haxeko/matter-temperature-sensor/README.md

# TH-SENSOR-H2 — nhiệt ẩm kế Matter over Thread (ESP32-H2, 1 × CR2450)

Thiết kế firmware và phần cứng (Rev B) cho một nhiệt ẩm kế không màn hình:

- module **ESP32-H2-MINI-1-H4S** (4 MB flash, anten PCB), **Matter over Thread** (Sleepy End Device, ICD SIT), BLE chỉ dùng khi commissioning;
- cảm biến **SHT40-AD1B-R3** trên một "lưỡi" PCB tách nhiệt, đo mỗi 60 s;
- nguồn **1 × CR2450** (holder SMT): P-MOSFET chống ngược cực, một bộ buck-boost TPS63900 ra 3.3 V, tụ đệm đầu vào 10 µF + 2 × 100 µF + 470 µF;
- một nút USER, một nút RST, một LED; không màn hình.

Firmware dùng ESP-IDF thuần (ESP-Matter chính thức, FreeRTOS, `i2c_master`, ADC có hiệu chuẩn, NVS, power management). PCB là KiCad 9 gốc, 2 lớp, 41.5 × 57.5 mm, sinh hoàn toàn bằng script trong `hardware/scripts/`.

Rev B thay Rev A (2 × CR2032, bo 72 × 58 mm) theo yêu cầu chỉ dùng một pin và bo gọn hơn; Rev A còn trong lịch sử git. Lý do chọn CR2450 thay vì một CR2032: `docs/decisions.md` D20.

Biến thể **TH-SENSOR-H2C Rev A** dùng **chip ESP32-H2FH4S rời** (QFN32) thay cho module: thạch anh 32 MHz, mạng phối hợp RF 0201, **ăng-ten in trên PCB** (inverted-F theo TI DN007), **PCB 4 lớp**, cùng kích thước bo, cùng đường nguồn và cùng firmware. File ở `hardware/chip/`, mô tả và giới hạn ở `docs/chip_variant.md`. Phần RF của biến thể này chưa đo và chưa chỉnh.

Biến thể **TH-SENSOR-H2W Rev A** dùng **module ESP32-H2-WROOM-02C-H4S** (người dùng tự mua và hàn, không có trong BOM JLC) trên một **bo 4 lớp vuông 37.6 × 37.6 mm tính cả phần ăng-ten của module nhô ra ngoài mép trên** (bo 37.6 × 31.6 mm); holder CR2450 ở mặt dưới, tụ đệm C5 là tụ tantal thấp nên cả cụm cao ≈ 12.3 mm (ước tính), một nút USER/BOOT bấm cạnh ở giữa mép trái (không có nút RST), J1 là 6 pad dán; gắn tường với cạnh có nút quay xuống đất (nút bấm từ dưới lên, lưỡi cảm biến ở góc dưới); mạch nguồn, cảm biến và firmware như Rev B. File ở `hardware/wroom/`, mô tả và giới hạn ở `docs/wroom_variant.md`.

Biến thể **TH-SENSOR-H2W-123 Rev A** là bo H2W chạy bằng **một pin CR123A** (1550 mAh) thay cho CR2450. Pin **không nằm trên bo**: bo chỉ mang phần mạch, **2 lớp**, **24.8 × 37.3 mm** (43.3 mm tính cả ăng-ten), pin đặt cạnh bo trong đế riêng và nối bằng hai dây; đặt cạnh một đế pin 18.2 × 43.3 mm thì cả cụm khoảng 43.3 × 43.3 mm. Không có tụ đệm 470 µF, có cầu chì tự phục hồi; pad nạp và test pad ở mặt sau; gắn tường với ăng-ten hướng lên, cảm biến và nút ở cạnh dưới. Theo mô hình (ƯỚC TÍNH), pin này cấp được mọi xung tải ở mọi trạng thái và cho tuổi thọ khoảng 2.3–2.6 năm. Pin sát bo chỉ cách ăng-ten khoảng 7 mm: tầm phủ CHƯA KIỂM THỬ. Chi tiết: `docs/cr123a_variant.md`.

## Trạng thái — đọc trước

Nhãn dùng trong toàn bộ repo: **ĐÃ XÁC MINH** (kiểm bằng công cụ hoặc đọc từ tài liệu gốc), **ƯỚC TÍNH** (tính toán/mô phỏng), **CHƯA KIỂM THỬ** (chưa có phần cứng).

| Hạng mục | Trạng thái | Bằng chứng |
|---|---|---|
| Firmware build: `battery`, `debug`, `battery` + lớp phủ sản xuất `prod`, `battery` + `cr123a`, `debug` + `cr123a` | ĐÃ XÁC MINH (ESP-IDF v5.5.5, 0 cảnh báo trong mã dự án; lần 2026-10-30 build sạch từ bản clone, lần 2026-11-11 build lại toàn bộ trong cây làm việc) | `docs/reports/firmware_build.md` |
| Firmware chạy trên chip (mọi profile; prod còn cần dữ liệu factory riêng từng máy) | **CHƯA KIỂM THỬ** | `docs/test_plan.md` |
| Unit test logic thuần trên host | ĐÃ XÁC MINH: 43 test, 264 kiểm tra, 0 lỗi | `docs/reports/host_tests.txt` |
| ERC schematic | ĐÃ XÁC MINH: 0 lỗi, 0 cảnh báo | `hardware/reports/erc_report.txt` |
| DRC PCB + schematic parity | ĐÃ XÁC MINH: 0 vi phạm, 0 pad chưa nối, 0 lỗi parity | `hardware/reports/drc_report.txt` |
| Pin map firmware ↔ schematic | ĐÃ XÁC MINH | `tools/check_pinmap.py`, `docs/pinmap.md` |
| Gerber, drill, BOM, CPL (định dạng JLC) | ĐÃ XÁC MINH là sinh được từ board; **chưa gửi nhà máy** | `hardware/production/` |
| Năng lượng, tuổi thọ pin | ƯỚC TÍNH — **CHƯA ĐẠT** | `docs/power_budget.md` |
| Điện, RF, cảm biến, Matter, dòng ngủ trên bo thật | **CHƯA KIỂM THỬ** (chưa có bo nào được làm) | `docs/test_plan.md` |
| OTA | **không triển khai** (`CONFIG_ENABLE_OTA_REQUESTOR=n`) | |
| Chứng nhận (Matter, FCC/CE, an toàn pin) | **không tuyên bố** | |
| Biến thể chip rời H2C: ERC, DRC + parity, pin map | ĐÃ XÁC MINH: 0 lỗi, 0 cảnh báo; 0 vi phạm, 0 pad chưa nối, 0 lỗi parity | `hardware/chip/reports/`, `tools/check_pinmap.py --variant chip` |
| Biến thể chip rời H2C: ăng-ten, phối hợp RF, thạch anh | **CHƯA KIỂM THỬ** — giá trị RF chỉ là giá trị khởi đầu, cần VNA để chỉnh | `docs/chip_variant.md` |
| Biến thể WROOM-02C H2W: ERC, DRC + parity, pin map | ĐÃ XÁC MINH: 0 lỗi, 0 cảnh báo; 0 vi phạm, 0 pad chưa nối, 0 lỗi parity | `hardware/wroom/reports/`, `tools/check_pinmap.py --variant wroom` |
| Biến thể WROOM-02C H2W: hàn tay module, ăng-ten trên bo này, ảnh hưởng của pin ở mặt dưới, hướng gắn tường | **CHƯA KIỂM THỬ** | `docs/wroom_variant.md` |
| Biến thể CR123A H2W-123: ERC, DRC + parity, pin map | ĐÃ XÁC MINH: 0 lỗi, 0 cảnh báo; 0 vi phạm, 0 pad chưa nối, 0 lỗi parity | `hardware/wroom123/reports/`, `tools/check_pinmap.py --variant wroom123` |
| Biến thể CR123A H2W-123: khả năng cấp xung và tuổi thọ pin | ƯỚC TÍNH (mô hình khớp theo đồ thị datasheet) | `hardware/analysis/results/cr123a_summary.md` |
| Biến thể CR123A H2W-123: ăng-ten khi pin cách module ~7 mm, đấu dây pin, phần trăm pin, mọi phép đo | **CHƯA KIỂM THỬ** | `docs/cr123a_variant.md` |

Chưa có đơn đặt PCB hay linh kiện nào. Chưa đo dòng, chưa ghép Matter với controller nào.

## Cảnh báo chính

1. **Thiết kế nguồn CHƯA ĐẠT** (ƯỚC TÍNH): theo mô hình, với CR2450 mới ở 25 °C mọi tải đều ổn, nhưng **khởi động và commissioning bị reset khi pin đã dùng khoảng một nửa** hoặc khi ≤ 0 °C (ngay cả pin mới). Từ giữa đời, một lần reset bất kỳ có thể làm thiết bị ngừng hoạt động tới khi thay pin; report hỏng khi pin gần cuối đời. Commission bằng pin mới ở nhiệt độ phòng. Tuổi thọ ở ~64 µA trung bình: **khoảng 0.55–0.77 năm, không phải 1–2 năm**. Điện trở xung của CR2450 là ước tính (không có số liệu công bố) và là rủi ro lớn nhất — đo trước khi làm nhiều bo (T-35). Phương án dự phòng (chưa áp dụng): `docs/power_budget.md` mục 7. Thiết kế không tự đổi sang pin khác.
2. **ESP32-H2-MINI-1-H4S tồn kho JLC = 0** (tra ngày 2026-10-29 và 2026-10-30) — chặn lắp ráp toàn bộ tại JLC; xem `docs/assembly.md`. Footprint holder CR2450 là footprint tự vẽ theo bản vẽ của nhà sản xuất: so với holder thật trước khi đặt PCB.
3. **Dữ liệu Matter thử nghiệm**: bản build mặc định dùng VID 0xFFF1 / PID 0x8000, passcode 20202021, discriminator 3840, DAC thử nghiệm — chỉ để phát triển, không bao giờ giao thiết bị như vậy.
4. **Không giả định** Apple Home, Google Home, Alexa, SmartThings, Home Assistant… sẽ chấp nhận firmware tự build này; thử lần đầu bằng `chip-tool` + OpenThread Border Router (`docs/commissioning.md`).
5. **Không bao giờ sao chép** toàn bộ flash/NVS, Thread dataset hay thông tin xác thực giữa các thiết bị.
6. **Biến thể chip rời (H2C)**: ESP32-H2FH4S tồn kho JLC = 0 (tra 2026-11-06); ăng-ten PCB và mạng phối hợp chưa mô phỏng, chưa đo — phải chỉnh bằng VNA trên bo thật; bo này không còn chứng nhận RF sẵn có của module. Xem `docs/chip_variant.md`.
7. **Biến thể WROOM-02C (H2W)**: module **không có trong BOM/CPL** (người dùng tự mua bản -H4S và hàn tay; pad tản nhiệt hàn qua lỗ 0.8 mm từ mặt dưới); holder ở **mặt dưới** (lắp ráp hai mặt hoặc tự hàn holder); dưới pin có via phủ mask. Xem `docs/wroom_variant.md`.
8. **Chỉ dùng CR2450, không sạc** (silkscreen mặt trên: "CR2450 ONLY" / "NO CHARGE" phía trên holder, dấu + và − ở hai đầu holder; mặt dưới: "CR2450 ONLY - NO CHARGE"; bản H2W: cả hai dòng và dấu +/− ở mặt dưới, cạnh holder). **Không bao giờ cấp nguồn bench khi pin đang nằm trong holder** — bo không có diode hay điện trở bảo vệ nối tiếp; xem `docs/limitations.md` mục 3.

## Sơ đồ khối

```
CR2450 ─ R1 0R ─ Q1 AO3401A ─ VIN ─ U1 TPS63900 (3.3 V) ─ VOUT ─ R21 0R ─ +3V3
 (BT1)  (đo dòng) (chống ngược)  │                         │     (đo dòng tải)
                       10 µF + 2 × 100 µF + 470 µF     22 µF + 2 × 100 µF

+3V3 ─┬─ U4 ESP32-H2-MINI-1-H4S ── I2C (GPIO10/11) ── U5 SHT40 (trên lưỡi tách nhiệt)
      ├─ U3 TPS3839K33 (2.93 V) ─ R22 ─ EN ── SW2 RST, TP6
      └─ LED (GPIO22), SW1 USER/BOOT (GPIO9), J1 debug (UART0, USB D+/D−; không có chân nguồn)
VBAT ─ 470k/470k (2N7002 đóng bằng GPIO12) ─ ADC1_CH4 (GPIO5)
```

Chi tiết và lý do chọn kiến trúc: `docs/architecture.md`, `docs/decisions.md`.

## Cấu hình linh kiện chính

| Linh kiện | Cấu hình | Nguồn |
|---|---|---|
| BT1 MYOUNG BS-24-B4AA016 | holder SMT CR2450, tiếp điểm mạ vàng; pad 1 = + (phải); footprint dự án theo bản vẽ MY-CP-0138 | datasheet LCSC C964809 |
| U1 TPS63900 | SEL = GND ⇒ VO(1) = 3.3 V (RCFG3 16.2 kΩ); RCFG1 0 Ω + RCFG2 10.5 kΩ ⇒ giới hạn dòng vào trung bình 100 mA; EN = VIN; L 2.2 µH Murata DFE201612E; vào 10 µF + 2 × 100 µF + C5 470 µF điện phân, ra 22 µF | TI SLVSET3D, bảng 7-2/7-3 |
| Q1 AO3401A | P-MOSFET chống lắp ngược cell: D phía cell, S phía VIN, G nối GND | |
| U3 TPS3839K33 | ngưỡng 2.93 V, trễ 200 ms, đẩy-kéo, qua R22 10 kΩ tới EN; C25 1 µF | TI SBVS193D |
| U5 SHT40-AD1B-R3 | I2C địa chỉ 0x44, 100 kHz, kéo lên 10 kΩ; lệnh đo độ lặp cao (0xFD), có kiểm CRC; không bật heater khi đo | Sensirion SHT4x v7.3 |
| Cầu chia pin | 470 kΩ / 470 kΩ + 22 nF từ cực + của holder, công tắc 2N7002 phía thấp; GPIO12 bật ~30 ms mỗi 6 h | |
| Y1 | 32.768 kHz Epson FC-135 (CL 12.5 pF), tụ tải 18 pF — ƯỚC TÍNH, chỉnh ở T-09 | |
| U4 | pin map đầy đủ (pad module ↔ GPIO ↔ net), chân strap, chân không dùng | `docs/pinmap.md` |

## Cấu trúc repo

```
firmware/                    dự án ESP-IDF (target esp32h2)
  main/                      app_main.cpp, app_controller.c, Kconfig.projbuild
  components/                sht40, battery, board, user_button, matter_bridge,
                             power_guard, app_config, maint_console, app_logic
  test/host/                 unit test chạy trên máy host
  sdkconfig.defaults(.battery|.debug|.prod), partitions.csv, dependencies.lock
hardware/
  scripts/                   design.py (BOM + netlist nguồn), gen_schematic.py, gen_pcb.py, gen_pcb_chip.py,
                             gen_pcb_wroom.py, gen_pcb_wroom123.py, router.py, gen_project.py, gen_reports.py,
                             gen_production.py
  kicad/                     th_sensor_h2.kicad_sch / .kicad_pcb / .kicad_pro, thư viện riêng (lib/)
  production/                Gerber + drill (zip), BOM/CPL JLC, bản vẽ lắp ráp, trở ngại sản xuất
  reports/                   ERC, DRC, routing log, tóm tắt
  renders/                   schematic.pdf, ảnh PCB (SVG, 3D PNG)
  analysis/                  power_model.py và kết quả mô phỏng
  chip/                      biến thể chip rời H2C: kicad/, production/, reports/, renders/
  wroom/                     biến thể WROOM-02C H2W: kicad/, production/, reports/, renders/
  wroom123/                  biến thể CR123A H2W-123: kicad/, production/, reports/, renders/
tools/                       check_pinmap.py, jlc_lookup.py
docs/                        tài liệu thiết kế (danh sách bên dưới), docs/reports/
```

## Firmware

### Khóa phiên bản

| Thành phần | Phiên bản | Khóa ở đâu |
|---|---|---|
| ESP-IDF | v5.5.5 (toolchain riscv32-esp-elf GCC 14.2.0, esp-14.2.0_20260121) | `firmware/main/idf_component.yml` (`idf: ==5.5.5`) |
| espressif/esp_matter | 1.6.0~1 | `idf_component.yml` (`==`), phiên bản + hash đầy đủ trong `firmware/dependencies.lock` |
| espressif/button | 4.2.1 | như trên |
| KiCad | 9.0.9 (phần cứng) | `docs/sources.md` |

Đổi bất kỳ phiên bản nào ở trên là một thay đổi thiết kế: build lại mọi cấu hình và chạy lại unit test.

### Cài toolchain

```sh
git clone -b v5.5.5 --recursive https://github.com/espressif/esp-idf.git ~/esp/esp-idf-v5.5.5
cd ~/esp/esp-idf-v5.5.5 && ./install.sh esp32h2
```

Component manager tự tải `espressif/esp_matter`, `espressif/button` và các phụ thuộc theo `firmware/dependencies.lock` ở lần build đầu (cần mạng); không cần checkout ESP-Matter riêng. Đã dùng CMake 3.28 và Ninja 1.11.

### Build, nạp, monitor

```sh
. ~/esp/esp-idf-v5.5.5/export.sh
cd firmware
P=battery                                    # hoặc: debug
idf.py -B build_$P -D SDKCONFIG=build_$P/sdkconfig \
       -D SDKCONFIG_DEFAULTS="sdkconfig.defaults;sdkconfig.defaults.$P" build
idf.py -B build_$P -D SDKCONFIG=build_$P/sdkconfig \
       -D SDKCONFIG_DEFAULTS="sdkconfig.defaults;sdkconfig.defaults.$P" -p /dev/ttyACM0 flash monitor
```

| Profile | Dùng khi | Khác biệt |
|---|---|---|
| `battery` | chạy bằng pin | log WARN, power guard bật |
| `debug` | bring-up bằng nguồn bench | log INFO, power guard tắt |
| `prod` (lớp phủ thêm sau `battery`) | sản xuất, cần dữ liệu factory riêng từng máy | build được; chạy CHƯA KIỂM THỬ — `docs/commissioning.md` mục 5 |
| `cr123a` (lớp phủ thêm sau `battery` hoặc `debug`) | bo H2W-123 chạy pin CR123A | bảng phần trăm, chuỗi IEC/dung lượng và ngưỡng pin của CR123A — `docs/cr123a_variant.md` mục 7 |

Nạp firmware qua USB-Serial/JTAG trên J1 (D+, D−, GND; 1×6 pad không lắp sẵn). J1 không có chân nguồn: bo phải chạy bằng pin, hoặc **tháo pin** rồi cấp 3.0 V (giới hạn ~150 mA) vào TP1 (VBAT, +) và TP5 (GND). Vào chế độ download bằng tay: giữ USER (SW1, GPIO9) trong khi nhấn và thả RST (SW2). Trên thiết bị đã có dữ liệu factory, **không** chạy `idf.py erase-flash` (xóa luôn phân vùng `fctry` và `esp_secure_cert`).

### Nút và LED

| Thao tác nút USER | Hành động | LED |
|---|---|---|
| Nhấn ngắn | đo ngay (tối đa 1 lần / 5 s) | 1 nháy nếu đo được, 2 nháy dài nếu lỗi |
| Nhấn 3 lần trong 2 s | mở cửa sổ commissioning 180 s, **giữ nguyên các fabric**; nếu thiết bị đã bị gỡ khỏi mọi ứng dụng thì tự khởi động lại rồi quảng bá BLE 180 s | 3 nháy |
| Giữ ≥ 10 s rồi thả | factory reset (fabric, Thread, cấu hình app; không xóa dữ liệu factory) | sáng liên tục khi đủ 10 s, 8 nháy khi chấp nhận |
| Giữ ≥ 60 s | coi là kẹt nút, không reset | tắt |

LED nháy chậm 3 lần rồi tắt hẳn ngay sau khi lắp pin hoặc reset: thiết bị vừa bị reset hai lần liên tiếp trước khi chạy đủ 10 phút (hoặc pin < 2.4 V) và đang ngủ sâu 5 phút … 4 giờ để tránh vòng lặp sụt áp. **Nhấn USER để đánh thức ngay.**

Chi tiết: `docs/architecture.md` mục 4.4.

### Console bảo trì (USB-Serial/JTAG)

`status` (cảm biến, pin, Matter/Thread, power guard, heap), `measure`, `battery`, `config` / `config set <key> <value>` (khóa: `temp_offset`, `rh_offset`, `meas_interval`, `bat_interval`, `temp_deadband`, `rh_deadband`, `led`, `tx_power`; chỉ ghi NVS khi giá trị đổi), `heater <20|110> <100|1000>` (xung heater để bảo trì; số đo lúc nóng không được phát; phép đo thường không bao giờ bật heater), `window`, `factory_reset confirm`, `reboot`. Khi USB đang nối, chip không vào light sleep (có chủ đích): rút USB khi đo dòng ngủ.

### Ghép Matter (tóm tắt, CHƯA KIỂM THỬ trên thiết bị)

1. Chuẩn bị một OpenThread Border Router và `chip-tool`; lấy active operational dataset (hex) của mạng Thread.
2. Dùng **CR2450 mới ở nhiệt độ phòng**, hoặc nguồn bench vào TP1/TP5 sau khi tháo pin (mô hình dự đoán reset khi commissioning với pin đã dùng một nửa hoặc khi lạnh).
3. Thiết bị chưa có fabric quảng bá BLE 180 s sau khi khởi động; quá thời gian thì nhấn USER 3 lần.
4. Với dữ liệu thử nghiệm của bản build mặc định:
   ```sh
   chip-tool pairing ble-thread 1 hex:<dataset> 20202021 3840
   chip-tool temperaturemeasurement read measured-value 1 1
   chip-tool relativehumiditymeasurement read measured-value 1 2
   chip-tool powersource read bat-voltage 1 0
   ```
5. Thêm hệ sinh thái thứ hai: nhấn USER 3 lần (giữ fabric cũ) hoặc dùng chức năng chia sẻ của controller đầu tiên.

Reset: nút RST = reset phần cứng (EN); factory reset = giữ USER ≥ 10 s rồi thả, hoặc `factory_reset confirm`. Chi tiết, xử lý sự cố, dữ liệu sản xuất: `docs/commissioning.md`.

### Unit test trên host

```sh
cmake -S firmware/test/host -B build/host-tests
cmake --build build/host-tests
ctest --test-dir build/host-tests --output-on-failure
```

## Phần cứng

Cần: KiCad **9.0** có module Python `pcbnew` và `kicad-cli` (đã dùng 9.0.9), Python 3 với numpy. Thư viện chuẩn của KiCad đọc từ `/usr/share/kicad/`. Symbol, footprint, mô hình 3D của module lấy từ thư viện Espressif và đã được sao vào `hardware/kicad/lib/`; chỉ cần bản checkout thư viện đó (biến `ESPRESSIF_KICAD_LIB`) khi muốn làm mới các bản sao.

Tái tạo toàn bộ, theo thứ tự (chạy từ gốc repo):

```sh
python3 hardware/scripts/gen_schematic.py    # schematic, thư viện dự án, kiểm parity với design.py
python3 hardware/scripts/gen_pcb.py          # đặt linh kiện, đi dây (router.py), đổ đồng, silkscreen (~20 s)
python3 hardware/scripts/gen_project.py      # .kicad_pro: luật thiết kế JLC 2 lớp, net class
python3 hardware/scripts/gen_reports.py      # ERC, DRC + parity, PDF/SVG/3D
python3 hardware/scripts/gen_production.py   # Gerber, drill, BOM, CPL, bản vẽ lắp ráp
python3 tools/check_pinmap.py                # board_pins.h ↔ netlist
```

Chạy lại chuỗi trên cho ra schematic và board **giống từng byte**; chỉ dấu thời gian trong Gerber/drill/báo cáo/PDF/ZIP và ảnh render 3D thay đổi.

Biến thể chip rời: cùng chuỗi với biến môi trường `TH_VARIANT=chip` và `gen_pcb_chip.py` thay cho `gen_pcb.py`; kết quả ghi vào `hardware/chip/` (`docs/chip_variant.md` mục 11). Biến thể WROOM-02C: `TH_VARIANT=wroom` và `gen_pcb_wroom.py`; kết quả ở `hardware/wroom/` (`docs/wroom_variant.md` mục 11). Biến thể CR123A: `TH_VARIANT=wroom123` và `gen_pcb_wroom123.py`; kết quả ở `hardware/wroom123/` (`docs/cr123a_variant.md` mục 10). Không đặt biến thì mọi script sinh Rev B như trước.

### Bring-up và đo dòng

Điểm đo trên bo (silkscreen ghi tên net): VBAT (cực + của cell), VIN (sau P-MOSFET), VOUT (ra bộ chuyển đổi), 3V3, GND, EN; BOOT ở J1 chân 5. Link đo dòng: R1 (dòng cell), R21 (tải 3V3), đều là 0R 0805. Với một cell, "VBAT1/VBAT2/VBAT_OR" của yêu cầu gốc thu lại thành VBAT (TP1) và VIN (TP2).

1. **Trước khi lắp pin** (T-01…T-08): kiểm ngắn mạch; tháo R21; cấp nguồn bench có giới hạn dòng vào TP1; kiểm VOUT = 3.30 V; thử ngược cực và dòng ngược; kiểm supervisor (nRST, EN); so footprint holder với holder thật và kiểm cực bằng một cell (rồi tháo cell ra).
2. Hàn lại R21, nạp firmware `debug`, chạy `status`, `measure`, `battery` (T-09…T-17).
3. Commissioning và kiểm Matter (T-20…T-25).
4. **Đo dòng** (T-30…T-39): tháo R21 (dòng tải 3V3) hoặc R1 (dòng cell), nối máy đo dòng lấy mẫu nhanh (PPK2, Joulescope…) vào hai pad, **rút USB** (USB-Serial/JTAG giữ chip thức). Đo đáy ngủ, điện tích mỗi poll/report, dạng dòng khởi động và commissioning, điện trở xung của CR2450 (T-35, nên làm sớm nhất), dòng rò tụ điện phân, dòng trung bình 24 h; rồi chạy lại `power_model.py` với số đo và cập nhật `docs/power_budget.md`.

Tiêu chí đạt và thứ tự đầy đủ: `docs/test_plan.md`.

Mô hình năng lượng: `python3 hardware/analysis/power_model.py --plots` (~6 phút). Tra lại tồn kho JLC trước khi đặt: `python3 tools/jlc_lookup.py --json <mã LCSC…>` (endpoint không chính thức của trang jlcpcb.com/parts).

## Tài liệu

| File | Nội dung |
|---|---|
| `docs/architecture.md` | sơ đồ khối, đường nguồn, firmware, data model Matter, ICD, nút/LED |
| `docs/pinmap.md` | bảng chân module ↔ net ↔ GPIO (sinh bằng `check_pinmap.py --markdown`), J1 |
| `docs/power_budget.md` | ngân sách dòng, tuổi thọ 25/50/100/200 µA, mô phỏng xung, tụ đệm, chế độ hỏng, phương án dự phòng |
| `docs/decisions.md` | các quyết định thiết kế và lý do (D1–D22; D20 = Rev B, một CR2450; D21 = biến thể chip rời; D22 = biến thể WROOM-02C) |
| `docs/chip_variant.md` | biến thể chip rời H2C: khác biệt, đối chiếu HDG, ăng-ten, phối hợp RF, stack-up 4 lớp, kiểm thử C-01…C-08 |
| `docs/cr123a_variant.md` | biến thể CR123A H2W-123: vì sao CR123A (mô hình), bo 24.8 × 37.3 mm với pin nằm ngoài bo, nối pin và cầu chì, lớp cấu hình firmware, kiểm thử K-01…K-08 |
| `docs/wroom_variant.md` | biến thể WROOM-02C H2W: kích thước vuông, vị trí module theo HDG, holder mặt dưới, C5 tantal, hướng gắn tường, hàn tay module, nút bấm cạnh, kiểm thử W-01…W-08 |
| `docs/commissioning.md` | ghép Matter, cửa sổ commissioning, factory reset, dữ liệu sản xuất |
| `docs/assembly.md` | file sản xuất, kiểm tra preview JLC, lắp tay, link đo dòng |
| `docs/test_plan.md` | kế hoạch bring-up và kiểm thử T-01…T-42 |
| `docs/limitations.md` | giới hạn và rủi ro đã biết |
| `docs/sources.md` | datasheet, tài liệu và phiên bản công cụ đã dùng |
| `docs/reports/` | báo cáo build firmware, kết quả unit test |
| `hardware/reports/` | ERC, DRC, routing log |

## Giấy phép

Chưa chọn giấy phép cho dự án (quyết định của chủ repo). Symbol, footprint và mô hình 3D ESP32-H2-MINI-1 trong `hardware/kicad/lib/`, cùng symbol ESP32-H2 và footprint QFN32 trong `hardware/chip/kicad/lib/`, lấy từ thư viện KiCad của Espressif và theo giấy phép của thư viện đó (`LICENSE-espressif-kicad-libraries.md` trong từng thư mục). Symbol và footprint ESP32-H2-WROOM-02C trong `hardware/wroom/kicad/lib/` do `gen_schematic.py` vẽ theo datasheet của module.
