haxeko/matter-temperature-sensor/hardware/wroom123/reports/drc_report.txt

** Drc report for th_sensor_h2w123.kicad_pcb **
** Created on 2026-11-11T07:16:01+0000 **
** Report includes: Errors, Warnings, Exclusions **

** Found 0 DRC violations **

** Found 0 unconnected pads **

** Found 0 Footprint errors **

** End of Report **
