haxeko/matter-temperature-sensor/hardware/wroom123/reports/summary.md

# Check summary

Generated 2026-11-11 07:16 UTC by `hardware/scripts/gen_reports.py` with kicad-cli 9.0.9.

| Check | Result | Report |
|---|---|---|
| ERC (all severities) | 0 messages, 0 errors, 0 warnings | erc_report.txt |
| DRC (all severities) | 0 violations | drc_report.txt |
| DRC unconnected pads | 0 | drc_report.txt |
| Schematic parity (footprints vs schematic) | 0 footprint errors | drc_report.txt |

Routing log: routing_log.txt (gen_pcb.py). These are design-rule checks only; no board has been made or tested.
