haxeko/matter-temperature-sensor/hardware/wroom123/production/orientation_check.md

# Orientation check for the JLC placement preview

Generated by `hardware/scripts/gen_production.py` from the board file. Board viewed from the top,
X to the right, Y up (CPL convention). For each polarised part the offset of pad 1 from the part
centre is given; in the JLC preview the pin-1 / polarity mark of the part model must sit on that
side. If it does not, correct the rotation in JLC's tool (not in KiCad) and record it here.

| Ref | Value | KiCad rotation | Pad 1 | Pad 1 direction | Pad 1 offset X, Y (mm) |
|---|---|---|---|---|---|
| D3 | red | 90 | pad 1 = cathode | down | 0.00, -0.79 |
| Q1 | AO3401A | 180 | pin 1 (gate) | right / down | 0.94, -0.95 |
| Q3 | 2N7002 | 180 | pin 1 (gate) | right / down | 0.94, -0.95 |
| U1 | TPS63900DSKR | 90 | pin 1 | left / down | -1.00, -1.21 |
| U3 | TPS3839K33DBZR | 0 | pin 1 | left / up | -0.94, 0.95 |
| U5 | SHT40-AD1B-R3 | 180 | pin 1 | right / down | 0.70, -0.40 |
