haxeko/matter-temperature-sensor/docs/sources.md

# Nguồn tài liệu

Phiên bản tài liệu là bản đã đọc khi thiết kế (2026-10). Đường dẫn của nhà sản xuất có thể đổi; tên và mã phiên bản là thứ cần đối chiếu.

## Espressif

| Tài liệu | Phiên bản | Dùng cho |
|---|---|---|
| ESP32-H2-MINI-1 & MINI-1U Datasheet — https://www.espressif.com/sites/default/files/documentation/esp32-h2-mini-1_mini-1u_datasheet_en.pdf | v1.6 | sơ đồ chân module (bảng 3), vùng keepout anten trên module, dòng TX/RX, kích thước |
| ESP32-H2 Series Datasheet — https://www.espressif.com/sites/default/files/documentation/esp32-h2_datasheet_en.pdf | v1.3 | chân strap (GPIO8/9/25), GPIO25 không có pull nội (mục 3.3), ADC1 |
| ESP32-H2 Hardware Design Guidelines — https://docs.espressif.com/projects/esp-hardware-design-guidelines/en/latest/esp32h2/ | bản "latest" 2026-10 | vị trí module và vùng keepout anten (hình "Keepout Zone ... feed point on the left"), thạch anh, USB, UART |
| ESP-Matter `examples/icd_app` — https://github.com/espressif/esp-matter/tree/main/examples/icd_app | esp_matter 1.6.0~1 | cấu hình ICD SIT, số đo dòng ngủ/poll của Espressif |
| Espressif KiCad libraries — https://github.com/espressif/kicad-libraries | git dd76561812ab300351234ba6e0ec1295641796f0 | symbol, footprint, mô hình 3D ESP32-H2-MINI-1 (CC-BY-SA 4.0 với ngoại lệ cho thiết kế; bản sao + license trong `hardware/kicad/lib/`); **H2C**: symbol "ESP32-H2" và footprint QFN-32-1EP_4x4mm_P0.4mm_EP2.9x2.9mm (bản sao trong `hardware/chip/kicad/lib/`) |
| ESP32-H2-WROOM-02C Datasheet — https://espressif.com/sites/default/files/documentation/esp32-h2-wroom-02c_datasheet_en.pdf | v1.2, đọc 2026-11-06 | **H2W**: bảng 2 (định nghĩa chân), hình 6 (kích thước, ăng-ten 6 mm, feed bên phải), hình 7 (land pattern, pad tản nhiệt), chương 8 (sơ đồ module: VBAT–3V3 qua 0 Ω, EN không có RC, TXD0 499 Ω), chương 9 (sơ đồ ngoại vi: 10 µF + 0.1 µF ở 3V3), mã -H2S/-H4S, MSL 3, reflow |
| ESP32-H2 Hardware Design Guidelines, mục "Positioning a Module on a Base Board" — https://docs.espressif.com/projects/esp-hardware-design-guidelines/en/latest/esp32h2/pcb-layout-design.html | bản "latest", đọc 2026-11-06 | **H2W**: ăng-ten module đặt ngoài bo, feed gần mép bo; hình "antenna feed point on the right" (vị trí ③ và ④ được đánh dấu ✓); via GND dày gần ăng-ten; ≥ 15 mm khoảng trống quanh ăng-ten trong vỏ; UART/USB xa ăng-ten |
| ESP32-H2 Hardware Design Guidelines, chương "Schematic Checklist" và "PCB Layout Design" — cùng địa chỉ | v1.6 (2025-06-05), đọc 2026-11-06 | **H2C**: tụ decoupling từng chân, thạch anh 32 MHz ±10 ppm + 24 nH, mạng CLC(CL) 0201 và stub 15 mil / 100 Ω, đường RF 50 Ω, stack-up 4 lớp, ≥ 9 via pad đáy, UART 499 Ω, USB 90 Ω |

## Texas Instruments

| Tài liệu | Phiên bản | Dùng cho |
|---|---|---|
| TPS63900 datasheet — https://www.ti.com/lit/ds/symlink/tps63900.pdf | SLVSET3D (10/2020) | chân, bảng cấu hình RCFG (7-2, 7-3), UVLO, giới hạn dòng vào, ví dụ layout (hình 10-1), land pattern DSK |
| TPS3839 datasheet — https://www.ti.com/lit/ds/symlink/tps3839.pdf | SBVS193D (07/2015) | ngưỡng K33 2.93 V, trễ 200 ms, 150 nA |
| SWRA349 "Coin cells and peak current draw" — https://www.ti.com/lit/an/swra349/swra349.pdf | — | điện trở xung CR2032 theo mức xả (hình 6, cơ sở cho CR2450 sau khi nhân tỉ lệ diện tích), công thức tụ đệm |
| Application Report "2.4-GHz Inverted F Antenna" (DN007) — https://www.ti.com/lit/an/swru120d/swru120d.pdf | SWRU120D (sửa đổi 01/2019) | **H2C**: hình học ăng-ten IFA (Figure 1-1, Table 1-1; hai chân đất và đoạn feed 45° đo từ hình); bo tham chiếu FR-4 dày 1 mm; khuyến nghị mạng pi sát điểm feed |

## Pin và holder

| Tài liệu | Phiên bản | Dùng cho |
|---|---|---|
| Panasonic CR2450 — https://energy.panasonic.com/na/business/products/lithium/coin-cr-standard/models/CR2450 (datasheet PDF `CR2450_Datasheet_EN.pdf` trên trang) | 2026 | **Rev B**: 3 V, 620 mAh, dòng liên tục 0.2 mA, Ø24.5 × 5.0 mm, 6.2 g, −30…+85 °C; đường "capacity vs load"; đường kính trong trên bản vẽ (tỉ lệ diện tích dùng trong mô hình) |
| Panasonic CR2032 — https://energy.panasonic.com/na/business/products/lithium/coin-cr-standard/models/CR2032 (datasheet PDF trên trang) | 2026 | 3 V, 225 mAh, dòng liên tục 0.2 mA, −30…+85 °C, đường điện áp theo tải và nhiệt độ (cơ sở của mô hình cell; Rev A) |
| Panasonic Lithium Handbook (trang tải: https://energy.panasonic.com/eu/business/downloads/material) | 2025 | diode chặn ngược + điện trở bảo vệ khi cell có thể bị nạp, tổng điện tích nạp ≤ 3 % dung lượng với coin cell |
| MYOUNG BS-24-B4AA016 — datasheet trên LCSC: https://www.lcsc.com/datasheet/lcsc_datasheet_2012181809_MYOUNG-BS-24-B4AA016_C964809.pdf | bản vẽ MY-CP-0138 (2018-05-30) | **Rev B**: holder SMT CR2450, kích thước thân, land pattern (footprint dự án), cực +; −25…+85 °C, tiếp điểm đồng phosphor mạ vàng (mô tả LCSC). **H2W**: land pattern 37.00 mm quyết định bề rộng bo; hình cắt (pin nằm trên đáy nhựa của holder) là cơ sở cho via dưới pin |
| KNSCHA RVT 470 µF 6.3 V (RVT470UF6.3V67RV0038) — datasheet trên LCSC: https://wmsc.lcsc.com/wmsc/upload/file/pdf/v2/lcsc/2109301630_KNSCHA-RVT470UF6-3V67RV0038_C2901342.pdf | — | **Rev B**: tụ đệm C5, Ø6.3 × 7.7 mm, ±20 %, 2000 h ở 105 °C, dòng rò ≤ 0.01 CV hoặc 3 µA sau 2 phút ở điện áp định mức |
| Kyocera AVX TAJ Series (Standard and Low Profile Tantalum Capacitors) — https://datasheets.kyocera-avx.com/TAJ.pdf | TDS-PTNO-0024 Rev 3, đọc 2026-11-08 | **H2W**: tụ đệm C5 TAJD477K006RNJ (LCSC C7229): vỏ D 7343-31 7.30 × 4.30 × 2.90 mm (chiều cao +0.20/−0.10), 470 µF ±10 %, 6.3 V tới 85 °C, DCL ≤ 28 µA (điện áp định mức, sau 5 phút), DF ≤ 12 %, ESR ≤ 0.4 Ω ở 100 kHz, MSL 1 (khuyên dùng bản dry pack), vạch cực = anode (+), −55…+125 °C, ΔC/C +0/−10 % ở −55 °C |
| Keystone 1060 (catalog coin cell holders) | catalog M65 | holder CR2032 của Rev A (không còn dùng) |
| Panasonic CR123A (CR Cylindrical-type Lithium Battery, Standard type) — https://energy.panasonic.com/dam/master/pdf/en/datasheet/lithium/CR123A_Datasheet_EN.pdf | July 2024, đọc 2026-11-10 | **H2W-123**: 3 V, 1550 mAh, dòng liên tục chuẩn 20 mA, Ø17.0 × 34.5 mm, ≈ 16 g, −40…+70 °C; đồ thị xả liên tục 20 mA–1 A (cơ sở của mô hình pin và bảng phần trăm) và xả xung 0.9 A ở +20 / −20 °C |
| Energizer 123 Product Datasheet — https://data.energizer.com/pdfs/123.pdf | form 123GL1018, đọc 2026-11-10 | **H2W-123**: IEC CR17345, 1500 mAh tới 2.0 V, tối đa 1500 mA liên tục / 3500 mA xung (lý do có F1), −40…+60 °C, có PTC bên trong |
| MYOUNG BH-123A-A1CJ002 — datasheet trên LCSC (C5290177) | bản vẽ MY-CP-0398 (2024-03-07), đọc 2026-11-11 | **H2W-123**: ví dụ đế CR123A đặt ngoài bo (không có trong BOM), thân 43.3 × 18.2 × 14.2 mm, hai chân dẹt cách 37.5 mm, −25…+85 °C; kích thước dùng để tính khung vuông 43.3 mm |
| BHFUSE BSMD1206-050-6V — trang linh kiện JLCPCB/LCSC C883122 | đọc 2026-11-11 | **H2W-123**: F1, PTC tự phục hồi 1206, giữ 0.5 A, ngắt 1 A, 6 V, 100 A, 0.15–0.7 Ω (số của trang linh kiện; chưa đọc datasheet đầy đủ của hãng) |
| Panasonic Light Touch Switches EVQP7/P3/9P7 — datasheet LCSC: https://www.lcsc.com/datasheet/lcsc_datasheet_2304140030_PANASONIC-EVQP7A01P_C79167.pdf | 01 Sep. 2013 | **H2W**: SW1 EVQP7A01P bấm cạnh, không chốt, 3.5 × 2.9 × 1.35 mm, 2.2 N, land pattern tham khảo (trùng footprint KiCad `SW_SPST_EVQP7A`) |

## Sensirion

| Tài liệu | Phiên bản | Dùng cho |
|---|---|---|
| SHT4x datasheet — trang sản phẩm https://sensirion.com/products/catalog/SHT40 | Version 7.3 (06/2026) | độ chính xác điển hình ±0.2 °C / ±1.8 %RH, dòng 0.4 µA trung bình / 80 nA idle, nhiệt trở (mục 5.5), lệnh heater, tham chiếu "Handling Instructions SHT" |

## Linh kiện khác (datasheet qua LCSC/nhà sản xuất)

AO3401A (Alpha & Omega, Vgs(th) −0.5/−0.9/−1.3 V), 2N7002 (JSCJ), Murata DFE201612E-2R2M, Epson FC-135 32.768 kHz (CL 12.5 pF), XKB TS-1187A. B5819W (JSCJ) và RB521S30T1G (onsemi rev. 9) chỉ còn trong mô hình (các kiến trúc Rev A).

## Linh kiện của biến thể chip rời (H2C)

ESP32-H2FH4S (Espressif, mã đặt hàng trong datasheet ESP32-H2 v1.3), YXC X322532MLB4SI 32 MHz (thông số theo trang LCSC C5210649, chưa đối chiếu datasheet YXC), Murata LQW18AN24NG00D 24 nH, Murata GRM0335C1H1R5BA01D 1.5 pF 0201 và LQP03TN2N4B02D 2.4 nH 0201 (cùng họ linh kiện HDG nêu), UNI-ROYAL 0201WMF0000TEE 0 Ω.

## PCB nhiều lớp (H2C)

| Tài liệu | Phiên bản | Dùng cho |
|---|---|---|
| JLCPCB impedance / stack-up — https://jlcpcb.com/impedance | đọc 2026-11 | JLC04161H-7628: prepreg 7628 0.2104 mm εr 4.4, lõi 1.065 mm εr 4.6, đồng ngoài 35 µm, đồng trong 15.2 µm |
| JLCPCB PCB capabilities — https://jlcpcb.com/capabilities/pcb-capabilities | đọc 2026-11-06 | nhiều lớp 0.09 / 0.09 mm, via 0.15 / 0.25 mm, lỗ 0.2 mm không phụ phí từ pad 0.45 mm, đồng tới mép phay ≥ 0.2 mm, via-in-pad lấp epoxy mặc định từ 6 lớp, dung sai trở kháng ±10 % |
| JLCPCB, hướng dẫn máy tính trở kháng — https://jlcpcb.com/help/article/user-guide-to-the-jlcpcb-impedance-calculator | cập nhật 2026-09-16 | lõi NP-155F, solder mask εr 3.8 (chưa dùng máy tính: trở kháng trong `docs/chip_variant.md` là công thức Hammerstad–Jensen) |

## Nguồn cung

- JLCPCB parts search (công cụ `tools/jlc_lookup.py`, endpoint của trang jlcpcb.com/parts, không phải API công bố chính thức) — ảnh chụp dữ liệu 2026-10-30 06:47 UTC trong `hardware/production/jlc_parts_snapshot.jsonl` (lần tra trước: 2026-10-29 08:55 UTC, Rev A); biến thể H2C: 2026-11-06 07:12 UTC trong `hardware/chip/production/jlc_parts_snapshot.jsonl`; biến thể H2W: 2026-11-08 08:06 UTC trong `hardware/wroom/production/jlc_parts_snapshot.jsonl` (module WROOM-02C không tra: người dùng tự mua); biến thể H2W-123: 2026-11-11 02:15 UTC trong `hardware/wroom123/production/jlc_parts_snapshot.jsonl`.

## Công cụ đã dùng

| Công cụ | Phiên bản |
|---|---|
| ESP-IDF | v5.5.5 |
| espressif/esp_matter | 1.6.0~1 |
| espressif/button | 4.2.1 |
| KiCad (kicad-cli, pcbnew Python) | 9.0.9 |
| Python | 3.13; numpy cho router; mô hình năng lượng chỉ dùng thư viện chuẩn (matplotlib khi chạy `--plots`) |
