haxeko/matter-temperature-sensor/hardware/wroom123/renders/pcb_3d_bottom.png

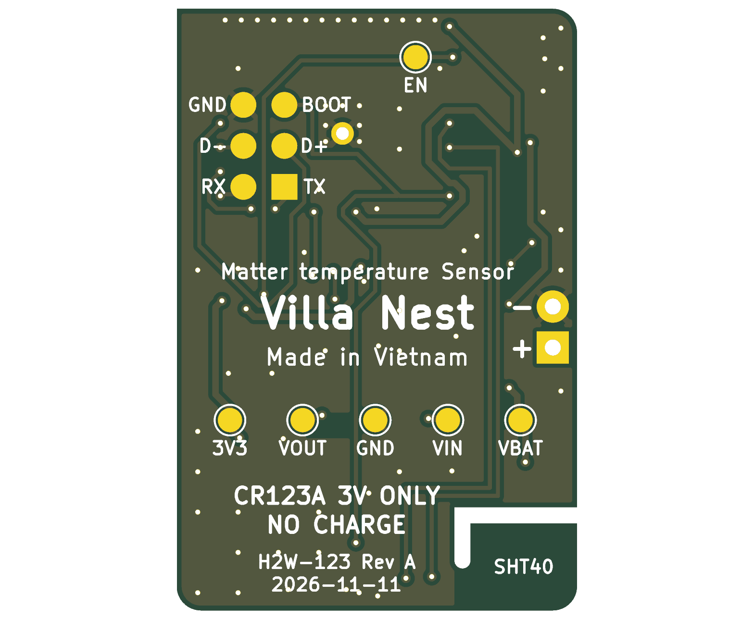
hardware/wroom123/renders/pcb_3d_bottom.png
