haxeko/matter-temperature-sensor/hardware/wroom123/renders/pcb_3d_iso.png

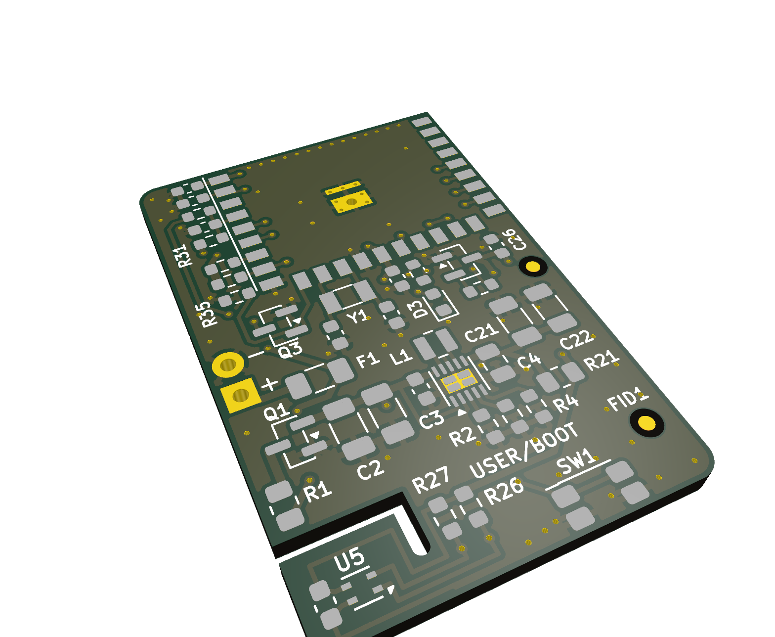
hardware/wroom123/renders/pcb_3d_iso.png
