haxeko/matter-temperature-sensor/hardware/wroom123/production/bom_jlc.csv

Comment | Designator | Footprint | LCSC Part # | Manufacturer | MPN | Qty | JLC library | JLC stock | Stock checked
10uF 10V X5R 0603 | C1,C23 | C_0603_1608Metric | C19702 | Samsung | CL10A106KP8NNNC | 2 | Basic | 9600441 | 2026-11-11 02:15 UTC
100uF 6.3V X5R 1206 | C2,C3,C21,C22 | C_1206_3216Metric | C15008 | Samsung | CL31A107MQHNNNE | 4 | Basic | 1605881 | 2026-11-11 02:15 UTC
1uF 0603 | C25 | C_0603_1608Metric | C15849 | Samsung | CL10A105KB8NNNC | 1 | Basic | 12307470 | 2026-11-11 02:15 UTC
100nF 0603 | C24,C26,C29 | C_0603_1608Metric | C14663 | YAGEO | CC0603KRX7R9BB104 | 3 | Basic | 36346845 | 2026-11-11 02:15 UTC
18pF 50V C0G 0603 | C27,C28 | C_0603_1608Metric | C1647 | Samsung | CL10C180JB8NNNC | 2 | Basic | 394613 | 2026-11-11 02:15 UTC
22nF 0603 | C31 | C_0603_1608Metric | C21122 | Samsung | CL10B223KB8NNNC | 1 | Basic | 1023968 | 2026-11-11 02:15 UTC
22uF 25V X5R 0805 | C4 | C_0805_2012Metric | C45783 | Samsung | CL21A226MAQNNNE | 1 | Basic | 3818412 | 2026-11-11 02:15 UTC
red | D3 | LED_0603_1608Metric | C2286 | KENTO | KT-0603R | 1 | Basic | 6230550 | 2026-11-11 02:15 UTC
0.5A PTC 6V hold 0.5A trip 1A 1206 | F1 | Fuse_1206_3216Metric | C883122 | BHFUSE | BSMD1206-050-6V | 1 | Extended | 42372 | 2026-11-11 02:15 UTC
2.2uH | L1 | L_Murata_DFE201612E | C337893 | Murata | DFE201612E-2R2M=P2 | 1 | Extended | 34245 | 2026-11-11 02:15 UTC
AO3401A | Q1 | SOT-23 | C15127 | Alpha & Omega | AO3401A | 1 | Basic | 1631248 | 2026-11-11 02:15 UTC
2N7002 | Q3 | SOT-23 | C8545 | JSCJ | 2N7002 | 1 | Basic | 5856189 | 2026-11-11 02:15 UTC
0R 1% 0805 | R1,R21 | R_0805_2012Metric | C17477 | UNI-ROYAL | 0805W8F0000T5E | 2 | Basic | 4041504 | 2026-11-11 02:15 UTC
0R 1% 0603 | R2 | R_0603_1608Metric | C21189 | UNI-ROYAL | 0603WAF0000T5E | 1 | Basic | 18400501 | 2026-11-11 02:15 UTC
10k 1% 0603 | R22,R23,R24,R26,R27 | R_0603_1608Metric | C25804 | UNI-ROYAL | 0603WAF1002T5E | 5 | Basic | 45074595 | 2026-11-11 02:15 UTC
1k 1% 0603 | R25 | R_0603_1608Metric | C21190 | UNI-ROYAL | 0603WAF1001T5E | 1 | Basic | 26681181 | 2026-11-11 02:15 UTC
10.5k 1% 100ppm 0603 | R3 | R_0603_1608Metric | C22855 | UNI-ROYAL | 0603WAF1052T5E | 1 | Extended | 97693 | 2026-11-11 02:15 UTC
470k 1% 0603 | R31,R32 | R_0603_1608Metric | C23178 | UNI-ROYAL | 0603WAF4703T5E | 2 | Basic | 889239 | 2026-11-11 02:15 UTC
1M 1% 0603 | R35 | R_0603_1608Metric | C22935 | UNI-ROYAL | 0603WAF1004T5E | 1 | Basic | 4026565 | 2026-11-11 02:15 UTC
16.2k 1% 100ppm 0603 | R4 | R_0603_1608Metric | C22885 | UNI-ROYAL | 0603WAF1622T5E | 1 | Extended | 49276 | 2026-11-11 02:15 UTC
USER/BOOT | SW1 | SW_SPST_EVQP7A | C79167 | PANASONIC | EVQP7A01P | 1 | Extended | 3478 | 2026-11-11 02:15 UTC
TPS63900DSKR | U1 | WSON-10-1EP_2.5x2.5mm_P0.5mm_EP1.2x2mm | C1518762 | Texas Instruments | TPS63900DSKR | 1 | Extended | 8237 | 2026-11-11 02:15 UTC
TPS3839K33DBZR | U3 | SOT-23 | C96333 | Texas Instruments | TPS3839K33DBZR | 1 | Extended | 733 | 2026-11-11 02:15 UTC
SHT40-AD1B-R3 | U5 | Sensirion_DFN-4_1.5x1.5mm_P0.8mm_SHT4x_NoCentralPad | C2848306 | Sensirion | SHT40-AD1B-R3 | 1 | Extended | 13484 | 2026-11-11 02:15 UTC
32.768kHz CL 12.5pF, ESR<=70k, 20ppm | Y1 | Crystal_SMD_3215-2Pin_3.2x1.5mm | C32346 | Seiko Epson | Q13FC13500004 | 1 | Basic | 399955 | 2026-11-11 02:15 UTC
