haxeko/matter-temperature-sensor/hardware/analysis/results/cr123a_summary.md

# CR123A in the Rev B power path - model results

**ESTIMATE.** Generated by `hardware/analysis/cr123a_study.py`; nothing was measured. Cell model and its assumptions: see the docstring of that script.

## Fit to the Panasonic CR123A discharge curves (20 degC, plateau)

OCV 3.00 V, R 0.19 Ohm, b2 0.056 V, i_ref 5.0 mA, rms error 0.010 V

| Load | Datasheet graph | Model |
|---|---|---|
| 20 mA | 2.90 V | 2.91 V |
| 100 mA | 2.82 V | 2.81 V |
| 300 mA | 2.72 V | 2.71 V |
| 500 mA | 2.63 V | 2.65 V |
| 1000 mA | 2.52 V | 2.51 V |

## 85 uF effective input buffer (the MLCCs alone, no C5: the H2W-123 board)

Each cell: result, lowest converter input voltage / lowest 3V3 rail voltage.

| Cell state | poll x5 | report + active mode | boot | commissioning nominal | commissioning pessimistic |
|---|---|---|---|---|---|
| fresh, 25 degC | ok 3.03 / 3.30 V | ok 3.03 / 3.30 V | ok 3.03 / 3.30 V | ok 2.96 / 3.30 V | ok 2.94 / 3.30 V |
| mid, 25 degC | ok 2.98 / 3.30 V | ok 2.98 / 3.30 V | ok 2.98 / 3.30 V | ok 2.90 / 3.30 V | ok 2.88 / 3.30 V |
| late, 25 degC | ok 2.81 / 3.30 V | ok 2.81 / 3.30 V | ok 2.80 / 3.30 V | ok 2.67 / 3.30 V | ok 2.62 / 3.30 V |
| eol, 25 degC | ok 2.62 / 3.30 V | ok 2.61 / 3.30 V | ok 2.59 / 3.30 V | ok 2.35 / 3.30 V | ok 2.27 / 3.30 V |
| fresh, -10 degC | ok 2.97 / 3.30 V | ok 2.97 / 3.30 V | ok 2.97 / 3.30 V | ok 2.81 / 3.30 V | ok 2.77 / 3.30 V |
| mid, -10 degC | ok 2.92 / 3.30 V | ok 2.92 / 3.30 V | ok 2.91 / 3.30 V | ok 2.74 / 3.30 V | ok 2.68 / 3.30 V |
| late, -10 degC | ok 2.72 / 3.30 V | ok 2.72 / 3.30 V | ok 2.70 / 3.30 V | ok 2.37 / 3.30 V | ok 2.27 / 3.30 V |

## 555 uF (with the 470 uF of the CR2450 boards, for comparison)

Each cell: result, lowest converter input voltage / lowest 3V3 rail voltage.

| Cell state | poll x5 | report + active mode | boot | commissioning nominal | commissioning pessimistic |
|---|---|---|---|---|---|
| fresh, 25 degC | ok 3.03 / 3.30 V | ok 3.03 / 3.30 V | ok 3.03 / 3.30 V | ok 2.96 / 3.30 V | ok 2.94 / 3.30 V |
| mid, 25 degC | ok 2.98 / 3.30 V | ok 2.98 / 3.30 V | ok 2.98 / 3.30 V | ok 2.90 / 3.30 V | ok 2.88 / 3.30 V |
| late, 25 degC | ok 2.81 / 3.30 V | ok 2.81 / 3.30 V | ok 2.80 / 3.30 V | ok 2.67 / 3.30 V | ok 2.62 / 3.30 V |
| eol, 25 degC | ok 2.62 / 3.30 V | ok 2.61 / 3.30 V | ok 2.59 / 3.30 V | ok 2.35 / 3.30 V | ok 2.27 / 3.30 V |
| fresh, -10 degC | ok 2.97 / 3.30 V | ok 2.97 / 3.30 V | ok 2.97 / 3.30 V | ok 2.81 / 3.30 V | ok 2.77 / 3.30 V |
| mid, -10 degC | ok 2.92 / 3.30 V | ok 2.92 / 3.30 V | ok 2.91 / 3.30 V | ok 2.73 / 3.30 V | ok 2.68 / 3.30 V |
| late, -10 degC | ok 2.73 / 3.30 V | ok 2.72 / 3.30 V | ok 2.70 / 3.30 V | ok 2.37 / 3.30 V | ok 2.27 / 3.30 V |

## Reference: the CR2450 of the other boards (power_model.py, 555 uF)

| Cell state | poll x5 | report + active mode | boot | commissioning nominal | commissioning pessimistic |
|---|---|---|---|---|---|
| fresh 25C | ok 2.85 / 3.30 V | ok 2.60 / 3.30 V | ok 2.36 / 3.30 V | ok 2.15 / 3.30 V | ok 1.86 / 3.30 V |
| mid-life 25C | ok 2.67 / 3.30 V | ok 2.22 / 3.30 V | **RESET** 1.65 / 2.91 V | **RESET** 1.65 / 2.93 V | **RESET** 1.65 / 2.89 V |
| late 25C | ok 2.44 / 3.30 V | **RESET** 1.65 / 2.92 V | **RESET** 1.65 / 2.92 V | **RESET** 1.61 / 2.60 V | **RESET** 1.59 / 2.89 V |
| fresh -10C | ok 2.65 / 3.30 V | ok 1.85 / 3.30 V | **RESET** 1.65 / 2.92 V | **RESET** 1.64 / 2.60 V | **RESET** 1.63 / 2.89 V |

## Lifetime at the nominal load (63.1 uA from the cell, 51.5 uA at the 3V3 rail)

Usable fraction of the nominal capacity: CR2450 50 / 60 / 70 % (reports fail once the cell's resistance has grown, docs/power_budget.md); CR123A 85 / 90 / 95 % (ASSUMED: the cell carries the bursts until its voltage collapses). Self-discharge 1 %/year.

| Cell | Nominal | Usable (low / mid / high) | Life (low / mid / high) |
|---|---|---|---|
| CR2450 with C5 (1 uA leakage) | 620 mAh | 310 / 372 / 434 mAh | 0.55 / 0.66 / 0.76 years |
| CR123A without C5 | 1550 mAh | 1318 / 1395 / 1472 mAh | 2.32 / 2.45 / 2.59 years |
