haxeko/matter-temperature-sensor/hardware/analysis/results/power_model_traces.png

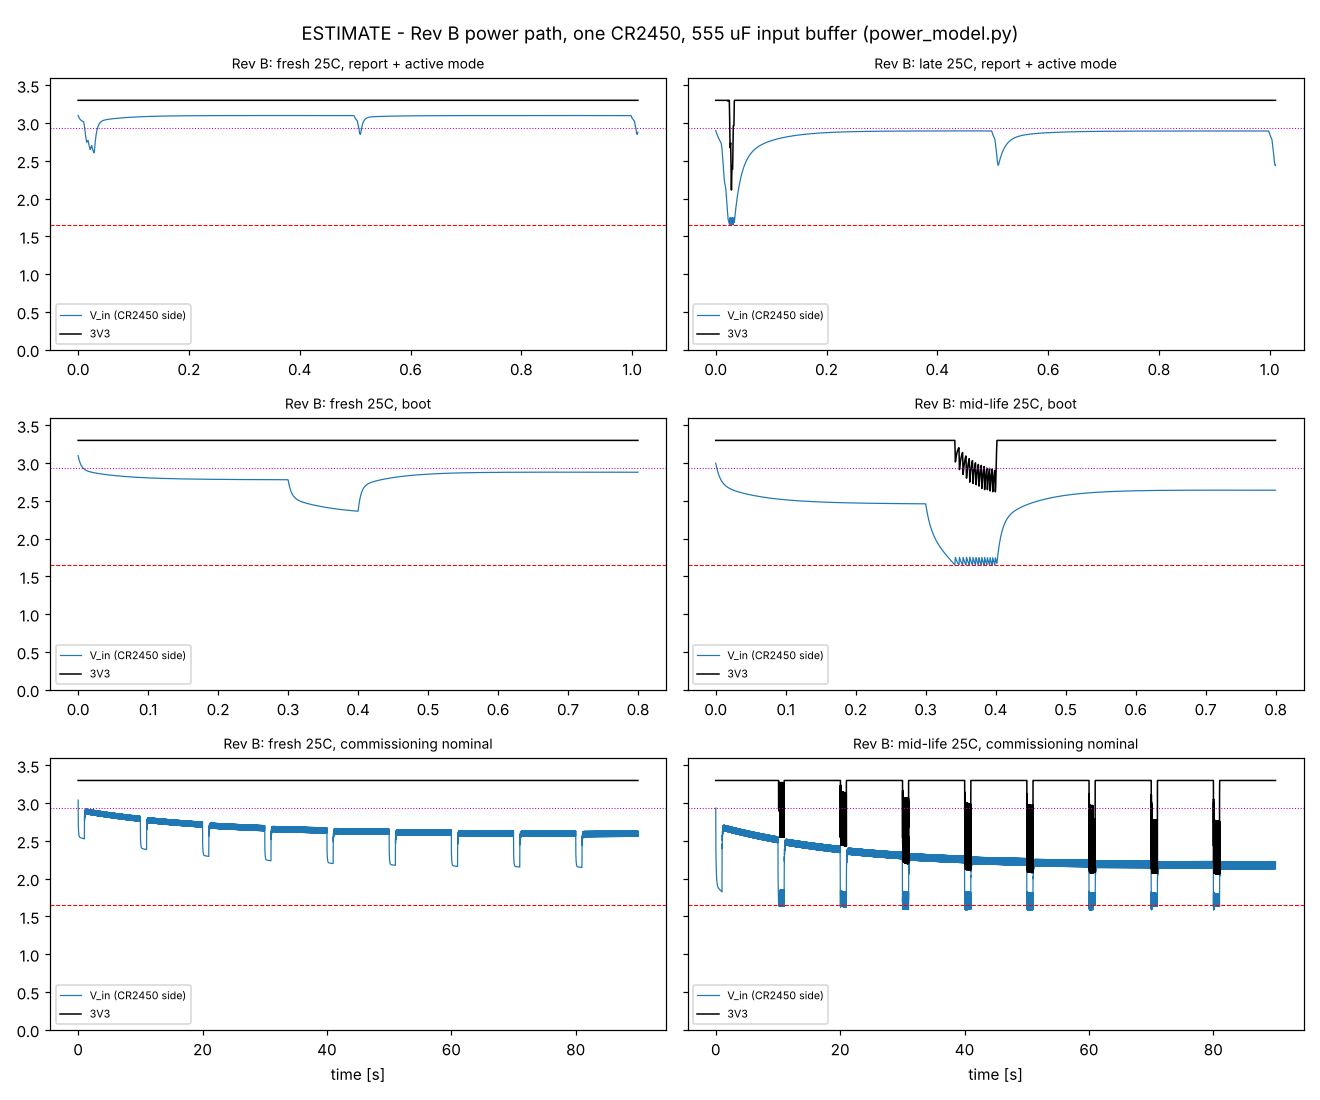
hardware/analysis/results/power_model_traces.png
