haxeko/matter-temperature-sensor/hardware/wroom123/production/assembly_top.pdf

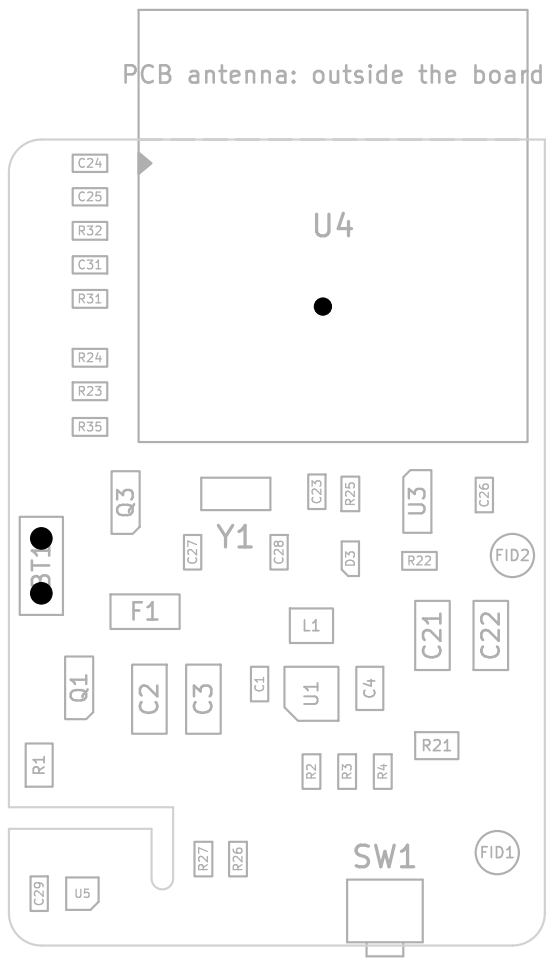
[picture p5: page 1]

Id: 1/1 Title: TH-SENSOR-H2W-123
