haxeko/matter-temperature-sensor/hardware/wroom123/renders/schematic.pdf

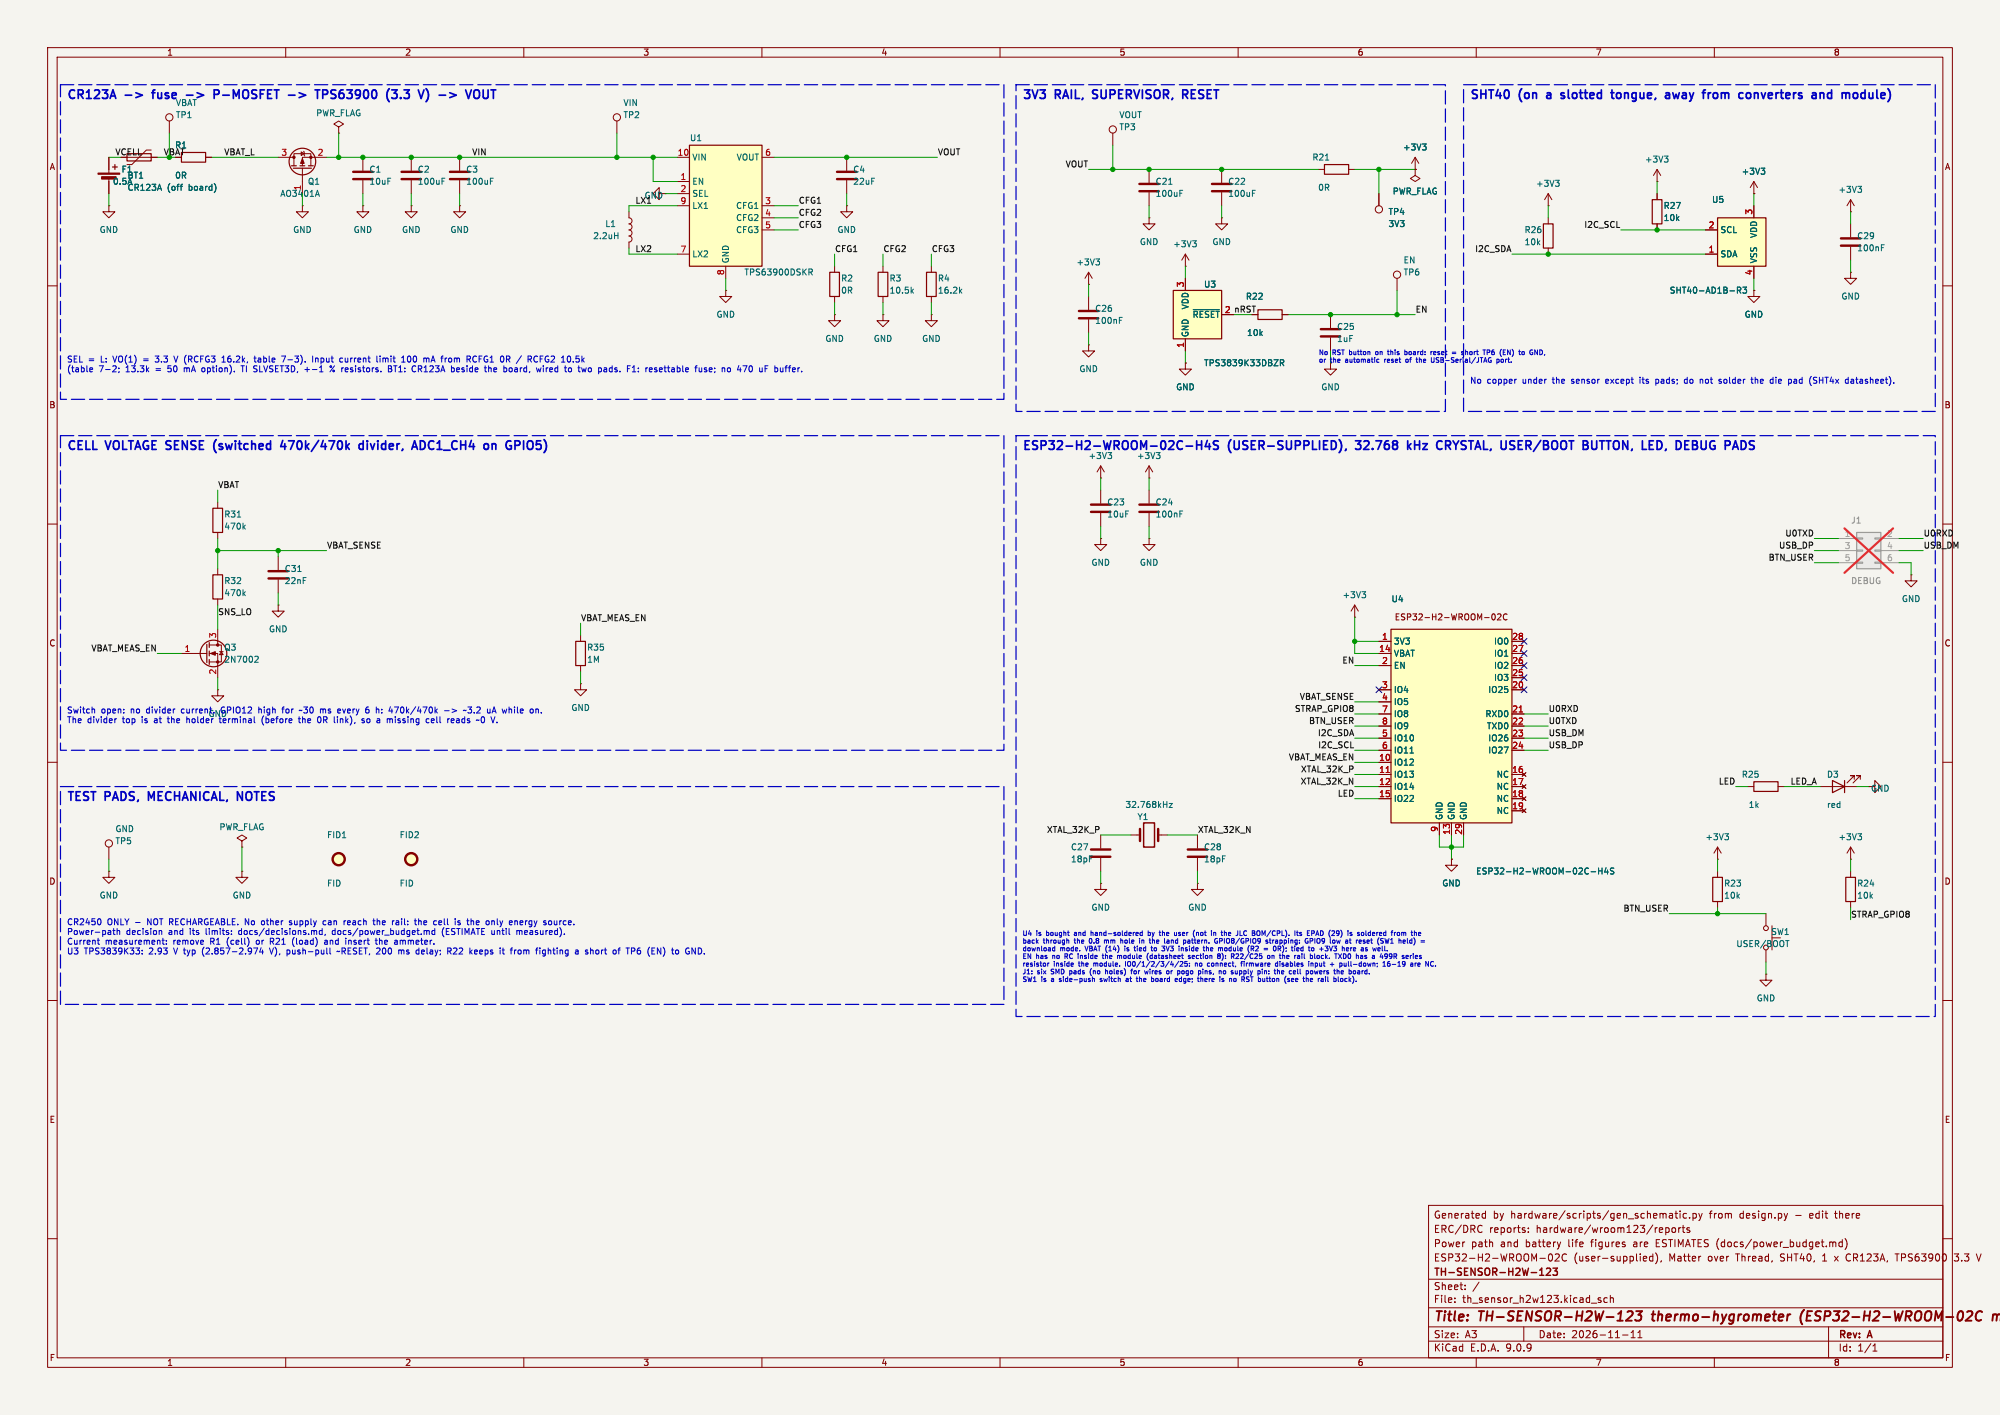
[picture p6: page 1]

IO27 24 NC 16 NC 17 NC 18 NC 19 GND

TEST PADS, MECHANICAL, NOTES
