haxeko/matter-temperature-sensor/hardware/production/assembly_top.pdf

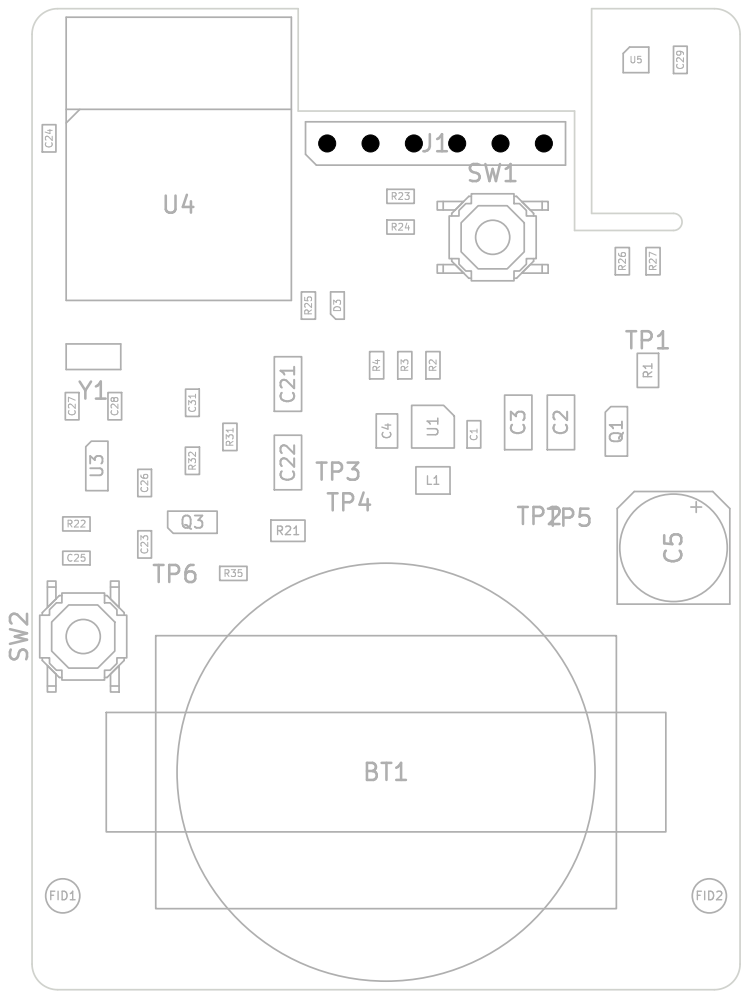
[picture p7: page 1]

Id: 1/1 Title: TH-SENSOR-H2
