haxeko/matter-temperature-sensor/hardware/renders/schematic.pdf

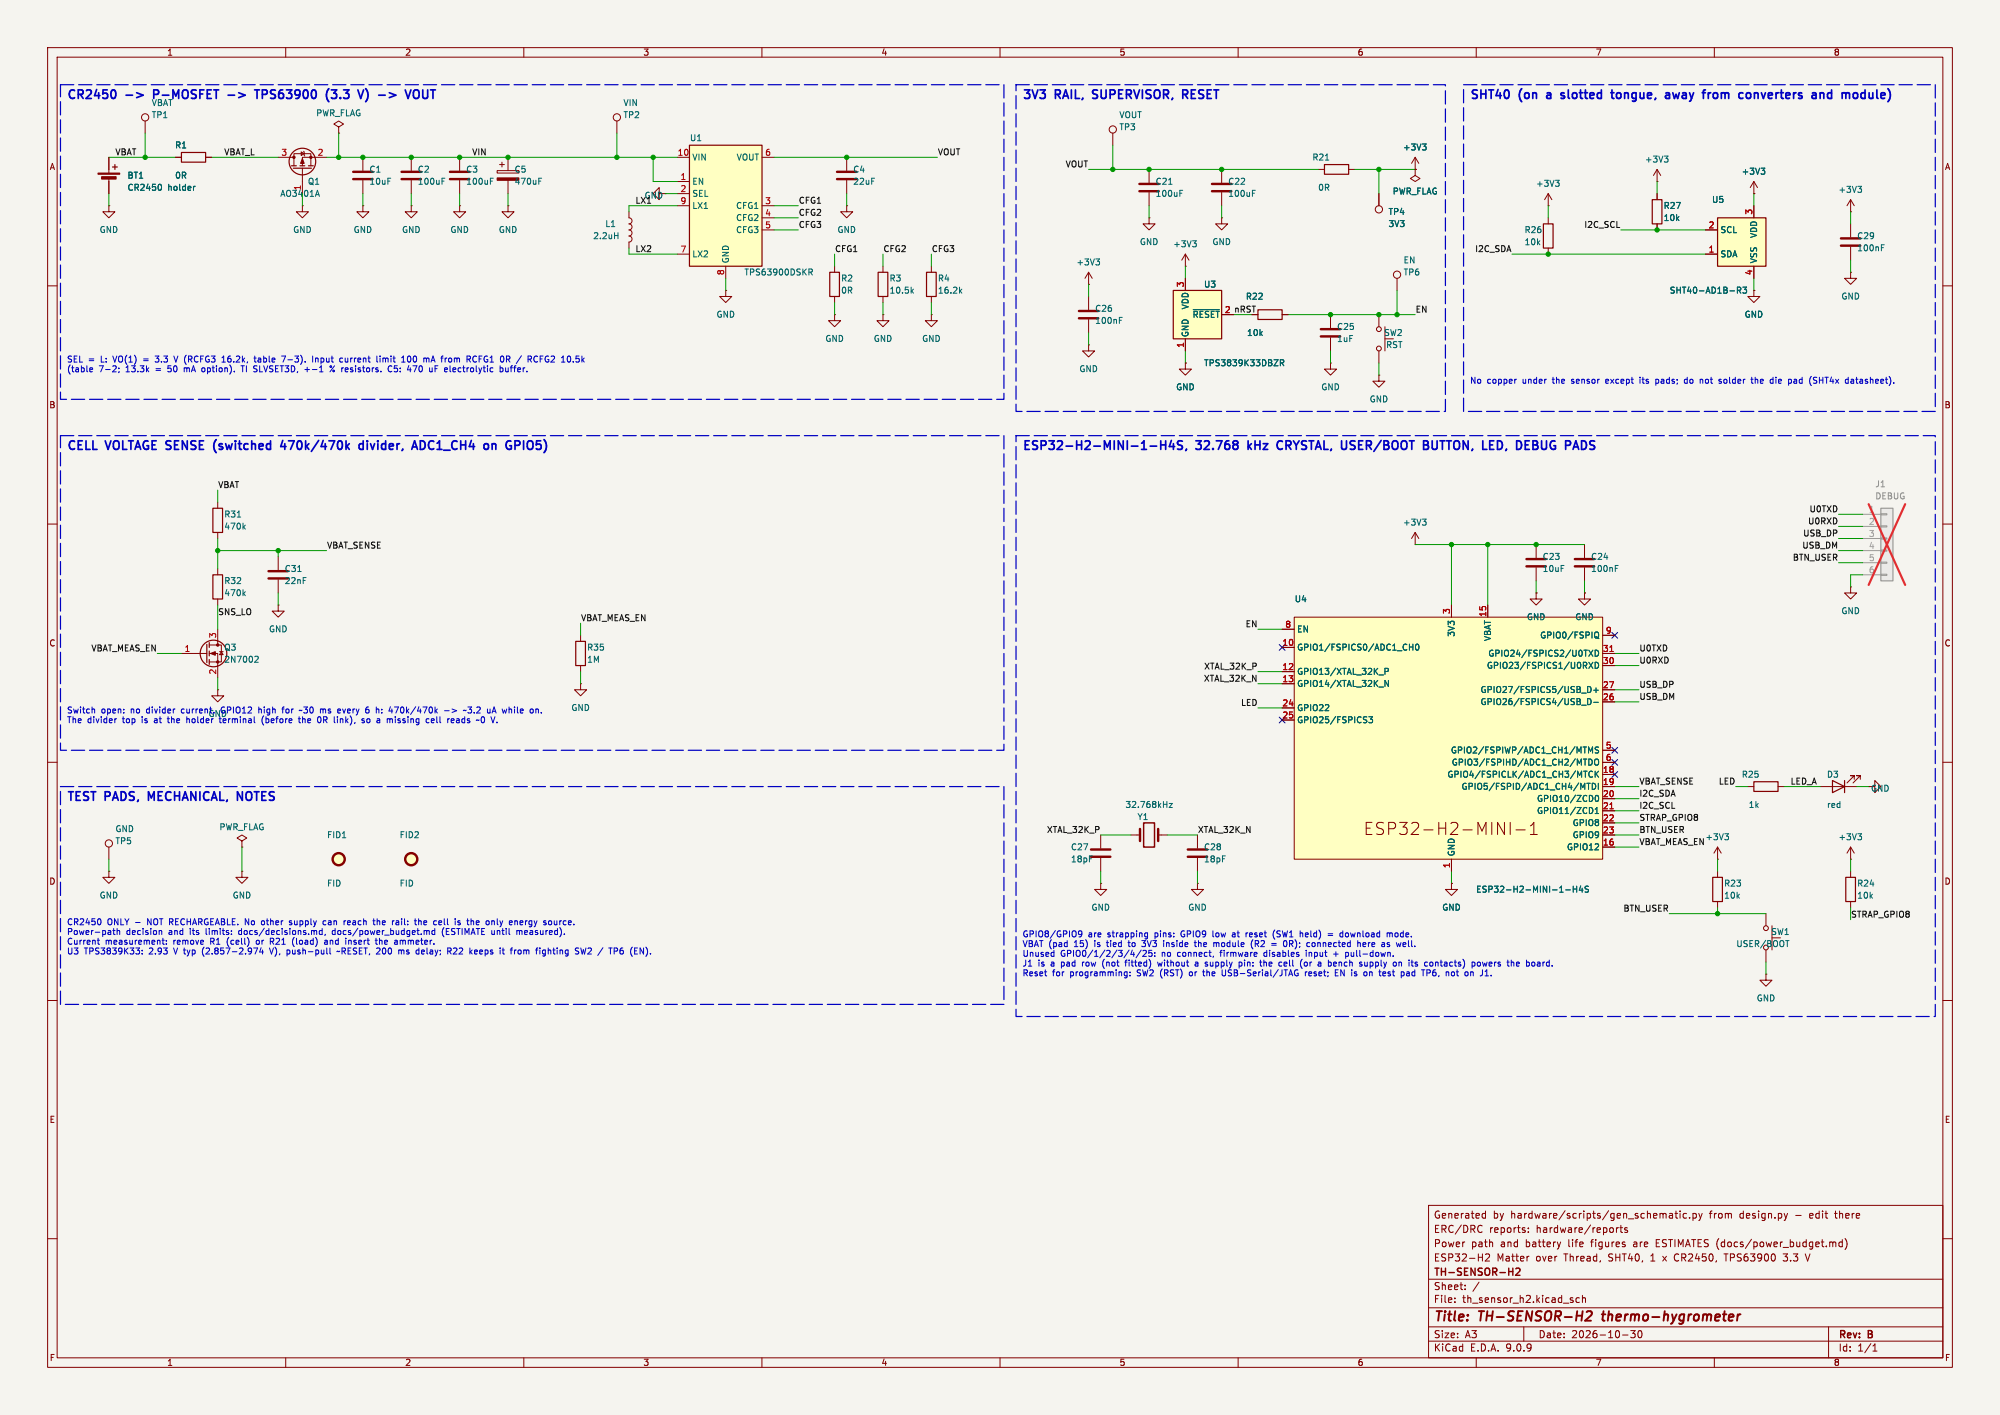
[picture p8: page 1]

8 VOUT 6 CFG1 3 CFG2 4 CFG3 5 U1 TPS63900DSKR GND GND GND GND GND

1 VBAT 15 GPIO24/FSPICS2/U0TXD 31 GPIO23/FSPICS1/U0RXD 30 GPIO27/FSPICS5/USB_D+ 27 GPIO26/FSPICS4/USB_D- 26 GPIO2/FSPIWP/ADC1_CH1/MTMS 5 GPIO3/FSPIHD/ADC1_CH2/MTDO 6 GPIO4/FSPICLK/ADC1_CH3/MTCK 18 GPIO5/FSPID/ADC1_CH4/MTDI 19 GPIO10/ZCD0 20 GPIO11/ZCD1 21 GPIO8 22 GPIO9 23 GPIO12 16 U4 ESP32-H2-MINI-1-H4S

1 VBAT 15 GPIO24/FSPICS2/U0TXD 31 GPIO23/FSPICS1/U0RXD 30 GPIO27/FSPICS5/USB_D+ 27 GPIO26/FSPICS4/USB_D- 26 GPIO2/FSPIWP/ADC1_CH1/MTMS 5 GPIO3/FSPIHD/ADC1_CH2/MTDO 6 GPIO4/FSPICLK/ADC1_CH3/MTCK 18 GPIO5/FSPID/ADC1_CH4/MTDI 19 GPIO10/ZCD0 20 GPIO11/ZCD1 21 GPIO8 22 GPIO9 23 GPIO12 16 GND GND GND

TEST PADS, MECHANICAL, NOTES
