haxeko/matter-temperature-sensor/hardware/wroom/production/assembly_top.pdf

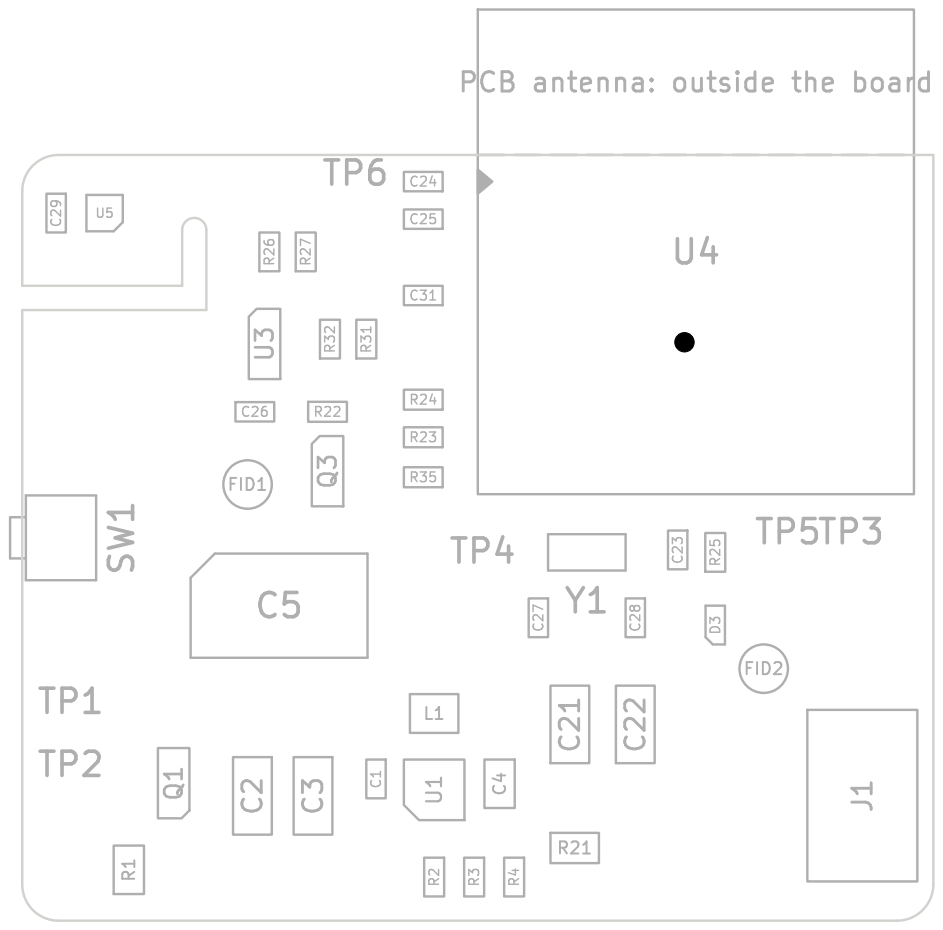
[picture p9: page 1]

Id: 1/1 Title: TH-SENSOR-H2W
