haxeko/matter-temperature-sensor/hardware/wroom/renders/schematic.pdf

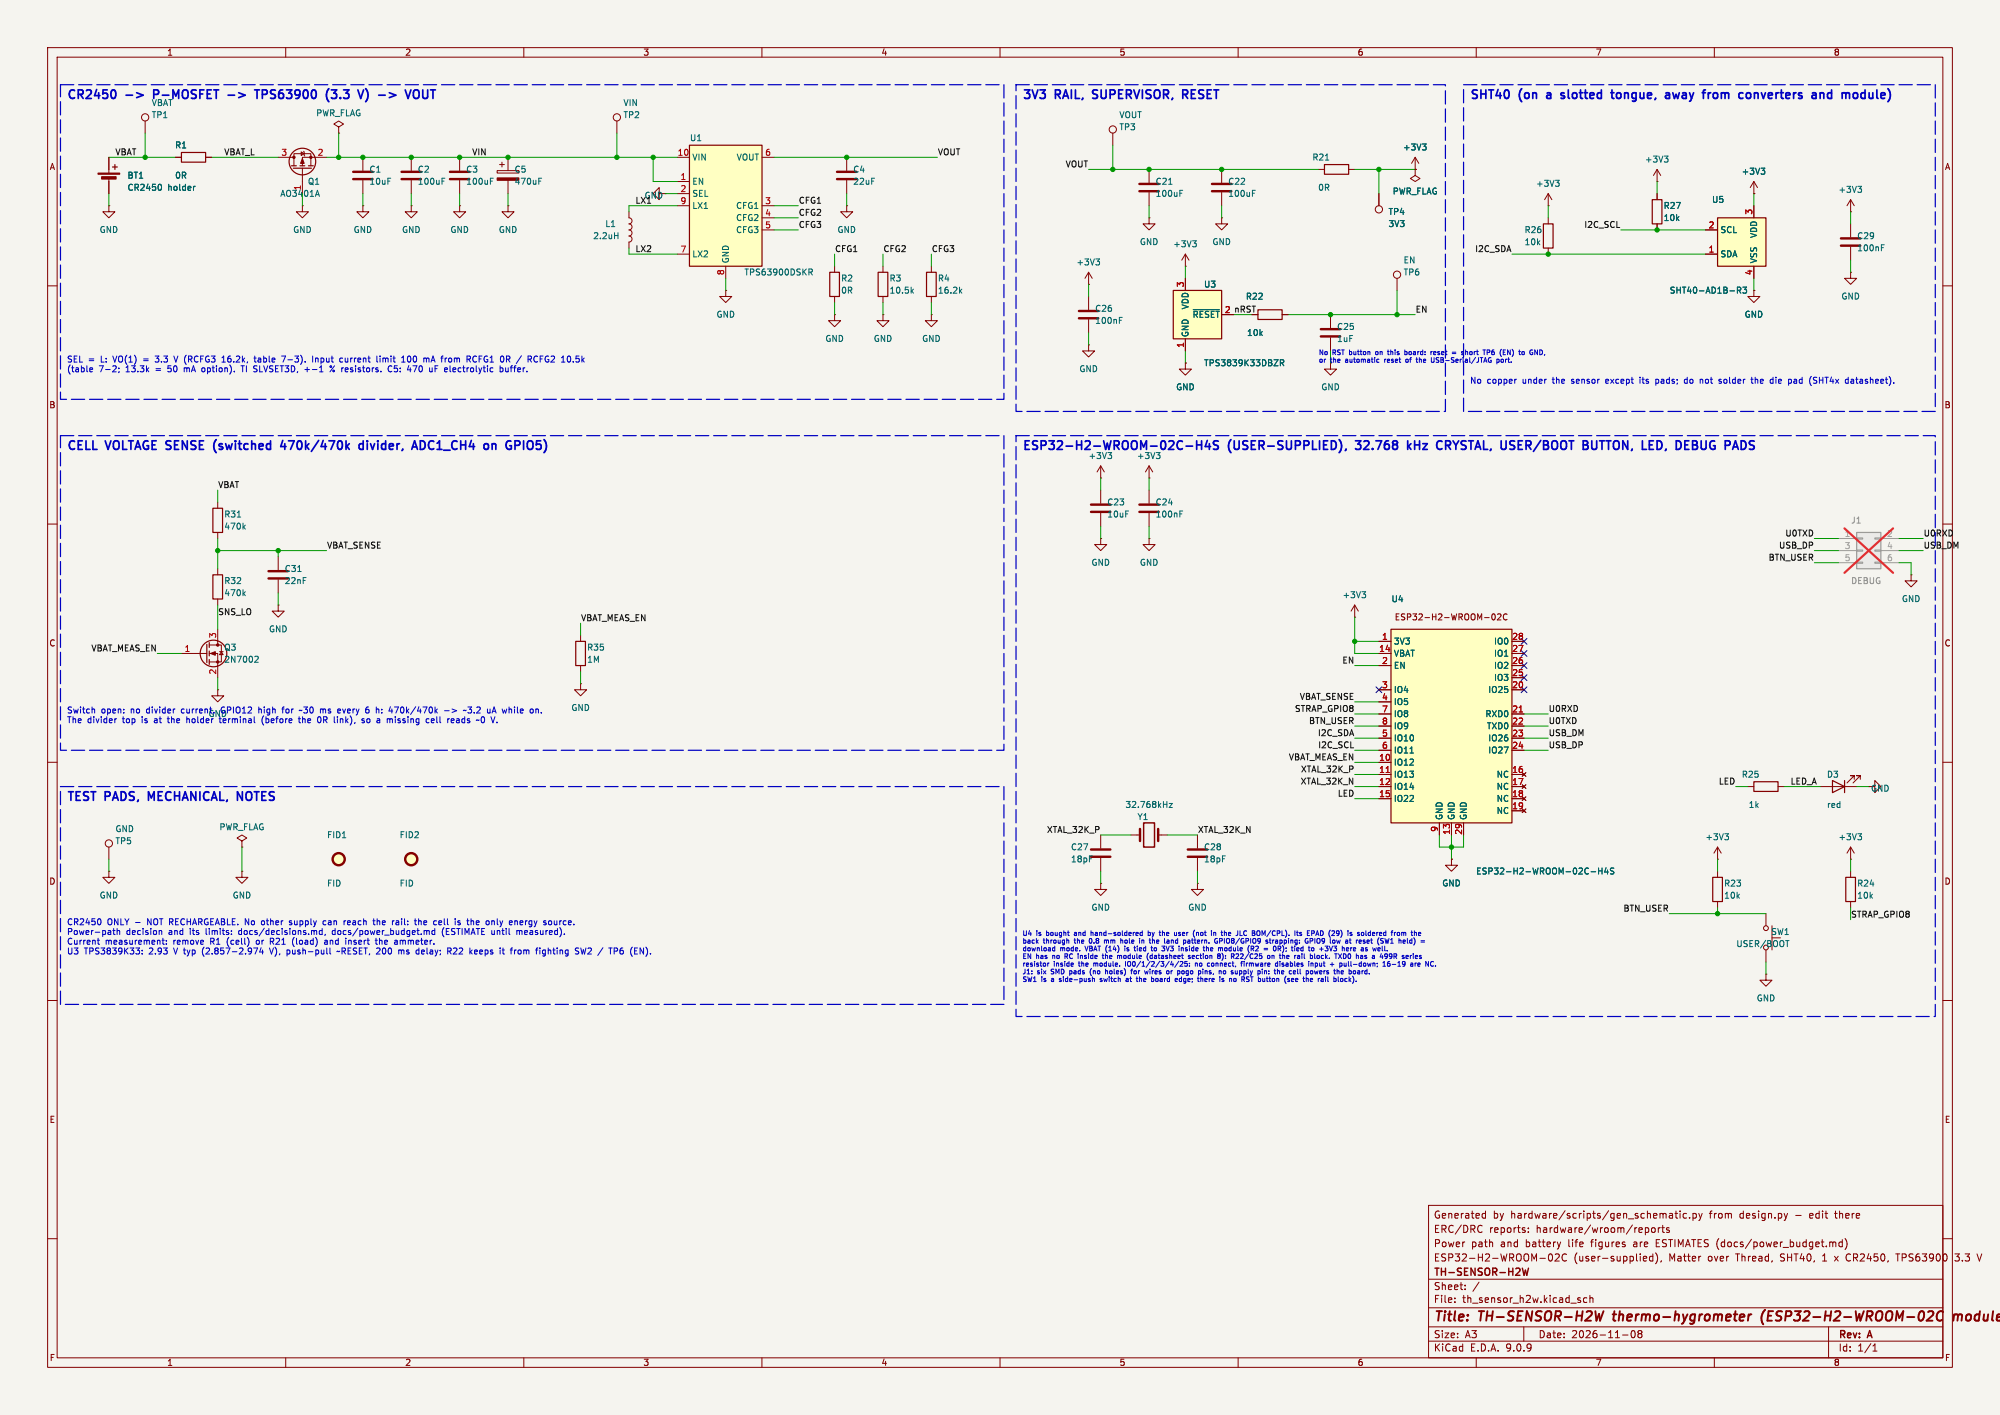
[picture p10: page 1]

SHT40 (on a slotted tongue, away from converters and module)

IO27 24 NC 16 NC 17 NC 18 NC 19 GND

TEST PADS, MECHANICAL, NOTES
TP5 GND GND
