haxeko/matter-temperature-sensor/hardware/chip/production/assembly_top.pdf

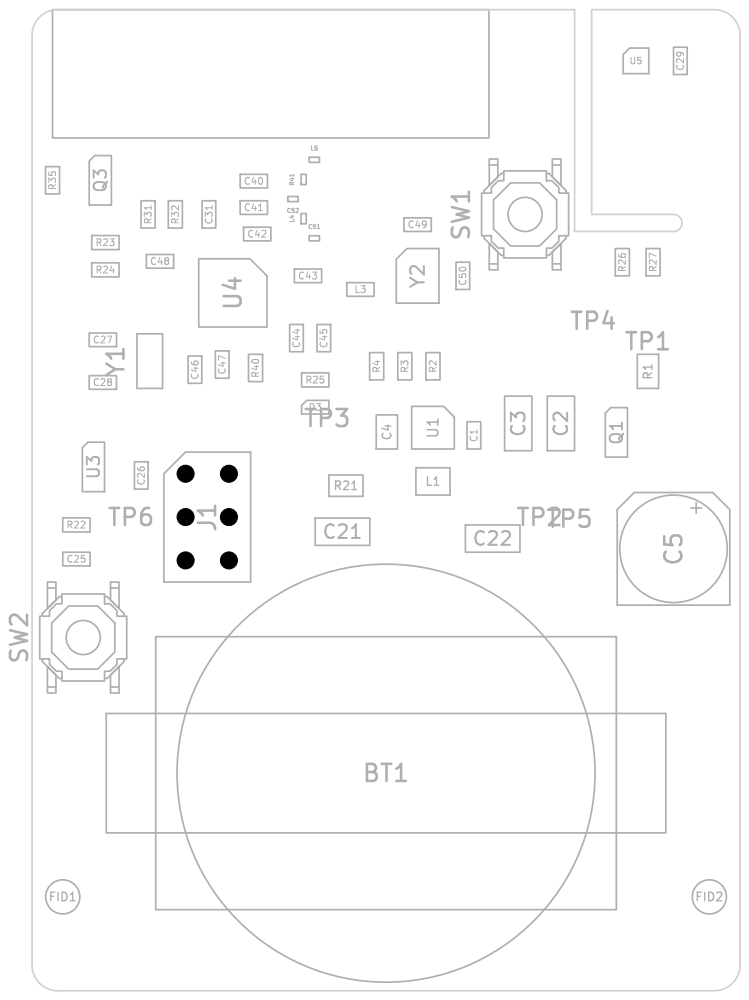
[picture p11: page 1]

Id: 1/1 Title: TH-SENSOR-H2C
