haxeko/matter-temperature-sensor/hardware/chip/renders/schematic.pdf

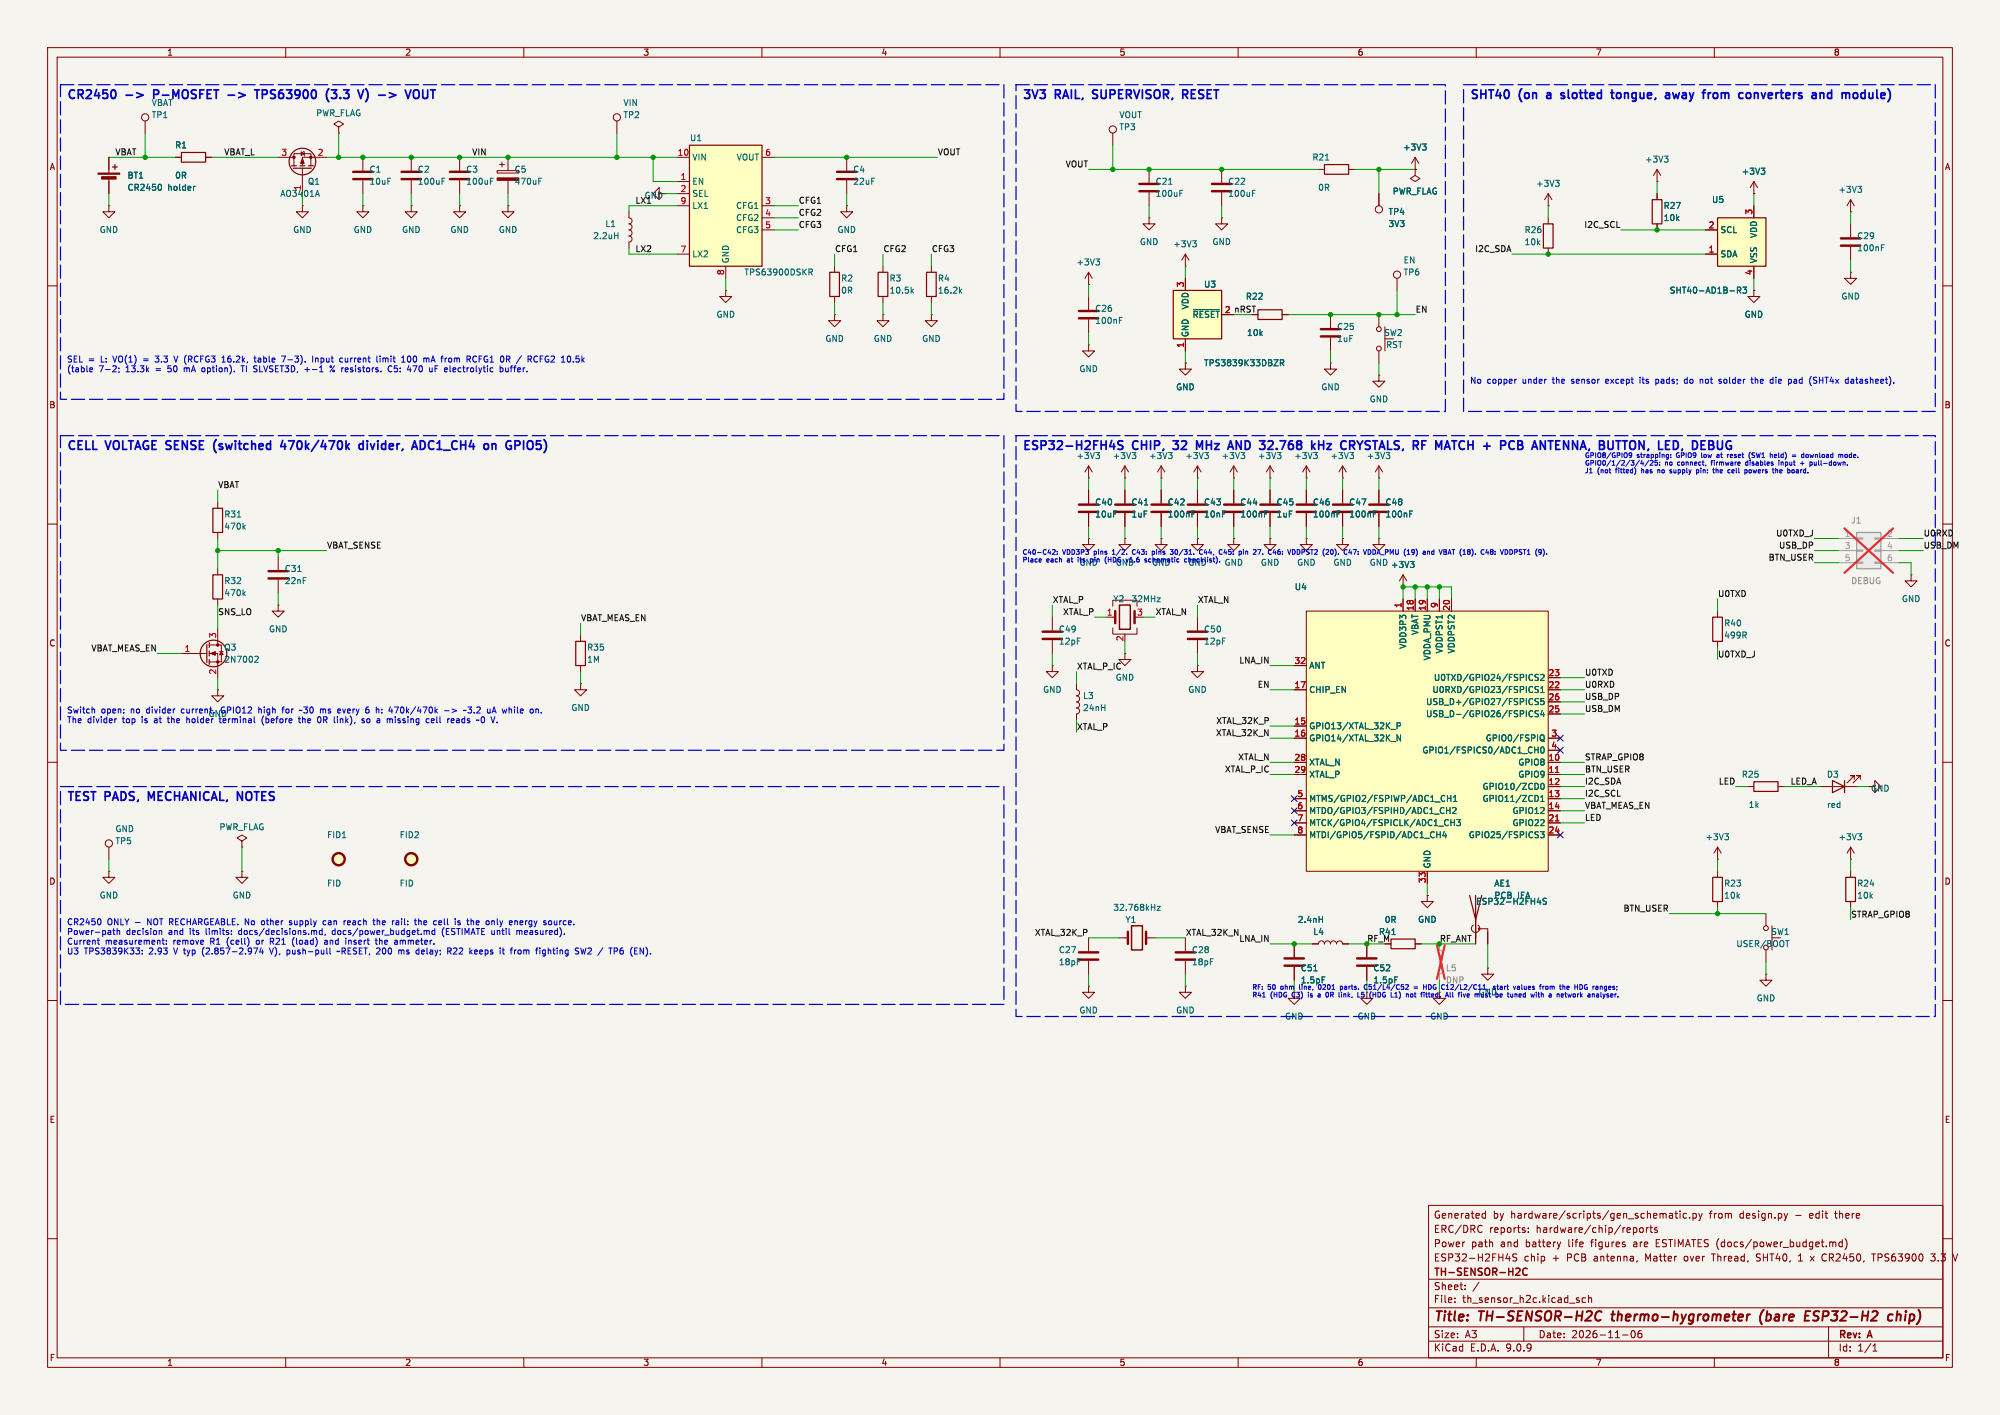
[picture p12: page 1]

8 VOUT 6 CFG1 3 CFG2 4 CFG3 5 U1 TPS63900DSKR GND GND GND
VIN 10 EN 1 SEL 2

No copper under the sensor except its pads; do not solder the die pad (SHT4x datasheet). BT1 CR2450 holder R1

9 VDDPST2 20 U0TXD/GPIO24/FSPICS2 23 U0RXD/GPIO23/FSPICS1 22 USB_D+/GPIO27/FSPICS5 26 USB_D-/GPIO26/FSPICS4 25 GPIO0/FSPIQ 3 GPIO1/FSPICS0/ADC1_CH0 4 GPIO8 10 GPIO9 11 GPIO10/ZCD0 12 GPIO11/ZCD1 13 GPIO12 14 GPIO22 21 GPIO25/FSPICS3 24 AE1 PCB IFA GND

TEST PADS, MECHANICAL, NOTES
TP5 GND GND
