haxeko/matter-temperature-sensor/hardware/wroom123/kicad/th_sensor_h2w123.kicad_pcb

## KiCad design hardware/wroom123/kicad/th_sensor_h2w123.kicad_pcb (2026-11-11)

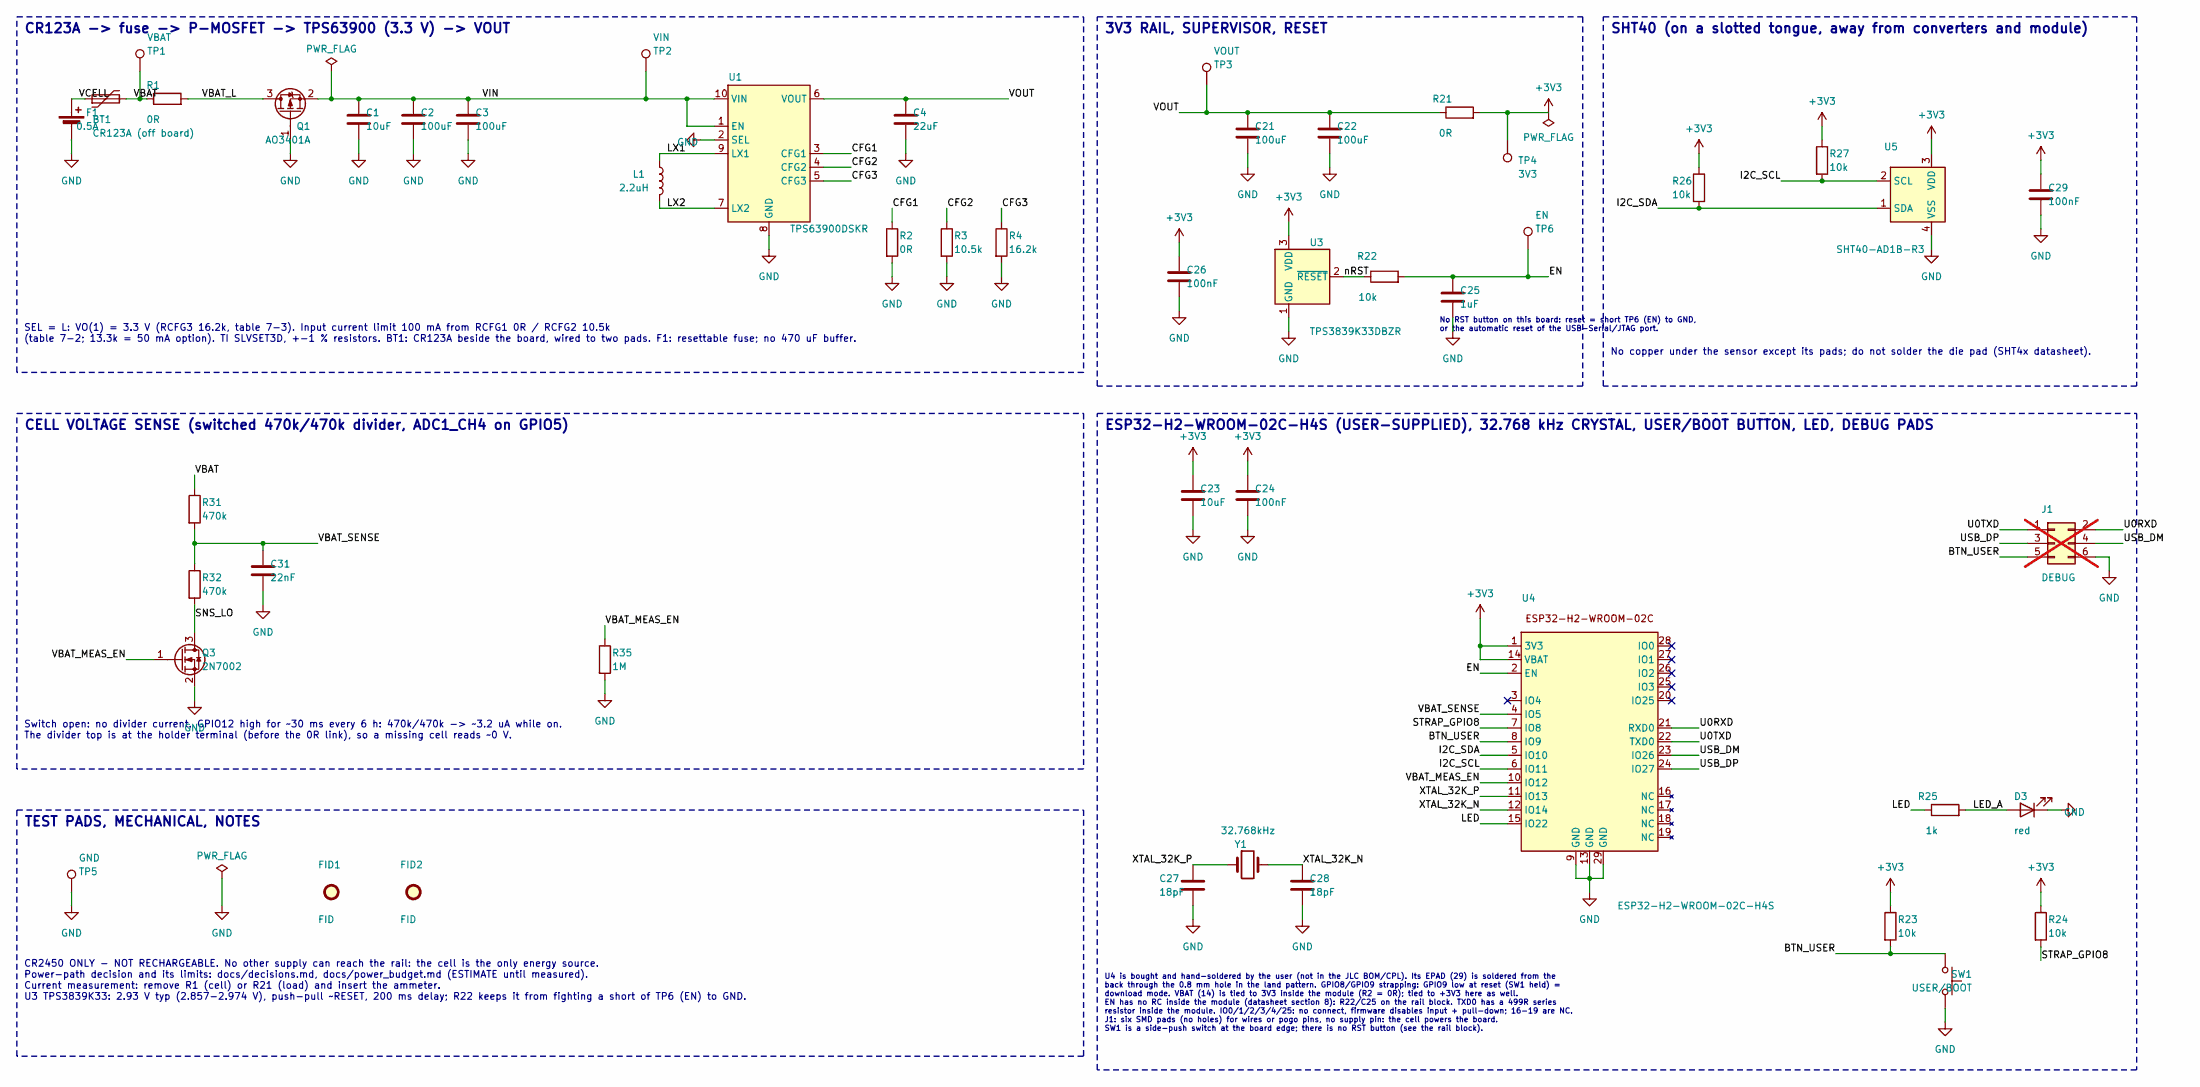
[picture p13: schematic th_sensor_h2w123.kicad_sch, TH-SENSOR-H2W-123 thermo-hygrometer (ESP32-H2-WROOM-02C mod…]

Parts:
BT1: CR123A (off board); BatteryWirePads_1x02_P2.54mm_D1.0mm
C1, C23: 10uF; C_0603_1608Metric; MPN CL10A106KP8NNNC; LCSC C19702
C2, C3, C21, C22: 100uF; C_1206_3216Metric; MPN CL31A107MQHNNNE; LCSC C15008
C4: 22uF; C_0805_2012Metric; MPN CL21A226MAQNNNE; LCSC C45783
C24, C26, C29: 100nF; C_0603_1608Metric; MPN CC0603KRX7R9BB104; LCSC C14663
C25: 1uF; C_0603_1608Metric; MPN CL10A105KB8NNNC; LCSC C15849
C27, C28: 18pF; C_0603_1608Metric; MPN CL10C180JB8NNNC; LCSC C1647
C31: 22nF; C_0603_1608Metric; MPN CL10B223KB8NNNC; LCSC C21122
D3: red; LED_0603_1608Metric; MPN KT-0603R; LCSC C2286
F1: 0.5A; Fuse_1206_3216Metric; MPN BSMD1206-050-6V; LCSC C883122
FID1, FID2: FID; Fiducial_1mm_Mask2mm
J1: DEBUG; TestPads_2x03_P2.54mm_SMD; not fitted
L1: 2.2uH; L_Murata_DFE201612E; MPN DFE201612E-2R2M=P2; LCSC C337893
Q1: AO3401A; SOT-23; MPN AO3401A; LCSC C15127
Q3: 2N7002; SOT-23; MPN 2N7002; LCSC C8545
R1, R21: 0R; R_0805_2012Metric; MPN 0805W8F0000T5E; LCSC C17477
R2: 0R; R_0603_1608Metric; MPN 0603WAF0000T5E; LCSC C21189
R3: 10.5k; R_0603_1608Metric; MPN 0603WAF1052T5E; LCSC C22855
R4: 16.2k; R_0603_1608Metric; MPN 0603WAF1622T5E; LCSC C22885
R22, R23, R24, R26, R27: 10k; R_0603_1608Metric; MPN 0603WAF1002T5E; LCSC C25804
R25: 1k; R_0603_1608Metric; MPN 0603WAF1001T5E; LCSC C21190
R31, R32: 470k; R_0603_1608Metric; MPN 0603WAF4703T5E; LCSC C23178
R35: 1M; R_0603_1608Metric; MPN 0603WAF1004T5E; LCSC C22935
SW1: USER/BOOT; SW_SPST_EVQP7A; MPN EVQP7A01P; LCSC C79167
TP1: VBAT; TestPoint_Pad_D1.5mm
TP2: VIN; TestPoint_Pad_D1.5mm
TP3: VOUT; TestPoint_Pad_D1.5mm
TP4: 3V3; TestPoint_Pad_D1.5mm
TP5: GND; TestPoint_Pad_D1.5mm
TP6: EN; TestPoint_Pad_D1.5mm
U1: TPS63900DSKR; WSON-10-1EP_2.5x2.5mm_P0.5mm_EP1.2x2mm; MPN TPS63900DSKR; LCSC C1518762
U3: TPS3839K33DBZR; SOT-23; MPN TPS3839K33DBZR; LCSC C96333
U4: ESP32-H2-WROOM-02C-H4S; ESP32-H2-WROOM-02C
U5: SHT40-AD1B-R3; Sensirion_DFN-4_1.5x1.5mm_P0.8mm_SHT4x_NoCentralPad; MPN SHT40-AD1B-R3; LCSC C2848306
Y1: 32.768kHz; Crystal_SMD_3215-2Pin_3.2x1.5mm; MPN Q13FC13500004; LCSC C32346

Connections:
+3V3: C23.1, C24.1, C26.1, C29.1, R21.2, R23.1, R24.1, R26.1, R27.1, TP4.1, U3.3 (VDD), U4.1 (3V3), U4.14 (VBAT), U5.3 (VDD)
/BTN_USER: J1.5, R23.2, SW1.1, U4.8 (IO9)
/CFG1: R2.1, U1.3 (CFG1)
/CFG2: R3.1, U1.4 (CFG2)
/CFG3: R4.1, U1.5 (CFG3)
/EN: C25.1, R22.2, TP6.1, U4.2 (EN)
/I2C_SCL: R27.2, U4.6 (IO11), U5.2 (SCL)
/I2C_SDA: R26.2, U4.5 (IO10), U5.1 (SDA)
/LED: R25.1, U4.15 (IO22)
/LED_A: D3.2 (A), R25.2
/LX1: L1.1, U1.9 (LX1)
/LX2: L1.2, U1.7 (LX2)
/SNS_LO: Q3.3 (D), R32.2
/STRAP_GPIO8: R24.2, U4.7 (IO8)
/U0RXD: J1.2, U4.21 (RXD0)
/U0TXD: J1.1, U4.22 (TXD0)
/USB_DM: J1.4, U4.23 (IO26)
/USB_DP: J1.3, U4.24 (IO27)
/VBAT: F1.2, R1.1, R31.1, TP1.1
/VBAT_L: Q1.3 (D), R1.2
/VBAT_MEAS_EN: Q3.1 (G), R35.1, U4.10 (IO12)
/VBAT_SENSE: C31.1, R31.2, R32.1, U4.4 (IO5)
/VCELL: BT1.1 (+), F1.1
/VIN: C1.1, C2.1, C3.1, Q1.2 (S), TP2.1, U1.1 (EN), U1.10 (VIN)
/VOUT: C4.1, C21.1, C22.1, R21.1, TP3.1, U1.6 (VOUT)
/XTAL_32K_N: C28.1, U4.12 (IO14), Y1.2
/XTAL_32K_P: C27.1, U4.11 (IO13), Y1.1
/nRST: R22.1, U3.2 (~RESET)
GND: BT1.2 (-), C1.2, C2.2, C3.2, C4.2, C21.2, C22.2, C23.2, C24.2, C25.2, C26.2, C27.2, C28.2, C29.2, C31.2, D3.1 (K), J1.6, Q1.1 (G), Q3.2 (S), R2.2, R3.2, R4.2, R35.2, SW1.2, TP5.1, U1.2 (SEL), U1.8 (GND), U1.11 (GND), U3.1 (GND), U4.9 (GND), U4.13 (GND), U4.29 (GND), U5.4 (VSS)

Notes on the sheet:
CR123A -> fuse -> P-MOSFET -> TPS63900 (3.3 V) -> VOUT
SEL = L: VO(1) = 3.3 V (RCFG3 16.2k, table 7-3). Input current limit 100 mA from RCFG1 0R / RCFG2 10.5k (table 7-2; 13.3k = 50 mA option). TI SLVSET3D, +-1 % resistors. BT1: CR123A beside the board, wired to two pads. F1: resettable fuse; no 470 uF buffer.
3V3 RAIL, SUPERVISOR, RESET
No RST button on this board: reset = short TP6 (EN) to GND, or the automatic reset of the USB-Serial/JTAG port.
ESP32-H2-WROOM-02C-H4S (USER-SUPPLIED), 32.768 kHz CRYSTAL, USER/BOOT BUTTON, LED, DEBUG PADS
U4 is bought and hand-soldered by the user (not in the JLC BOM/CPL). Its EPAD (29) is soldered from the back through the 0.8 mm hole in the land pattern. GPIO8/GPIO9 strapping: GPIO9 low at reset (SW1 held) = download mode. VBAT (14) is tied to 3V3 inside the module (R2 = 0R); tied to +3V3 here as 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
SHT40 (on a slotted tongue, away from converters and module)
No copper under the sensor except its pads; do not solder the die pad (SHT4x datasheet).
CELL VOLTAGE SENSE (switched 470k/470k divider, ADC1_CH4 on GPIO5)
Switch open: no divider current. GPIO12 high for ~30 ms every 6 h: 470k/470k -> ~3.2 uA while on. The divider top is at the holder terminal (before the 0R link), so a missing cell reads ~0 V.
TEST PADS, MECHANICAL, NOTES
CR2450 ONLY - NOT RECHARGEABLE. No other supply can reach the rail: the cell is the only energy source. Power-path decision and its limits: docs/decisions.md, docs/power_budget.md (ESTIMATE until measured). Current measurement: remove R1 (cell) or R21 (load) and insert the ammeter. U3 TPS3839K33: 2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

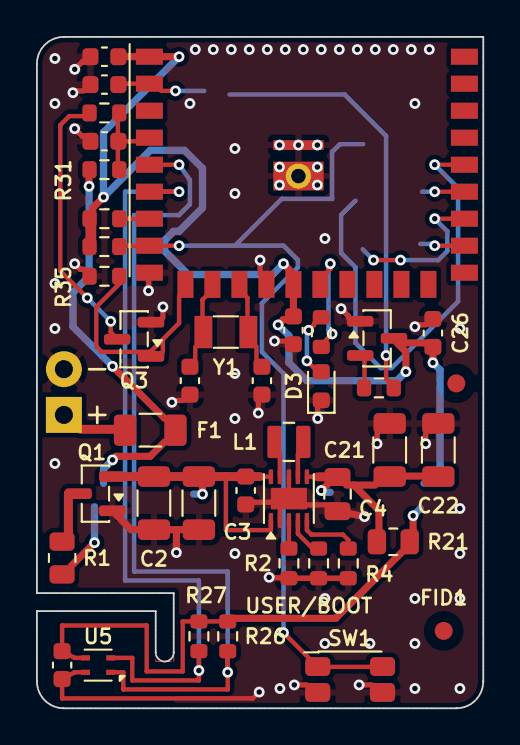
[picture p14: board th_sensor_h2w123.kicad_pcb from above]

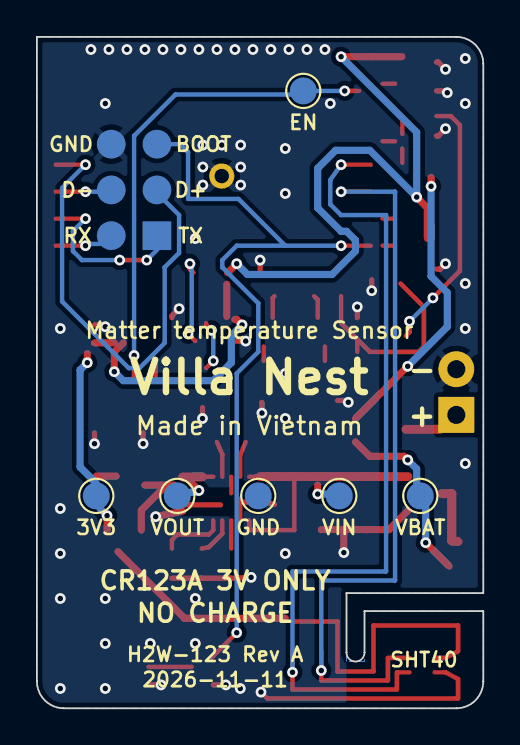
[picture p15: board th_sensor_h2w123.kicad_pcb from below]

Board: 2 copper layers, 24.8 x 37.3 mm, 49 parts (7 on the bottom side), 29 nets.
