haxeko/matter-temperature-sensor/hardware/chip/kicad/th_sensor_h2c.kicad_pcb

## KiCad design hardware/chip/kicad/th_sensor_h2c.kicad_pcb (2026-11-06)

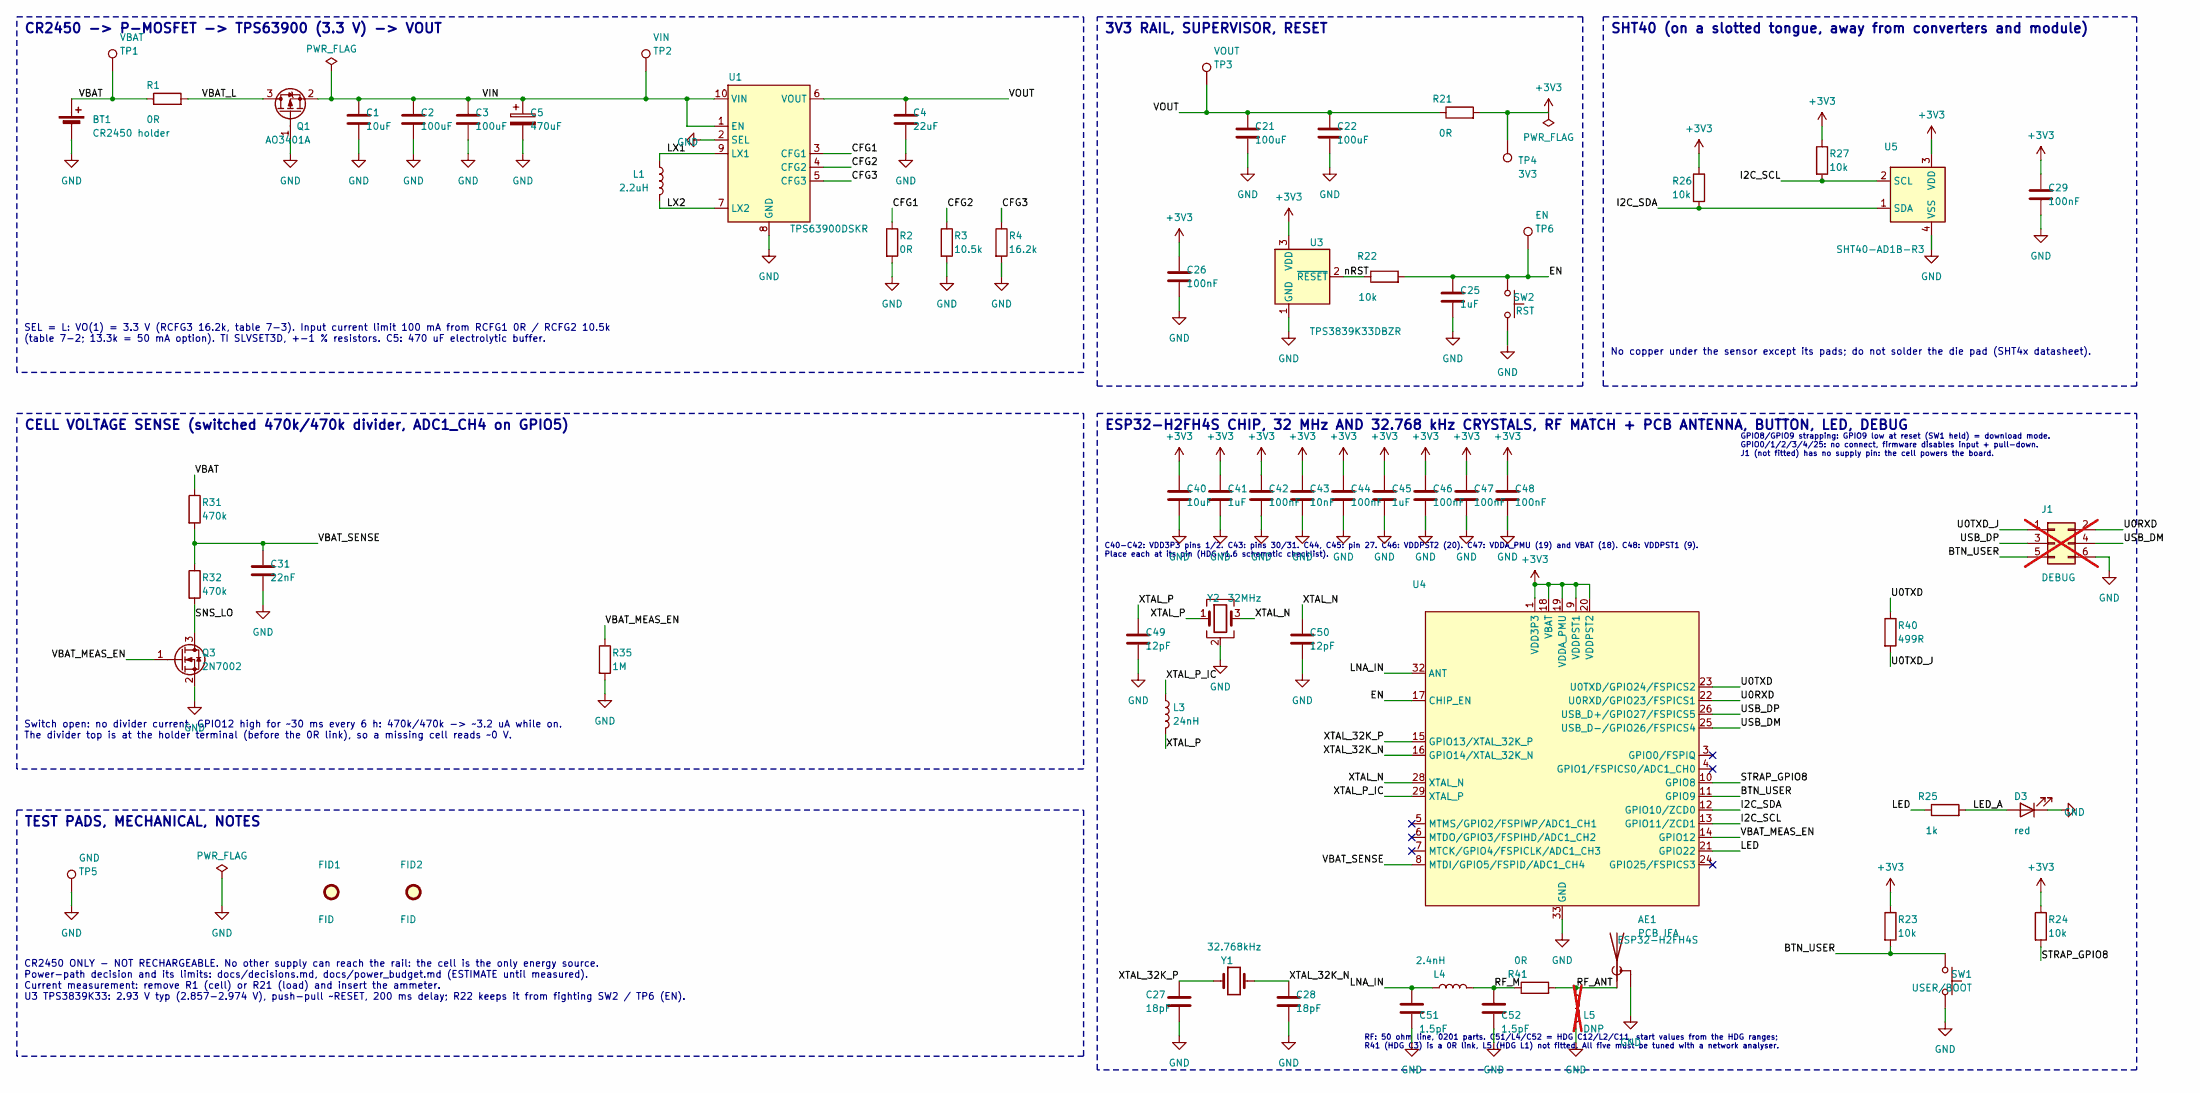
[picture p16: schematic th_sensor_h2c.kicad_sch, TH-SENSOR-H2C thermo-hygrometer (bare ESP32-H2 chip)]

Parts:
AE1: PCB IFA; Antenna_TI_DN007_IFA_2.4GHz_Mirrored
BT1: CR2450 holder; BatteryHolder_MYOUNG_BS-24-B4AA016_1x2450; MPN BS-24-B4AA016; LCSC C964809
C1, C40: 10uF; C_0603_1608Metric; MPN CL10A106KP8NNNC; LCSC C19702
C2, C3, C21, C22: 100uF; C_1206_3216Metric; MPN CL31A107MQHNNNE; LCSC C15008
C4: 22uF; C_0805_2012Metric; MPN CL21A226MAQNNNE; LCSC C45783
C5: 470uF; CP_Elec_6.3x7.7; MPN RVT470UF6.3V67RV0038; LCSC C2901342
C25, C41, C45: 1uF; C_0603_1608Metric; MPN CL10A105KB8NNNC; LCSC C15849
C26, C29, C42, C44, C46, C47, C48: 100nF; C_0603_1608Metric; MPN CC0603KRX7R9BB104; LCSC C14663
C27, C28: 18pF; C_0603_1608Metric; MPN CL10C180JB8NNNC; LCSC C1647
C31: 22nF; C_0603_1608Metric; MPN CL10B223KB8NNNC; LCSC C21122
C43: 10nF; C_0603_1608Metric; MPN 0603B103K500NT; LCSC C57112
C49, C50: 12pF; C_0603_1608Metric; MPN CL10C120JB8NNNC; LCSC C38523
C51, C52: 1.5pF; C_0201_0603Metric; MPN GRM0335C1H1R5BA01D; LCSC C161414
D3: red; LED_0603_1608Metric; MPN KT-0603R; LCSC C2286
FID1, FID2: FID; Fiducial_1mm_Mask2mm
J1: DEBUG; PinHeader_2x03_P2.54mm_Vertical; not fitted
L1: 2.2uH; L_Murata_DFE201612E; MPN DFE201612E-2R2M=P2; LCSC C337893
L3: 24nH; L_0603_1608Metric; MPN LQW18AN24NG00D; LCSC C162644
L4: 2.4nH; L_0201_0603Metric; MPN LQP03TN2N4B02D; LCSC C98042
L5: DNP; L_0201_0603Metric; not fitted
Q1: AO3401A; SOT-23; MPN AO3401A; LCSC C15127
Q3: 2N7002; SOT-23; MPN 2N7002; LCSC C8545
R1, R21: 0R; R_0805_2012Metric; MPN 0805W8F0000T5E; LCSC C17477
R2: 0R; R_0603_1608Metric; MPN 0603WAF0000T5E; LCSC C21189
R3: 10.5k; R_0603_1608Metric; MPN 0603WAF1052T5E; LCSC C22855
R4: 16.2k; R_0603_1608Metric; MPN 0603WAF1622T5E; LCSC C22885
R22, R23, R24, R26, R27: 10k; R_0603_1608Metric; MPN 0603WAF1002T5E; LCSC C25804
R25: 1k; R_0603_1608Metric; MPN 0603WAF1001T5E; LCSC C21190
R31, R32: 470k; R_0603_1608Metric; MPN 0603WAF4703T5E; LCSC C23178
R35: 1M; R_0603_1608Metric; MPN 0603WAF1004T5E; LCSC C22935
R40: 499R; R_0603_1608Metric; MPN 0603WAF4990T5E; LCSC C23065
R41: 0R; R_0201_0603Metric; MPN 0201WMF0000TEE; LCSC C473473
SW1: USER/BOOT; SW_Push_1P1T_XKB_TS-1187A; MPN TS-1187A-B-A-B; LCSC C318884
SW2: RST; SW_Push_1P1T_XKB_TS-1187A; MPN TS-1187A-B-A-B; LCSC C318884
TP1: VBAT; TestPoint_Pad_D1.5mm
TP2: VIN; TestPoint_Pad_D1.5mm
TP3: VOUT; TestPoint_Pad_D1.5mm
TP4: 3V3; TestPoint_Pad_D1.5mm
TP5: GND; TestPoint_Pad_D1.5mm
TP6: EN; TestPoint_Pad_D1.5mm
U1: TPS63900DSKR; WSON-10-1EP_2.5x2.5mm_P0.5mm_EP1.2x2mm; MPN TPS63900DSKR; LCSC C1518762
U3: TPS3839K33DBZR; SOT-23; MPN TPS3839K33DBZR; LCSC C96333
U4: ESP32-H2FH4S; QFN-32-1EP_4x4mm_P0.4mm_EP2.9x2.9mm; MPN ESP32-H2FH4S; LCSC C50392664
U5: SHT40-AD1B-R3; Sensirion_DFN-4_1.5x1.5mm_P0.8mm_SHT4x_NoCentralPad; MPN SHT40-AD1B-R3; LCSC C2848306
Y1: 32.768kHz; Crystal_SMD_3215-2Pin_3.2x1.5mm; MPN Q13FC13500004; LCSC C32346
Y2: 32MHz; Crystal_SMD_3225-4Pin_3.2x2.5mm; MPN X322532MLB4SI; LCSC C5210649

Connections:
+3V3: C26.1, C29.1, C40.1, C41.1, C42.1, C43.1, C44.1, C45.1, C46.1, C47.1, C48.1, R21.2, R23.1, R24.1, R26.1, R27.1, TP4.1, U3.3 (VDD), U4.1 (VDD3P3), U4.2 (VDD3P3), U4.9 (VDDPST1), U4.18 (VBAT), U4.19 (VDDA_PMU), U4.20 (VDDPST2), U4.27 (VDD3P3), U4.30 (VDD3P3), U4.31 (VDD3P3), U5.3 (VDD)
/BTN_USER: J1.5, R23.2, SW1.1, U4.11 (GPIO9)
/CFG1: R2.1, U1.3 (CFG1)
/CFG2: R3.1, U1.4 (CFG2)
/CFG3: R4.1, U1.5 (CFG3)
/EN: C25.1, R22.2, SW2.1, TP6.1, U4.17 (CHIP_EN)
/I2C_SCL: R27.2, U4.13 (GPIO11/ZCD1), U5.2 (SCL)
/I2C_SDA: R26.2, U4.12 (GPIO10/ZCD0), U5.1 (SDA)
/LED: R25.1, U4.21 (GPIO22)
/LED_A: D3.2 (A), R25.2
/LNA_IN: C51.1, L4.1, U4.32 (ANT)
/LX1: L1.1, U1.9 (LX1)
/LX2: L1.2, U1.7 (LX2)
/RF_ANT: AE1.1 (A), L5.1, R41.2
/RF_M: C52.1, L4.2, R41.1
/SNS_LO: Q3.3 (D), R32.2
/STRAP_GPIO8: R24.2, U4.10 (GPIO8)
/U0RXD: J1.2, U4.22 (U0RXD/GPIO23/FSPICS1)
/U0TXD: R40.1, U4.23 (U0TXD/GPIO24/FSPICS2)
/U0TXD_J: J1.1, R40.2
/USB_DM: J1.4, U4.25 (USB_D-/GPIO26/FSPICS4)
/USB_DP: J1.3, U4.26 (USB_D+/GPIO27/FSPICS5)
/VBAT: BT1.1 (+), R1.1, R31.1, TP1.1
/VBAT_L: Q1.3 (D), R1.2
/VBAT_MEAS_EN: Q3.1 (G), R35.1, U4.14 (GPIO12)
/VBAT_SENSE: C31.1, R31.2, R32.1, U4.8 (MTDI/GPIO5/FSPID/ADC1_CH4)
/VIN: C1.1, C2.1, C3.1, C5.1, Q1.2 (S), TP2.1, U1.1 (EN), U1.10 (VIN)
/VOUT: C4.1, C21.1, C22.1, R21.1, TP3.1, U1.6 (VOUT)
/XTAL_32K_N: C28.1, U4.16 (GPIO14/XTAL_32K_N), Y1.2
/XTAL_32K_P: C27.1, U4.15 (GPIO13/XTAL_32K_P), Y1.1
/XTAL_N: C50.1, U4.28 (XTAL_N), Y2.3
/XTAL_P: C49.1, L3.2, Y2.1
/XTAL_P_IC: L3.1, U4.29 (XTAL_P)
/nRST: R22.1, U3.2 (~RESET)
GND: AE1.2 (Shield), BT1.2 (-), C1.2, C2.2, C3.2, C4.2, C5.2, C21.2, C22.2, C25.2, C26.2, C27.2, C28.2, C29.2, C31.2, C40.2, C41.2, C42.2, C43.2, C44.2, C45.2, C46.2, C47.2, C48.2, C49.2, C50.2, C51.2, C52.2, D3.1 (K), J1.6, L5.2, Q1.1 (G), Q3.2 (S), R2.2, R3.2, R4.2, R35.2, SW1.2, SW2.2, TP5.1, U1.2 (SEL), U1.8 (GND), U1.11 (GND), U3.1 (GND), U4.33 (GND), U5.4 (VSS), Y2.2 (G), Y2.4 (G)

Notes on the sheet:
CR2450 -> P-MOSFET -> TPS63900 (3.3 V) -> VOUT
SEL = L: VO(1) = 3.3 V (RCFG3 16.2k, table 7-3). Input current limit 100 mA from RCFG1 0R / RCFG2 10.5k (table 7-2; 13.3k = 50 mA option). TI SLVSET3D, +-1 % resistors. C5: 470 uF electrolytic buffer.
3V3 RAIL, SUPERVISOR, RESET
ESP32-H2FH4S CHIP, 32 MHz AND 32.768 kHz CRYSTALS, RF MATCH + PCB ANTENNA, BUTTON, LED, DEBUG
C40-C42: VDD3P3 pins 1/2. C43: pins 30/31. C44, C45: pin 27. C46: VDDPST2 (20). C47: VDDA_PMU (19) and VBAT (18). C48: VDDPST1 (9). Place each at its pin (HDG v1.6 schematic checklist).
RF: 50 ohm line, 0201 parts. C51/L4/C52 = HDG C12/L2/C11, start values from the HDG ranges; R41 (HDG C3) is a 0R link, L5 (HDG L1) not fitted. All five must be tuned with a network analyser.
GPIO8/GPIO9 strapping: GPIO9 low at reset (SW1 held) = download mode. GPIO0/1/2/3/4/25: no connect, firmware disables input + pull-down. J1 (not fitted) has no supply pin: the cell powers the board.
SHT40 (on a slotted tongue, away from converters and module)
No copper under the sensor except its pads; do not solder the die pad (SHT4x datasheet).
CELL VOLTAGE SENSE (switched 470k/470k divider, ADC1_CH4 on GPIO5)
Switch open: no divider current. GPIO12 high for ~30 ms every 6 h: 470k/470k -> ~3.2 uA while on. The divider top is at the holder terminal (before the 0R link), so a missing cell reads ~0 V.
TEST PADS, MECHANICAL, NOTES
CR2450 ONLY - NOT RECHARGEABLE. No other supply can reach the rail: the cell is the only energy source. Power-path decision and its limits: docs/decisions.md, docs/power_budget.md (ESTIMATE until measured). Current measurement: remove R1 (cell) or R21 (load) and insert the ammeter. U3 TPS3839K33: 2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

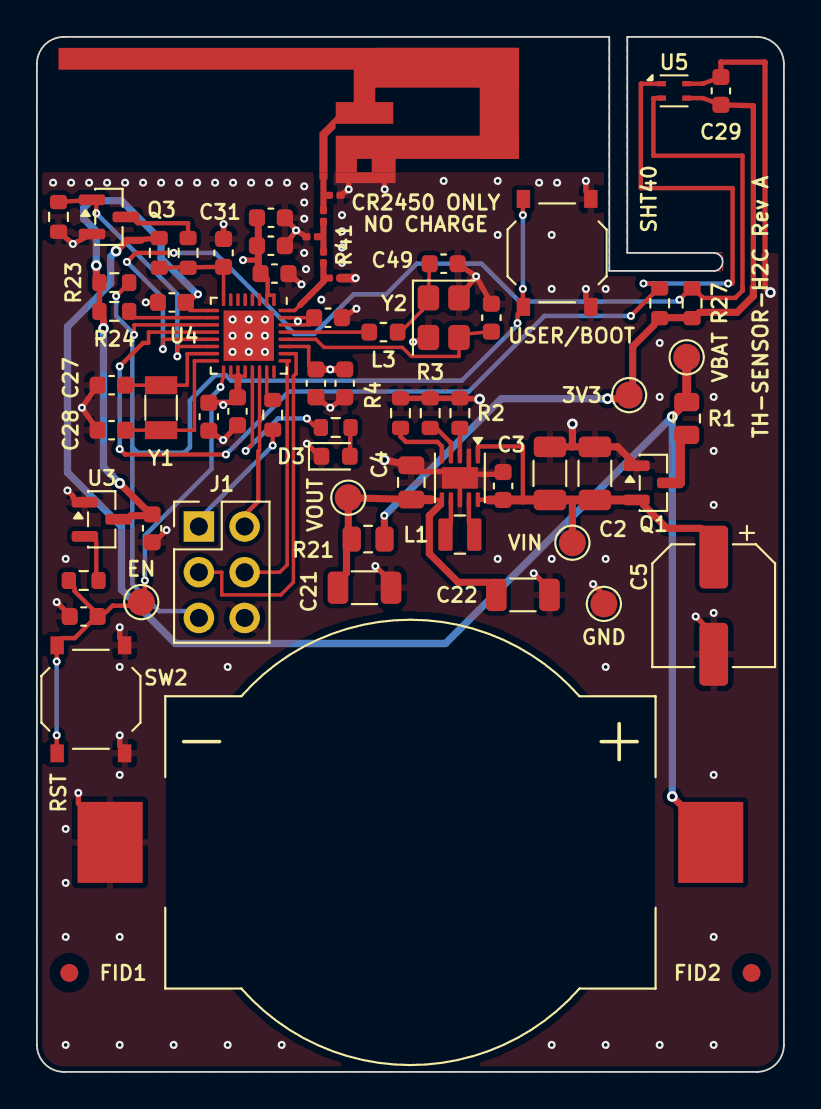
[picture p17: board th_sensor_h2c.kicad_pcb from above]

Board: 4 copper layers, 41.5 x 57.5 mm, 68 parts (0 on the bottom side), 35 nets.
