haxeko/matter-temperature-sensor/firmware/components/board/include/board_pins.h

/*
 * Board pin map — single source of truth for firmware.
 *
 * Board: TH-SENSOR-H2 Rev B (hardware/kicad/th_sensor_h2.kicad_sch)
 * Module: ESP32-H2-MINI-1-H4S (datasheet v1.6, Table 3 "Pin Definitions").
 *
 * Every assignment below must match docs/pinmap.md and the net names in the
 * KiCad schematic. tools/check_pinmap.py cross-checks this file against the
 * exported KiCad netlist; run it after any change on either side.
 *
 * Module pad numbers are given for traceability (MINI-1 pad, not chip pin).
 */
#pragma once

/* ---- Strapping / boot ---------------------------------------------------
 * GPIO9: BOOT strap, weak pull-up inside, external 10k pull-up on the board.
 *        Low at reset (with GPIO8 high) = Joint Download Boot.
 *        Re-used as the single USER button after boot (active low).
 * GPIO8: strap, floating inside; external 10k pull-up so that GPIO9 low at
 *        reset selects download mode. Not used by the application.
 * GPIO25: JTAG-source strap only when EFUSE_STRAP_JTAG_SEL_ENABLE=1 (not
 *        burnt by default). Left unconnected.
 */
#define BOARD_GPIO_USER_BUTTON      9   /* module pad 23, net BTN_USER, active low */
#define BOARD_USER_BUTTON_ACTIVE    0
#define BOARD_GPIO_STRAP8           8   /* module pad 22, net STRAP_GPIO8 (10k to 3V3) */

/* ---- SHT40 on I2C (external 10k pull-ups to 3V3) ------------------------ */
#define BOARD_GPIO_I2C_SDA          10  /* module pad 20, net I2C_SDA */
#define BOARD_GPIO_I2C_SCL          11  /* module pad 21, net I2C_SCL */
#define BOARD_I2C_PORT              0
#define BOARD_I2C_FREQ_HZ           100000

/* ---- Status LED (active high, 0603 red LED + 1k to GND) ----------------- */
#define BOARD_GPIO_LED              22  /* module pad 24, net LED */
#define BOARD_LED_ACTIVE            1

/* ---- Cell voltage sense (switched 470k/470k divider) ---------------------
 * Power path (docs/architecture.md): one CR2450 feeds one TPS63900; VBAT is
 * the holder + terminal (before the 0R measurement link).
 * GPIO12 drives the gate of the low-side NMOS switch (Q3) that connects the
 * divider bottom to GND (1M gate pull-down keeps it off in reset/sleep).
 * Both pins sit on the module's bottom edge: the left edge is reserved for
 * 3V3 and EN because the module is placed <= 2 mm from the board edge
 * (antenna keepout, docs/decisions.md).
 * The divider mid-point has 22 nF to GND: tau = 235 kOhm * 22 nF = 5.2 ms.
 */
#define BOARD_GPIO_VBAT_MEAS_EN     12  /* module pad 16, net VBAT_MEAS_EN */
#define BOARD_GPIO_VBAT_SENSE       5   /* module pad 19, net VBAT_SENSE, ADC1_CH4 */
#define BOARD_VBAT_ADC_UNIT         0   /* ADC_UNIT_1 */
#define BOARD_VBAT_ADC_CHANNEL      4   /* ADC_CHANNEL_4 */
#define BOARD_VBAT_DIVIDER_NUM      2   /* V_cell = V_sense * NUM / DEN */
#define BOARD_VBAT_DIVIDER_DEN      1
#define BOARD_VBAT_SETTLE_MS        30  /* > 5 tau */

/* ---- 32.768 kHz crystal (RTC slow clock) -------------------------------- */
#define BOARD_GPIO_XTAL32K_P        13  /* module pad 12, net XTAL_32K_P */
#define BOARD_GPIO_XTAL32K_N        14  /* module pad 13, net XTAL_32K_N */

/* ---- Debug interfaces (J1, 1x6 pads under the antenna notch, not fitted) - */
#define BOARD_GPIO_UART0_RX         23  /* module pad 30, net U0RXD (RXD0) */
#define BOARD_GPIO_UART0_TX         24  /* module pad 31, net U0TXD (TXD0) */
#define BOARD_GPIO_USB_DM           26  /* module pad 26, net USB_DM (straight to J1) */
#define BOARD_GPIO_USB_DP           27  /* module pad 27, net USB_DP (straight to J1) */

/* ---- Pins with no connection on Rev B -------------------------------------
 * Configured by board_init() as input-disabled with pull-down so that they
 * cannot float (ESP32-H2 HW design guidelines, section "GPIO").
 * GPIO25 has no internal pulls; input is disabled instead.
 */
#define BOARD_UNUSED_GPIO_LIST      { 0, 1, 2, 3, 4, 25 }
