haxeko/matter-temperature-sensor/hardware/scripts/gen_pcb.py

#!/usr/bin/env python3
"""
Build hardware/kicad/th_sensor_h2.kicad_pcb from design.py: placement, board
outline, rule areas, hand-routed converter blocks, routing (router.py), ground
planes, stitching vias and silkscreen.

Board (Rev B): 41.5 x 57.5 mm, 2 layers, 1.6 mm FR-4, all parts on the top side, one CR2450
holder along the bottom edge (Rev A: 72 x 58 mm with two CR2032).
Coordinates below are relative to the board's top-left corner (KiCad y down).

Usage: python3 gen_pcb.py [--no-route]
"""
import math
import os
import re
import subprocess
import sys

import pcbnew

import design as D

HERE = os.path.dirname(os.path.abspath(__file__))
KDIR = os.path.normpath(os.path.join(HERE, "..", "kicad"))
PCB = os.path.join(KDIR, D.PROJECT + ".kicad_pcb")
SCH = os.path.join(KDIR, D.PROJECT + ".kicad_sch")
KFP = "/usr/share/kicad/footprints/"
PROJ_FP = os.path.join(KDIR, "lib", "th_sensor.pretty")
REPORTS = os.path.normpath(os.path.join(HERE, "..", "reports"))

OX, OY = 100.0, 60.0          # board origin on the KiCad page
W, H = 41.5, 57.5             # board size
CORNER_R = 1.5

# Module position follows the ESP32-H2 hardware design guidelines, section
# "Positioning a Module on a Base Board", figure "Keepout Zone for ESP32-H2
# Module's Antenna (feed point on the left)": module in the top-left corner,
# module edge <= 2 mm from the left board edge, <= 1 mm from the top edge, and
# no board material for >= 15 mm beside the 5.4 mm antenna region.
MOD_X, MOD_Y = 8.6, 8.8                      # module centre; body 13.2 x 16.6 mm
MOD_L, MOD_T = MOD_X - 6.6, MOD_Y - 8.3      # 2.0 / 0.5 mm from the edges
NOTCH_X1, NOTCH_X2, NOTCH_D = MOD_X + 7.0, MOD_X + 7.0 + 16.2, 6.0
# SHT40 tongue in the top-right corner: x1..W, 0..y2, cut free by a 1 mm slot that continues the
# notch edge downwards and turns right under the tongue; only the bridge (bridge_x1..W) holds it.
SHT_TONGUE = dict(x1=NOTCH_X2 + 1.0, y2=12.0, slot_w=1.0, bridge_x1=W - 3.4)
CELL_R = 12.25 + 0.6                          # CR2450 radius 12.25 + 0.6 margin
CELL_BODY = (13.6, 8.1)                       # holder body half-size (27.0 x 16.0 mm + margin)
SIGNAL_W, POWER_W = 0.25, 0.4

mm = pcbnew.FromMM


def V(x, y):
    return pcbnew.VECTOR2I(mm(OX + x), mm(OY + y))


# ------------------------------------------------------------------ placement
# (x, y, rotation in degrees counter-clockwise) relative to the board corner
PLACE = {}


def at(ref, x, y, rot=0):
    PLACE[ref] = (x, y, rot)


at("U4", MOD_X, MOD_Y, 0)
at("C24", 1.0, 7.6, 90)            # 100 nF beside pad 3 (3V3), in the 2 mm strip left of the module
# debug header (not fitted) under the antenna notch: order follows the module pins
at("J1", 17.3, 7.9, 90)            # 1 TXD 2 RXD 3 D+ 4 D- 5 BOOT 6 GND, pitch 2.54 along +x
at("R25", 16.2, 17.4, 90)          # LED, beside the module corner (LED pad at the bottom)
at("D3", 17.9, 17.4, 90)           # anode at the top, next to R25
# user/boot button and strap pull-ups under J1
at("SW1", 27.0, 13.4, 0)           # BTN pads at the top
at("R23", 21.6, 11.0, 0)
at("R24", 21.6, 12.8, 0)
# SHT40 on the tongue (top-right corner), pull-ups on the main board below the bridge
at("U5", 35.4, 3.0, 0)
at("C29", 38.0, 3.0, 90)
at("R26", 34.6, 14.8, 90)
at("R27", 36.4, 14.8, 90)
# 32.768 kHz crystal under XTAL_32K_P/N (pads 12/13), load caps under it
at("Y1", 3.6, 20.4, 180)
at("C27", 2.35, 23.3, 270)
at("C28", 4.85, 23.3, 270)
# cell-voltage divider below pads 16/19
at("C31", 9.4, 23.1, 270)
at("R32", 9.4, 26.5, 270)
at("Q3", 9.4, 30.1, 90)
at("R31", 11.6, 25.1, 90)
at("R35", 11.8, 33.1, 0)
# supervisor, EN RC, module bulk cap, reset button: down the left edge beside the holder
at("U3", 3.8, 26.8, 0)
at("C26", 6.6, 27.8, 270)
at("C23", 6.6, 31.4, 270)
at("R22", 2.6, 30.2, 180)
at("C25", 2.6, 32.2, 180)
at("SW2", 3.0, 36.8, 90)
at("TP6", 8.4, 34.8, 0)            # EN
# 3V3 rail between the converter output and the module
at("C21", 15.0, 22.0, 90)
at("C22", 15.0, 26.6, 90)
at("R21", 15.0, 30.6, 0)
at("TP4", 18.6, 30.6, 0)           # +3V3
at("TP5", 31.5, 31.5, 0)           # GND
at("C5", 37.6, 31.6, 270)          # 470 uF bulk at VIN (+ pad up), in the shoulder right of the cell
at("FID1", 1.8, 52.0, 0)
at("FID2", 39.7, 52.0, 0)


# the converter, laid out like the TPS63900 datasheet example (inductor next to the IC, input
# capacitors on one side, output capacitor on the other, CFG resistors opposite the inductor).
# Local coordinates below are the Rev A block; Rev B places it rotated by 180 degrees so that the
# input side faces the cell's + contact on the right.
BLOCK = dict(ux=23.5, uy=24.5, rot180=True)
BLOCK_REFS = dict(U="U1", L="L1", Q="Q1", RL="R1", C1="C1", C2="C2", C3="C3", C4="C4", RC1="R2", RC2="R3",
                  RC3="R4", TPB="TP1", TPI="TP2", TPO="TP3")
BLOCK_PLACE = [("U", 0.0, 0.0, 90), ("L", 0.0, -3.15, 0), ("C1", -2.4, -0.45, 270), ("C2", -7.5, 0.25, 270),
               ("C3", -5.0, 0.25, 270), ("C4", 2.7, -0.25, 270), ("RC1", 0.0, 3.6, 270), ("RC2", 1.65, 3.6, 270),
               ("RC3", 3.3, 3.6, 270), ("Q", -10.75, -0.275, 180),
               ("RL", -12.6, 3.3, 90), ("TPB", -12.6, 6.7, 0), ("TPI", -6.25, -3.6, 0), ("TPO", 5.55, -1.0, 0)]
# hand-routed copper inside the block: (net, width, points); a point is (part key, pad) or local (x, y)
BLOCK_ROUTES = [
    ("VIN", 0.5, [("Q", "2"), ("C2", "1"), ("C3", "1"), (-3.5, -1.225), ("C1", "1"), (-1.6, -1.225)]),
    ("VIN", 0.25, [(-1.6, -1.225), ("U", "10")]),
    ("VIN", 0.4, [("TPI", "1"), (-6.25, -1.225)]),
    ("VIN", 0.25, [("U", "1"), (-1.0, 1.75), (-3.5, 1.75), (-3.5, -1.225)]),     # EN = VIN
    ("GND", 0.25, [("U", "2"), (-0.5, 0.0)]),                                    # SEL = GND: VO(1)
    ("VBAT_L", 0.5, [("Q", "3"), (-12.25, -0.275), (-12.25, 2.35), ("RL", "2")]),
    ("VBAT", 0.5, [("RL", "1"), ("TPB", "1")]),
    ("LX1", 0.25, [("U", "9"), (-0.5, -2.45), ("L", "1")]),
    ("LX2", 0.25, [("U", "7"), (0.5, -2.45), ("L", "2")]),
    ("GND", 0.25, [("U", "8"), (0.0, -0.3)]),
    ("VOUT", 0.25, [("U", "6"), (1.6, -1.21)]),
    ("VOUT", 0.5, [(1.6, -1.21), ("C4", "1")]),
    ("VOUT", 0.4, [("C4", "1"), ("TPO", "1")]),
    ("GND", 0.3, [("C1", "2"), (-1.95, 0.2), (-0.6, 0.2)]),
    ("GND", 0.3, [(0.6, 0.35), (2.7, 0.35)]),
    ("GND", 0.4, [("C4", "2"), (4.2, 1.0)]),
    ("GND", 0.4, [("Q", "1"), (-8.76, 1.725), ("C2", "2"), ("C3", "2")]),
    ("GND", 0.4, [(-6.25, 1.725), (-6.25, 3.0)]),
    ("CFG1", 0.25, [("U", "3"), ("RC1", "1")]),
    ("CFG2", 0.25, [("U", "4"), (0.5, 1.95), (1.25, 2.7), ("RC2", "1")]),
    ("CFG3", 0.25, [("U", "5"), (1.0, 1.75), (1.25, 2.0), (3.0, 2.0), (3.3, 2.3), ("RC3", "1")]),
    ("GND", 0.3, [("RC1", "2"), ("RC2", "2"), ("RC3", "2")]),
    ("GND", 0.3, [(-1.1, 4.375), ("RC1", "2")]),
]
BLOCK_VIAS = [("GND", (4.2, 1.0)), ("GND", (-6.25, 3.0)), ("GND", (-1.1, 4.375))]


def block_xy(x, y):
    if BLOCK["rot180"]:
        return BLOCK["ux"] - x, BLOCK["uy"] - y
    return BLOCK["ux"] + x, BLOCK["uy"] + y


for key, x, y, rot in BLOCK_PLACE:
    at(BLOCK_REFS[key], *block_xy(x, y), (rot + (180 if BLOCK["rot180"] else 0)) % 360)

# holder: + pad (pad 1) on the right; cell centre = footprint origin, 0.5 mm from the bottom edge
CELLS = {"BT1": (W / 2, H - 12.75)}
for ref, (x, y) in CELLS.items():
    at(ref, x, y, 0)

# module GND pad array (pad 49, 3 x 3): vias in the gaps between the pads, tented
MOD_GND_VIAS = [(MOD_X + dx, MOD_Y + dy) for dx in (-0.9875, 0.9875) for dy in (1.7125, 3.6875)]
MOD_STUB = 1.2           # straight escape from every used module pad, routed before anything else

# fixed copper outside the converter block: pad 3 decoupling, and the SHT40 tongue. The four
# sensor nets leave the package in its cyclic pin order (SDA, SCL, VDD, GND) and reach the bridge
# in the same order from left to right, so nothing crosses on the tongue, where vias are not
# allowed; they end just below the bridge and the router takes over there.
FIXED_ROUTES = [
    ("+3V3", 0.3, [("U4", "3"), (1.7, 9.1), ("C24", "1")]),
    ("GND", 0.3, [("C24", "2"), (1.7, 7.5), ("U4", "1")]),
    # every trace leaves its pad outwards: the SHT4x footprint keeps copper out of the package area
    ("I2C_SDA", SIGNAL_W, [("U5", "1"), (33.55, 2.6), (33.55, 8.4), (38.65, 8.4), (38.65, 13.9)]),
    ("I2C_SCL", SIGNAL_W, [("U5", "2"), (34.25, 3.4), (34.25, 6.6), (39.2, 6.6), (39.2, 13.9)]),
    ("+3V3", SIGNAL_W, [("U5", "3"), (37.0, 3.4), ("C29", "1")]),
    ("+3V3", 0.3, [("C29", "1"), (39.8, 3.825), (39.8, 13.9)]),
    ("GND", SIGNAL_W, [("U5", "4"), (37.0, 2.6), ("C29", "2")]),
    ("GND", 0.3, [("C29", "2"), (38.0, 1.4), (40.45, 1.4), (40.45, 13.9), (40.75, 14.2)]),
]
# the GND via sits right of the +3V3 lane so that a 0.4 mm +3V3 track can continue straight down
FIXED_VIAS = [("GND", (40.75, 14.2))]


# ------------------------------------------------------------------ helpers
def load_footprint(fpid):
    lib, name = fpid.split(":")
    path = PROJ_FP if lib == "th_sensor" else KFP + lib + ".pretty"
    fp = pcbnew.FootprintLoad(path, name)
    if fp is None:
        raise SystemExit("footprint not found: " + fpid)
    fp.SetFPID(pcbnew.LIB_ID(lib, name))
    return fp


def schematic_netlist():
    """From the KiCad netlist: reference -> symbol UUID (links footprints to symbols) and
    (ref, pin) -> net name exactly as the schematic names it (local labels carry a '/')."""
    net = os.path.join(KDIR, D.PROJECT + ".net")
    subprocess.run(["kicad-cli", "sch", "export", "netlist", "--format", "kicadsexpr", "-o", net, SCH],
                   check=True, capture_output=True)
    text = open(net).read()
    paths = {}
    for m in re.finditer(r'\(comp \(ref "([^"]+)"\).*?\(tstamps "([^"]+)"\)', text, re.S):
        paths[m.group(1)] = m.group(2)
    pins = {}
    chunks = re.split(r'\(net \(code "\d+"\) ', text[text.index("(nets"):])[1:]
    for ch in chunks:
        name = re.match(r'\(name "([^"]+)"\)', ch).group(1)
        for n in re.finditer(r'\(node \(ref "([^"]+)"\) \(pin "([^"]+)"\)', ch):
            pins[(n.group(1), n.group(2))] = name
    return paths, pins


KN = {}          # design.py net name -> KiCad net name, filled by build_board()


def add_line(board, layer, a, b, width=0.1):
    s = pcbnew.PCB_SHAPE(board)
    s.SetShape(pcbnew.SHAPE_T_SEGMENT)
    s.SetStart(V(*a))
    s.SetEnd(V(*b))
    s.SetLayer(layer)
    s.SetWidth(mm(width))
    board.Add(s)
    return s


def add_arc(board, layer, start, mid, end, width=0.1):
    s = pcbnew.PCB_SHAPE(board)
    s.SetShape(pcbnew.SHAPE_T_ARC)
    s.SetArcGeometry(V(*start), V(*mid), V(*end))
    s.SetLayer(layer)
    s.SetWidth(mm(width))
    board.Add(s)


def corner(board, layer, cx, cy, r, a0):
    """Quarter arc around (cx, cy) from angle a0 to a0 + 90 degrees (y down, angles clockwise)."""
    pts = []
    for a in (a0, a0 + 45, a0 + 90):
        t = math.radians(a)
        pts.append((cx + r * math.cos(t), cy + r * math.sin(t)))
    add_arc(board, layer, *pts)


def outline_points():
    """Board outline as one closed polygon (y down): antenna notch top-left, SHT40 tongue top-right
    cut free by a 1 mm slot (straight-ended here; outline() rounds the slot end)."""
    t = SHT_TONGUE
    sw = t["slot_w"]
    return [(0, 0), (NOTCH_X1, 0), (NOTCH_X1, NOTCH_D), (NOTCH_X2, NOTCH_D), (NOTCH_X2, t["y2"] + sw),
            (t["bridge_x1"], t["y2"] + sw), (t["bridge_x1"], t["y2"]), (t["x1"], t["y2"]), (t["x1"], 0),
            (W, 0), (W, H), (0, H)]


def outline(board):
    """Rounded outer corners; the slot under the tongue ends in a half circle (router bit)."""
    L = pcbnew.Edge_Cuts
    r = CORNER_R
    t = SHT_TONGUE
    sw = t["slot_w"]
    xb, y2 = t["bridge_x1"], t["y2"]
    path = [((r, 0), (NOTCH_X1, 0)),
            ((NOTCH_X1, 0), (NOTCH_X1, NOTCH_D)),
            ((NOTCH_X1, NOTCH_D), (NOTCH_X2, NOTCH_D)),
            ((NOTCH_X2, NOTCH_D), (NOTCH_X2, y2 + sw)),
            ((NOTCH_X2, y2 + sw), (xb - sw / 2, y2 + sw)),
            ((xb - sw / 2, y2), (t["x1"], y2)),
            ((t["x1"], y2), (t["x1"], 0)),
            ((t["x1"], 0), (W - r, 0))]
    for a, b in path:
        add_line(board, L, a, b)
    add_arc(board, L, (xb - sw / 2, y2 + sw), (xb, y2 + sw / 2), (xb - sw / 2, y2))    # slot end
    corner(board, L, W - r, r, r, -90)                                   # top-right
    add_line(board, L, (W, r), (W, H - r))
    corner(board, L, W - r, H - r, r, 0)                                 # bottom-right
    add_line(board, L, (W - r, H), (r, H))
    corner(board, L, r, H - r, r, 90)                                    # bottom-left
    add_line(board, L, (0, H - r), (0, r))
    corner(board, L, r, r, r, 180)                                       # top-left


def outline_polygon():
    """Outline polygon for the copper zones (corners approximated; zones are clipped by the edge)."""
    r = CORNER_R
    pts = [(r, 0)] + outline_points()[1:10]
    for cx, cy, a0 in ((W - r, r, -90), (W - r, H - r, 0), (r, H - r, 90), (r, r, 180)):
        for k in range(0, 91, 15):
            tt = math.radians(a0 + k)
            pts.append((cx + r * math.cos(tt), cy + r * math.sin(tt)))
    return pts


def circle_pts(cx, cy, r, n=48):
    return [(cx + r * math.cos(2 * math.pi * k / n), cy + r * math.sin(2 * math.pi * k / n)) for k in range(n)]


def rule_area(board, name, poly, layers=("F.Cu", "B.Cu"), tracks=True, vias=True, pour=True, pads=False,
              footprints=False):
    z = pcbnew.ZONE(board)
    z.SetIsRuleArea(True)
    z.SetZoneName(name)
    ls = pcbnew.LSET()
    for l in layers:
        ls.AddLayer(board.GetLayerID(l))
    z.SetLayerSet(ls)
    z.SetDoNotAllowTracks(tracks)
    z.SetDoNotAllowVias(vias)
    z.SetDoNotAllowCopperPour(pour)
    z.SetDoNotAllowPads(pads)
    z.SetDoNotAllowFootprints(footprints)
    o = z.Outline()
    o.NewOutline()
    for x, y in poly:
        o.Append(mm(OX + x), mm(OY + y))
    board.Add(z)
    return z


def copper_zone(board, layer, net, poly, priority=0, clearance=0.25, min_width=0.25, name=""):
    z = pcbnew.ZONE(board)
    z.SetLayer(board.GetLayerID(layer))
    z.SetNet(net)
    z.SetZoneName(name)
    z.SetAssignedPriority(priority)
    z.SetLocalClearance(mm(clearance))
    z.SetMinThickness(mm(min_width))
    z.SetPadConnection(pcbnew.ZONE_CONNECTION_THERMAL)
    z.SetThermalReliefGap(mm(0.3))
    z.SetThermalReliefSpokeWidth(mm(0.35))
    z.SetIslandRemovalMode(pcbnew.ISLAND_REMOVAL_MODE_ALWAYS)
    o = z.Outline()
    o.NewOutline()
    for x, y in poly:
        o.Append(mm(OX + x), mm(OY + y))
    board.Add(z)
    return z


def silk_text(board, text, x, y, size=1.0, rot=0, layer="F.SilkS", bold=False, justify=None, thick=None):
    t = pcbnew.PCB_TEXT(board)
    t.SetText(text)
    t.SetPosition(V(x, y))
    t.SetLayer({"F.SilkS": pcbnew.F_SilkS, "B.SilkS": pcbnew.B_SilkS, "F.Fab": pcbnew.F_Fab}[layer])
    t.SetTextSize(pcbnew.VECTOR2I(mm(size), mm(size)))
    t.SetTextThickness(mm(thick if thick else max(0.15, size * 0.15)))
    t.SetTextAngleDegrees(rot)
    t.SetBold(bold)
    if justify == "left":
        t.SetHorizJustify(pcbnew.GR_TEXT_H_ALIGN_LEFT)
    elif justify == "right":
        t.SetHorizJustify(pcbnew.GR_TEXT_H_ALIGN_RIGHT)
    if layer.startswith("B."):
        t.SetMirrored(True)
    board.Add(t)
    return t


def add_track(board, net, a, b, width, layer=pcbnew.F_Cu):
    t = pcbnew.PCB_TRACK(board)
    t.SetStart(V(*a))
    t.SetEnd(V(*b))
    t.SetWidth(mm(width))
    t.SetLayer(layer)
    t.SetNet(net)
    board.Add(t)
    return t


def add_via(board, net, p, dia=0.6, drill=0.3):
    v = pcbnew.PCB_VIA(board)
    v.SetPosition(V(*p))
    v.SetWidth(mm(dia))
    v.SetDrill(mm(drill))
    v.SetNet(net)
    board.Add(v)
    return v


def pad_xy(board, ref, num):
    fp = board.FindFootprintByReference(ref)
    for p in fp.Pads():
        if p.GetNumber() == num:
            q = p.GetPosition()
            return (pcbnew.ToMM(q.x) - OX, pcbnew.ToMM(q.y) - OY)
    raise KeyError(ref + "." + num)


# ------------------------------------------------------------------ board
def build_board(path=PCB):
    # KiCad saves items sorted by UUID: a fixed seed keeps regenerated files diff-friendly.
    pcbnew.KIID.SeedGenerator(1)
    board = pcbnew.NewBoard(path)
    board.SetCopperLayerCount(2)
    bds = board.GetDesignSettings()
    bds.m_TrackMinWidth = mm(0.127)
    bds.m_MinClearance = mm(0.127)
    bds.m_ViasMinSize = mm(0.6)
    bds.m_MinThroughDrill = mm(0.3)
    bds.m_ViasMinAnnularWidth = mm(0.15)
    bds.m_CopperEdgeClearance = mm(0.3)
    bds.m_HoleToHoleMin = mm(0.5)
    bds.m_HoleClearance = mm(0.25)
    bds.m_TentViasFront = True
    bds.m_TentViasBack = True
    bds.SetAuxOrigin(V(0, H))            # drill/place origin: board bottom-left corner (fab outputs)
    tb = board.GetTitleBlock()
    tb.SetTitle("TH-SENSOR-H2")
    tb.SetRevision(D.REV)
    tb.SetDate(D.DATE)
    tb.SetComment(0, "ESP32-H2 Matter/Thread thermo-hygrometer, 1 x CR2450, TPS63900 3.3 V")
    tb.SetComment(1, "Generated by hardware/scripts/gen_pcb.py - 2 layers, 1.6 mm, JLCPCB standard rules")

    paths, sch_pins = schematic_netlist()
    for name, members in D.nets().items():
        kn = {sch_pins.get(m) for m in members}
        if len(kn) != 1 or None in kn:
            raise SystemExit("net %s: schematic names %s" % (name, kn))
        KN[name] = kn.pop()
    nets = {}
    for name in D.nets():
        ni = pcbnew.NETINFO_ITEM(board, KN[name])
        board.Add(ni)
        nets[name] = ni
    nc_nets = {}
    for key, kname in sorted(sch_pins.items()):
        if kname.startswith("unconnected-"):
            ni = pcbnew.NETINFO_ITEM(board, kname)
            board.Add(ni)
            nc_nets[key] = ni
    for p in D.PARTS:
        ref = p["ref"]
        if ref not in PLACE:
            raise SystemExit("no placement for " + ref)
        fp = load_footprint(p["footprint"])
        fp.SetReference(ref)
        fp.SetValue(p["value"])
        x, y, rot = PLACE[ref]
        fp.SetPosition(V(x, y))
        fp.SetOrientationDegrees(rot)
        for k, v in (("LCSC", p["lcsc"]), ("MPN", p["mpn"]), ("Manufacturer", p["mfr"]), ("Spec", p["spec"])):
            if v:
                fp.SetField(k, v)
                f = fp.GetFieldByName(k)
                f.SetVisible(False)
                f.SetLayer(pcbnew.F_Fab)
        if ref in paths:
            fp.SetPath(pcbnew.KIID_PATH("/" + paths[ref]))
        fp.SetDNP(bool(p["dnp"]))
        fp.SetExcludedFromBOM(not p["in_bom"])
        if not p["in_bom"] or p["dnp"]:
            fp.SetExcludedFromPosFiles(True)
        board.Add(fp)
        for pad in fp.Pads():
            net = p["pins"].get(pad.GetNumber())
            if net:
                pad.SetNet(nets[net])
            elif (ref, pad.GetNumber()) in nc_nets:
                pad.SetNet(nc_nets[(ref, pad.GetNumber())])
        fp.Reference().SetTextSize(pcbnew.VECTOR2I(mm(0.8), mm(0.8)))
        fp.Reference().SetTextThickness(mm(0.15))
        fp.Value().SetVisible(False)

    outline(board)
    # antenna: no copper left of the module's own keepout either (module footprint carries the rest)
    rule_area(board, "ANTENNA_KEEPOUT", [(0, 0), (NOTCH_X1, 0), (NOTCH_X1, NOTCH_D), (0, NOTCH_D)])
    t = SHT_TONGUE
    # tongue: tracks only, no vias, no pour (thermal isolation of the SHT40)
    rule_area(board, "SHT40_TONGUE", [(t["x1"], 0), (W, 0), (W, t["y2"]), (t["x1"], t["y2"])],
              tracks=False, vias=True, pour=True)
    # nothing on F.Cu under the cell and the holder body: the cell overhangs the 16 mm body and its
    # can (+) sits close to the board surface
    bx, by = CELL_BODY
    for ref, (cx, cy) in CELLS.items():
        rule_area(board, "CELL_" + ref, circle_pts(cx, cy, CELL_R), layers=("F.Cu",))
        rule_area(board, "HOLDER_" + ref, [(cx - bx, cy - by), (cx + bx, cy - by), (cx + bx, cy + by),
                                           (cx - bx, cy + by)], layers=("F.Cu",))
    return board, nets


def hand_routes(board, nets):
    """Converter blocks, module GND vias: fixed copper drawn before the router runs."""
    def point(p):
        if isinstance(p[0], str):
            return pad_xy(board, BLOCK_REFS[p[0]], p[1])
        return block_xy(*p)

    for net, w, pts in BLOCK_ROUTES:
        ps = [point(p) for p in pts]
        for a, c in zip(ps[:-1], ps[1:]):
            add_track(board, nets[net], a, c, w)
    for net, p in BLOCK_VIAS:
        add_via(board, nets[net], block_xy(*p))
    for p in MOD_GND_VIAS:
        add_via(board, nets["GND"], p)
    u4 = board.FindFootprintByReference("U4")
    for pad in u4.Pads():
        net = pad.GetNetname()
        if not net or net == KN["GND"]:
            continue
        x, y = pad_xy(board, "U4", pad.GetNumber())
        n = int(pad.GetNumber())
        w = POWER_W if net == KN["+3V3"] else SIGNAL_W
        if 12 <= n <= 24:                       # bottom row: escape downwards
            add_track(board, pad.GetNet(), (x, y), (x, y + MOD_STUB), w)
        elif 25 <= n <= 35:                     # right column: escape to the right
            add_track(board, pad.GetNet(), (x, y), (x + MOD_STUB, y), w)
        elif n == 8:                            # EN: into the 2 mm strip on the left
            add_track(board, pad.GetNet(), (x, y), (1.5, y), w)
    for net, w, pts in FIXED_ROUTES:
        ps = [pad_xy(board, *p) if isinstance(p[0], str) else p for p in pts]
        for a, c in zip(ps[:-1], ps[1:]):
            add_track(board, nets[net], a, c, w)
    for net, p in FIXED_VIAS:
        add_via(board, nets[net], p)


# ------------------------------------------------------------------ routing
# order and widths: power first, then signals; per-net layer costs (F.Cu, B.Cu)
ROUTE_PLAN = [
    ("XTAL_32K_P", SIGNAL_W, (1.0, 50.0)),
    ("XTAL_32K_N", SIGNAL_W, (1.0, 50.0)),
    ("USB_DP", SIGNAL_W, (1.0, 6.0)),
    ("USB_DM", SIGNAL_W, (1.0, 6.0)),
    ("U0TXD", SIGNAL_W, (1.0, 3.0)),
    ("U0RXD", SIGNAL_W, (1.0, 3.0)),
    # bottom-row pads that head east: rightmost pad first, so each takes the next lane out
    ("LED", SIGNAL_W, (1.0, 3.0)),
    ("LED_A", SIGNAL_W, (1.0, 3.0)),
    ("BTN_USER", SIGNAL_W, (1.0, 2.5)),
    ("STRAP_GPIO8", SIGNAL_W, (1.0, 2.5)),
    ("I2C_SCL", SIGNAL_W, (1.0, 2.5)),
    ("I2C_SDA", SIGNAL_W, (1.0, 2.5)),
    # divider nets go down below the east-going lanes
    ("VBAT_MEAS_EN", SIGNAL_W, (1.0, 3.0)),
    ("VBAT_SENSE", SIGNAL_W, (1.0, 3.0)),
    ("SNS_LO", SIGNAL_W, (1.0, 3.0)),
    ("EN", SIGNAL_W, (1.0, 3.0)),
    ("nRST", SIGNAL_W, (1.0, 3.0)),
    ("VIN", POWER_W, (1.0, 5.0)),
    ("VOUT", POWER_W, (1.0, 5.0)),
    ("+3V3", POWER_W, (1.0, 4.0)),
    ("VBAT", POWER_W, (1.0, 3.0)),
]


def router_keepouts(R):
    """Router-only restrictions (no KiCad rule area needed)."""
    # module underside: no signal tracks inside the pad ring on F.Cu, none under the body on B.Cu,
    # no vias except GND (the GND pad-array vias)
    x0, x1 = MOD_X - 5.9 + 0.45, MOD_X + 5.9 - 0.45
    y0, y1 = MOD_Y - 2.2 + 0.45, MOD_Y + 7.6 - 0.45
    R.keepout_polygon([(x0, y0), (x1, y0), (x1, y1), (x0, y1)], layers=(0,), tracks=True, vias=False)
    body = [(MOD_L, MOD_T), (MOD_L + 13.2, MOD_T), (MOD_L + 13.2, MOD_T + 16.6), (MOD_L, MOD_T + 16.6)]
    R.keepout_polygon(body, layers=(1,), tracks=True, vias=True, vias_except_gnd=True)
    # 32 kHz crystal: nothing under it on either layer (HDG crystal guidelines)
    cx, cy, _ = PLACE["Y1"]
    R.keepout_polygon([(cx - 1.0, cy - 0.9), (cx + 1.0, cy - 0.9), (cx + 1.0, cy + 0.9), (cx - 1.0, cy + 0.9)],
                      layers=(0, 1), tracks=True, vias=True)
    # fiducials keep their 2 mm mask opening free
    for ref in ("FID1", "FID2"):
        fx, fy, _ = PLACE[ref]
        R.keepout_polygon(circle_pts(fx, fy, 1.35, 24), layers=(0,), tracks=True, vias=True)


def route(board, nets):
    import router as RT
    R = RT.Router(board, OX, OY, W, H, grid=0.1, clearance=0.2, edge_clearance=0.3)
    R.build()
    router_keepouts(R)
    gnd_pads = []
    skip = {"U4", "J1"}                                   # module: pour + pad-array vias; J1: through-hole
    for fp in board.GetFootprints():
        if fp.GetReference() in skip or fp.GetReference() == BLOCK_REFS["U"]:
            continue
        for p in fp.Pads():
            if p.GetNetname() == "GND":
                gnd_pads.append(p)
    # module corner GND pads sit outside the pad ring where the inner pour cannot reach them
    gnd_pads += [p for p in board.FindFootprintByReference("U4").Pads() if p.GetNumber() in ("50", "51", "52", "53")]
    # pads already tied to a via by the hand routes need nothing more
    tied = set()
    for cl in R.clusters("GND"):
        if any(t.GetClass() == "PCB_VIA" for t in cl["tracks"]):
            tied |= {RT.pad_name(p) for p in cl["pads"]}
    gnd_pads = [p for p in gnd_pads if RT.pad_name(p) not in tied]
    R.gnd_fanout(gnd_pads)
    for net, w, lc in ROUTE_PLAN:
        R.route_net(KN[net], width=w, layer_cost=lc)
    return R


def remove_dangling(board):
    """Trim track segments with a free end back to their last junction (escape stubs the router
    did not use, or used part-way); a segment with no junction at all is deleted."""
    changed = 0
    while True:
        tracks, vias, pads = {}, {}, {}
        for t in board.GetTracks():
            (vias if t.GetClass() == "PCB_VIA" else tracks).setdefault(t.GetNetCode(), []).append(t)
        for fp in board.GetFootprints():
            for p in fp.Pads():
                pads.setdefault(p.GetNetCode(), []).append(p)

        def others(t):
            me = t.m_Uuid.AsString()
            return [o for o in tracks.get(t.GetNetCode(), []) if o.GetLayer() == t.GetLayer() and o.m_Uuid.AsString() != me]

        def touches(t, pt):
            L = t.GetLayer()
            if any(p.IsOnLayer(L) and p.HitTest(pt) for p in pads.get(t.GetNetCode(), [])):
                return True
            if any(v.HitTest(pt) for v in vias.get(t.GetNetCode(), [])):
                return True
            return any(o.HitTest(pt) for o in others(t))

        work = 0
        for ts in list(tracks.values()):
            for t in ts:
                a, b = t.GetStart(), t.GetEnd()
                ca, cb = touches(t, a), touches(t, b)
                if ca and cb:
                    continue
                if not ca and not cb:
                    board.Remove(t)
                    work += 1
                    continue
                keep, free = (a, b) if ca else (b, a)
                # junctions on this segment: other segments' ends, vias, pads crossing it
                dx, dy = free.x - keep.x, free.y - keep.y
                L2 = float(dx * dx + dy * dy) or 1.0
                best = None
                cand = [q for o in others(t) for q in (o.GetStart(), o.GetEnd()) if t.HitTest(q)]
                cand += [v.GetPosition() for v in vias.get(t.GetNetCode(), []) if t.HitTest(v.GetPosition())]
                for q in cand:
                    u = ((q.x - keep.x) * dx + (q.y - keep.y) * dy) / L2
                    if 1e-6 < u < 1 - 1e-6 and (best is None or u > best):
                        best = u
                if best is None:
                    board.Remove(t)
                else:
                    end = pcbnew.VECTOR2I(int(round(keep.x + best * dx)), int(round(keep.y + best * dy)))
                    t.SetStart(keep)
                    t.SetEnd(end)
                work += 1
        if not work:
            return changed
        changed += work


def stitch(board, R):
    """GND stitching: dense row along the antenna keepout edge, then a 3.5 mm grid."""
    sites = [(x, NOTCH_D + 0.9) for x in [NOTCH_X1 + 1.0 + 1.5 * k for k in range(10)] if x < NOTCH_X2 - 0.9]
    sites += [(0.8, 6.9)]
    step = 3.5
    y = 2.0
    while y < H - 1.0:
        x = 2.0
        while x < W - 1.0:
            sites.append((x, y))
            x += step
        y += step
    placed = R.stitch(sites)
    return placed


def add_zones(board, nets):
    poly = outline_polygon()
    copper_zone(board, "F.Cu", nets["GND"], poly, name="GND_TOP")
    copper_zone(board, "B.Cu", nets["GND"], poly, name="GND_BOTTOM")
    filler = pcbnew.ZONE_FILLER(board)
    filler.Fill(board.Zones())


def prune_stitching(board, vias):
    """Remove stitching vias that ended up connected to only one plane."""
    zones = {z.GetLayer(): z for z in board.Zones() if not z.GetIsRuleArea()}
    removed = 0
    for v in vias:
        p = v.GetPosition()
        ok = all(zones[L].HitTestFilledArea(L, p) for L in (pcbnew.F_Cu, pcbnew.B_Cu))
        if not ok:
            board.Remove(v)
            removed += 1
    return removed


# silkscreen regions (x1, y1, x2, y2) searched for a free spot, board coordinates
SILK_WARNING_REGION = (20.0, 29.4, 29.0, 30.6)     # two lines between the converter and the holder
SILK_NAME_REGION = (5.0, 17.6, 10.0, 19.2)         # one line under the module
# (label, part it names, region, angles)
SILK_LABELS = (("RST", "SW2", (0.6, 41.0, 1.8, 46.0), (90,)),       # strip left of the holder, below SW2
               ("USER/BOOT", "SW1", (23.0, 16.6, 31.0, 17.6), (0,)),
               ("SHT40", "U5", (33.2, 9.0, 38.0, 11.6), (0, 90)))


class SilkPlacer:
    """Places silkscreen text where it overlaps no pad, no other silk, no courtyard of another part
    and stays clear of the board edge. Coordinates in mm relative to the board corner."""

    def __init__(self, board):
        self.board = board
        self.obst = []           # (x1, y1, x2, y2, owner reference or None)
        mmr = lambda v: pcbnew.ToMM(v)
        for fp in board.GetFootprints():
            ref = fp.GetReference()
            for pad in fp.Pads():
                if pad.IsOnLayer(pcbnew.F_Cu) or pad.IsOnLayer(pcbnew.F_Mask):
                    self._add(pad.GetBoundingBox(), 0.2, None)
            for it in fp.GraphicalItems():
                if it.GetLayer() != pcbnew.F_SilkS:
                    continue
                if it.GetClass() == "PCB_SHAPE" and it.GetShape() in (pcbnew.SHAPE_T_ARC, pcbnew.SHAPE_T_CIRCLE):
                    self._add_curve(it, ref)     # the bounding box of the holder arc would block 19 x 4 mm
                else:
                    self._add(it.GetBoundingBox(), 0.15, ref)
        # courtyards as a raster (holder courtyards are far from rectangular)
        import numpy as np
        self.np = np
        self.g = 0.1
        self.cy = np.full((int(H / self.g) + 2, int(W / self.g) + 2), -1, np.int32)
        self.refs = []
        ys, xs = np.mgrid[0:self.cy.shape[0], 0:self.cy.shape[1]] * self.g
        for k, fp in enumerate(board.GetFootprints()):
            self.refs.append(fp.GetReference())
            cy = fp.GetCourtyard(pcbnew.F_CrtYd)
            for i in range(cy.OutlineCount()):
                ol = cy.Outline(i)
                pts = [(mmr(ol.CPoint(j).x) - OX, mmr(ol.CPoint(j).y) - OY) for j in range(ol.PointCount())]
                inside = np.zeros(xs.shape, bool)
                for a, b in zip(pts, pts[1:] + pts[:1]):
                    cond = (a[1] > ys) != (b[1] > ys)
                    with np.errstate(divide="ignore", invalid="ignore"):
                        xc = (b[0] - a[0]) * (ys - a[1]) / (b[1] - a[1] + 1e-30) + a[0]
                    inside ^= cond & (xs < xc)
                self.cy[inside] = k
        for t in board.GetTracks():
            if t.GetClass() == "PCB_VIA" and not t.IsTented(pcbnew.F_Mask):
                self._add(t.GetBoundingBox(), 0.1, None)
        t = SHT_TONGUE
        self.cuts = [(NOTCH_X2, NOTCH_D, t["x1"], t["y2"] + t["slot_w"]),
                     (NOTCH_X2, t["y2"], t["bridge_x1"], t["y2"] + t["slot_w"]),
                     (NOTCH_X1, 0, t["x1"], NOTCH_D)]

    def _add(self, bb, grow, owner):
        mmr = pcbnew.ToMM
        self.obst.append((mmr(bb.GetX()) - OX - grow, mmr(bb.GetY()) - OY - grow, mmr(bb.GetRight()) - OX + grow,
                          mmr(bb.GetBottom()) - OY + grow, owner))

    def _add_curve(self, it, owner):
        """Arc or circle as a chain of small boxes along the curve."""
        c, r = it.GetCenter(), it.GetRadius()
        if it.GetShape() == pcbnew.SHAPE_T_CIRCLE:
            a0, sweep = 0.0, 2 * math.pi
        else:
            ang = lambda p: math.atan2(p.y - c.y, p.x - c.x)
            a0, am, a1 = ang(it.GetStart()), ang(it.GetArcMid()), ang(it.GetEnd())
            sweep = (a1 - a0) % (2 * math.pi)
            if (am - a0) % (2 * math.pi) > sweep:
                sweep -= 2 * math.pi
        n = max(8, int(abs(sweep) * pcbnew.ToMM(r) / 0.4) + 1)
        pts = [(c.x + r * math.cos(a0 + sweep * k / n), c.y + r * math.sin(a0 + sweep * k / n)) for k in range(n + 1)]
        grow = 0.15 + pcbnew.ToMM(it.GetWidth()) / 2
        for (xa, ya), (xb, yb) in zip(pts[:-1], pts[1:]):
            self.obst.append((pcbnew.ToMM(min(xa, xb)) - OX - grow, pcbnew.ToMM(min(ya, yb)) - OY - grow,
                              pcbnew.ToMM(max(xa, xb)) - OX + grow, pcbnew.ToMM(max(ya, yb)) - OY + grow, owner))

    def _bbox(self, text):
        bb = text.GetBoundingBox()
        return (pcbnew.ToMM(bb.GetX()) - OX, pcbnew.ToMM(bb.GetY()) - OY,
                pcbnew.ToMM(bb.GetRight()) - OX, pcbnew.ToMM(bb.GetBottom()) - OY)

    def free(self, box, owner=None, edge=0.4):
        x1, y1, x2, y2 = box
        if x1 < edge or y1 < edge or x2 > W - edge or y2 > H - edge:
            return False
        for cx1, cy1, cx2, cy2 in self.cuts:
            if x1 < cx2 + edge and x2 > cx1 - edge and y1 < cy2 + edge and y2 > cy1 - edge:
                return False
        for ox1, oy1, ox2, oy2, own in self.obst:
            if own is not None and owner is not None and own == owner:
                continue
            if x1 < ox2 and x2 > ox1 and y1 < oy2 and y2 > oy1:
                return False
        g = self.g
        win = self.cy[int(y1 / g):int(y2 / g) + 2, int(x1 / g):int(x2 / g) + 2]
        own = self.refs.index(owner) if owner in self.refs else -2
        return not ((win >= 0) & (win != own)).any()

    def claim(self, text):
        x1, y1, x2, y2 = self._bbox(text)
        self.obst.append((x1 - 0.1, y1 - 0.1, x2 + 0.1, y2 + 0.1, None))

    def place_text(self, text, candidates, owner=None):
        """candidates: (x, y, angle). Returns True when one fits."""
        for x, y, a in candidates:
            text.SetPosition(V(x, y))
            text.SetTextAngleDegrees(a)
            if self.free(self._bbox(text), owner):
                self.claim(text)
                return True
        return False

    def place_reference(self, fp, field=None):
        """Place fp's reference (or another of its fields) on F.SilkS next to the part; hide it if no room."""
        ref = field if field is not None else fp.Reference()
        ref.SetTextSize(pcbnew.VECTOR2I(mm(0.8), mm(0.8)))
        ref.SetTextThickness(mm(0.15))
        ref.SetLayer(pcbnew.F_SilkS)
        cy = fp.GetCourtyard(pcbnew.F_CrtYd)
        bb = cy.BBox() if cy.OutlineCount() else fp.GetBoundingBox(False)
        x1, y1 = pcbnew.ToMM(bb.GetX()) - OX, pcbnew.ToMM(bb.GetY()) - OY
        x2, y2 = pcbnew.ToMM(bb.GetRight()) - OX, pcbnew.ToMM(bb.GetBottom()) - OY
        cx, cyy = (x1 + x2) / 2, (y1 + y2) / 2
        tw = 0.75 * len(ref.GetText()) + 0.2
        cands = []
        for gap in (0.55, 0.75):                  # nearest ring first, shifted along the side in 0.2 mm steps
            for d in [0.0] + [sgn * 0.2 * i for i in range(1, 9) for sgn in (-1, 1)]:
                cands += [(cx + d, y1 - gap, 0), (cx + d, y2 + gap, 0),
                          (x1 - tw / 2 - gap + 0.45, cyy + d, 0), (x2 + tw / 2 + gap - 0.45, cyy + d, 0),
                          (x1 - gap, cyy + d, 90), (x2 + gap, cyy + d, 90)]
        if self.place_text(ref, cands, owner=fp.GetReference()):
            ref.SetVisible(True)
            return True
        ref.SetVisible(False)          # stays on the assembly drawing (F.Fab carries ${REFERENCE})
        return False

    def place_pair(self, t1, t2, region, dy, step=0.1):
        """Two centred lines, t2 dy below t1, at the first spot in region where both fit."""
        rx1, ry1, rx2, ry2 = region
        y = ry1
        while y <= ry2 + 1e-9:
            x = rx1
            while x <= rx2 + 1e-9:
                t1.SetPosition(V(x, y))
                t2.SetPosition(V(x, y + dy))
                if self.free(self._bbox(t1)) and self.free(self._bbox(t2)):
                    self.claim(t1)
                    self.claim(t2)
                    return True
                x += step
            y += step
        return False

    def free_spot(self, text, region, step=0.5, angles=(0,)):
        rx1, ry1, rx2, ry2 = region
        cands = []
        y = ry1
        while y <= ry2 + 1e-9:
            x = rx1
            while x <= rx2 + 1e-9:
                for a in angles:
                    cands.append((x, y, a))
                x += step
            y += step
        return self.place_text(text, cands)


def silkscreen(board):
    """Reference designators and board texts; returns the references kept on F.Fab only."""
    sp = SilkPlacer(board)
    hidden = []
    order = sorted(board.GetFootprints(), key=lambda f: -f.GetCourtyard(pcbnew.F_CrtYd).Area()
                   if f.GetCourtyard(pcbnew.F_CrtYd).OutlineCount() else 0)
    texts = []

    def txt(text, size=1.0, layer="F.SilkS", bold=False):
        t = silk_text(board, text, 0, 0, size, layer=layer, bold=bold)
        texts.append(t)
        return t

    # front: the cell warning above the holder (both lines or none), then the board name
    missing = []
    t1, t2 = txt("CR2450 ONLY", 0.8, bold=True), txt("NO CHARGE", 0.8, bold=True)
    if not sp.place_pair(t1, t2, SILK_WARNING_REGION, dy=1.2):
        missing.append("CR2450 ONLY / NO CHARGE")
    t = txt("TH-SENSOR-H2 Rev " + D.REV, 0.8, bold=True)
    if not sp.free_spot(t, SILK_NAME_REGION, step=0.2):
        missing.append(t.GetText())
    for label, ref, region, angles in SILK_LABELS:
        t = txt(label, 0.8)
        if not sp.free_spot(t, region, step=0.2, angles=angles):
            missing.append(label)
    # current-measurement links first: the bring-up procedure refers to them by name
    links = ("R1", "R21")
    for ref in links:
        if not sp.place_reference(board.FindFootprintByReference(ref)):
            missing.append(ref)
    # test pads show their net name (VBAT, VIN, 3V3, GND, EN, ...); the TP numbers stay on the assembly drawing.
    # Greedy placement, retried once with the pads that failed placed first.
    tps = sorted((f for f in board.GetFootprints() if f.GetReference().startswith("TP")),
                 key=lambda f: int(f.GetReference()[2:]))
    n_obst = len(sp.obst)
    for attempt in range(2):
        del sp.obst[n_obst:]
        failed = []
        for fp in tps:
            fp.Reference().SetVisible(False)
            if not sp.place_reference(fp, field=fp.Value()):
                failed.append(fp)
        if not failed:
            break
        tps = failed + [f for f in tps if f not in failed]
    missing += [fp.GetReference() + " " + fp.GetValue() for fp in failed]
    if missing:
        raise RuntimeError("silkscreen: no room for " + ", ".join(missing))
    for fp in order:
        if fp.GetReference().startswith("TP") or fp.GetReference() in links:
            continue
        # the holder carries its own +/- marks and the warning above it; its only free spot is beside
        # "RST", where "BT1 RST" would read as one label
        if fp.GetReference() == "BT1" or not sp.place_reference(fp):
            fp.Reference().SetVisible(False)
            hidden.append(fp.GetReference())
    # back: the full story, mirrored
    cx = W / 2
    silk_text(board, "TH-SENSOR-H2 Rev %s  %s" % (D.REV, D.DATE), cx, 24.0, 1.2, layer="B.SilkS", bold=True)
    silk_text(board, "ESP32-H2 Matter/Thread", cx, 26.2, 0.8, layer="B.SilkS")
    silk_text(board, "temperature & humidity", cx, 27.6, 0.8, layer="B.SilkS")
    silk_text(board, "1 x CR2450, TPS63900 3.3 V", cx, 29.0, 0.8, layer="B.SilkS")
    silk_text(board, "CR2450 ONLY - NO CHARGE", cx, 31.4, 1.2, layer="B.SilkS", bold=True)
    silk_text(board, "primary lithium cell - never recharge", cx, 33.4, 0.8, layer="B.SilkS")
    jx, jy, _ = PLACE["J1"]
    for i, lab in enumerate(["TX", "RX", "D+", "D-", "BOOT", "GND"]):
        t = silk_text(board, lab, jx + 2.54 * i, jy, 0.8, rot=90, layer="B.SilkS")
        bb = t.GetBoundingBox()
        top = pcbnew.ToMM(bb.GetY()) - OY
        t.SetPosition(V(jx + 2.54 * i, jy + (jy + 1.35 - top)))     # text starts 0.5 mm below the pad
    silk_text(board, "J1 debug (not fitted): no supply pin,", cx, 17.2, 0.8, layer="B.SilkS")
    silk_text(board, "the cell powers the board", cx, 18.6, 0.8, layer="B.SilkS")
    silk_text(board, "ANTENNA KEEPOUT", 8.6, 3.2, 0.8, layer="B.SilkS")
    return hidden


def place_report(board):
    lines = []
    for fp in board.GetFootprints():
        pos = fp.GetPosition()
        lines.append("%-5s %8.2f %8.2f %6.1f" % (fp.GetReference(), pcbnew.ToMM(pos.x) - OX, pcbnew.ToMM(pos.y) - OY,
                                                fp.GetOrientationDegrees()))
    return "\n".join(sorted(lines))


if __name__ == "__main__":
    board, nets = build_board()
    hand_routes(board, nets)
    report = []
    if "--no-route" not in sys.argv:
        R = route(board, nets)
        report_dangling = remove_dangling(board)
        vias = stitch(board, R)
        report += R.log
        add_zones(board, nets)
        removed = prune_stitching(board, vias)
        report.append("dangling stub segments trimmed or removed: %d" % report_dangling)
        report.append("stitching vias: %d placed, %d removed (single plane)" % (len(vias), removed))
        pcbnew.ZONE_FILLER(board).Fill(board.Zones())
        hidden = silkscreen(board)
        report.append("references on F.Fab only (no room on silk; BT1 by choice): %s" % (", ".join(sorted(hidden)) or "none"))
        os.makedirs(REPORTS, exist_ok=True)
        with open(os.path.join(REPORTS, "routing_log.txt"), "w") as f:
            f.write("\n".join(report) + "\n")
            f.write("unrouted: %d\n" % len(R.unrouted))
            for u in R.unrouted:
                f.write("  " + u + "\n")
        print("\n".join(report[-8:]))
        print("unrouted:", len(R.unrouted), R.unrouted[:20])
    else:
        silkscreen(board)
    pcbnew.SaveBoard(PCB, board)
    # NewBoard() wrote a default project file: write the real one (net classes, rules) and refill the
    # zones under it, so that the saved fill is the one DRC and the fab outputs see
    subprocess.run([sys.executable, os.path.join(HERE, "gen_project.py")], check=True)
    board = pcbnew.LoadBoard(PCB)
    pcbnew.ZONE_FILLER(board).Fill(board.Zones())
    pcbnew.SaveBoard(PCB, board)
    print("saved", PCB)
