haxeko/matter-temperature-sensor/(commit log)

2026-10-29 Add ESP-IDF Matter firmware, power model and KiCad schematic
    Firmware (ESP-IDF v5.5 + esp_matter): SHT40 driver with CRC, button
    gestures (measure / commissioning window / factory reset), per-cell
    battery sense, NVS boot guard, Matter temperature, humidity and power
    source endpoints, host unit tests for the pure logic.
    Hardware: two-cell CR2032 power model (one TPS63900 per cell, diode-OR
    output), schematic generated from hardware/scripts/design.py with ERC
    report. PCB layout follows in a later commit.
    Claude-Session: https://claude.ai/code/session_01TvrXHUQLozvfXGbtsTcbbw
    [partitions.csv, th_sensor_h2.kicad_sch]
2026-10-29 Route the PCB with a scripted grid router; move module per antenna guide
    - Module moved to the top-left corner (<= 2 mm from the edge) with a
    15 mm board notch beside the antenna, per the ESP32-H2 hardware design
    guidelines keepout figure. The left edge now carries only 3V3 and EN,
    so VBAT_MEAS_EN moves to GPIO12, VBAT1_SENSE to GPIO5 (ADC1_CH4) and
    the LED to GPIO22 (schematic, firmware pin map and ADC channel).
    - J1 becomes a horizontal 1x7 header under the notch, ordered like the
    module pins; EN is no longer on the header.
    - gen_pcb.py: converter blocks laid out after the TPS63900 datasheet
    example with hand-routed power loops, fixed SHT40 tongue routing,
    module escape stubs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
    [th_sensor_h2.kicad_pcb, th_sensor_h2.kicad_sch]
2026-10-29 Finish PCB: silkscreen placement, fab outputs, check reports
    - gen_pcb.py: reference designators placed clear of pads, other silk
    and courtyards (rasterised, so concave holder courtyards work); 21
    dense-area references stay on F.Fab only. Cell warning between the
    holders, J1 pinout on the back, tented vias, aux origin at the board
    corner, stitching vias kept clear of pads.
    - gen_production.py: Gerber X2 + Excellon (zip), JLC BOM with a dated
    stock/library snapshot, JLC CPL, pad-1 orientation checklist for the
    placement preview, assembly drawing, manufacturing blockers (module
    stock is 0 at JLC on 2026-10-29).
    - gen_reports.py: ERC, DRC with schematic parity (0 violations, 0
    u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
    [bom_jlc.csv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]
2026-10-29 Add design documentation, pin map cross-check and vendored-library fallback
    - docs/: architecture, power budget, decisions, test plan, commissioning,
    assembly, limitations, pin map, sources (Vietnamese, every claim tagged
    ĐÃ XÁC MINH / ƯỚC TÍNH / CHƯA KIỂM THỬ); host unit test log.
    - tools/check_pinmap.py: checks board_pins.h against the schematic netlist
    (module pad -> GPIO, net names, ADC1 channels, unused pins).
    - board_pins.h / sdkconfig.defaults: comment-only updates (net names, J1).
    - gen_schematic.py / design.py: fall back to the copies in hardware/kicad/lib
    when the Espressif library checkout is absent (regenerated schematic is
    identical); library path overridab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
2026-10-29 Add EN test pad and net-name test pad labels; reproducible PCB output
    Hardware
    - TP11 on EN next to the reset button (schematic + PCB); TP9 (GND) moved
    to make room. Schematic: split the EN wire at the new T so kicad-cli
    connects it; fix stale notes (GPIO12 enables the dividers, EN is on
    TP11, not on J1).
    - Silkscreen: every test pad shows its net name (VBAT1, VBAT2, VIN1/2,
    VOUT1/2, 3V3_PWR, 3V3, GND, EN); TP numbers stay on the fab drawing.
    "NO CHARGE" under "CR2032 ONLY" as specified, "USER/BOOT" at SW1,
    R1/R11/R21 current links labelled first. Missing required labels now
    stop the generator instead of being dropped.
    - gen_pcb.py seeds KiCad's UUID generator, so regenerating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
    [th_sensor_h2-B_Cu.gbl, th_sensor_h2-B_Mask.gbs, th_sensor_h2-B_Paste.gbp, th_sensor_h2-B_Silkscreen.gbo, th_sensor_h2-Edge_Cuts.gm1, th_sensor_h2-F_Cu.gtl, th_sensor_h2-F_Mask.gts, th_sensor_h2-F_Paste.gtp]
2026-10-29 Add firmware build report; expand README
    - docs/reports/firmware_build.md: environment, locked component versions,
    fresh-clone build results for battery, debug and battery + prod overlay
    (sizes, memory, warnings), what was not done.
    - README: block diagram, key part configuration, version lock table,
    toolchain install, Matter commissioning summary, bring-up and current
    measurement steps.
    - architecture.md: realign the block diagram.
    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
2026-10-29 Update firmware build report with fresh-clone builds of 742f2a1
    battery, debug and battery + prod overlay all build from a fresh clone
    of the current firmware (exit 0, no warnings in project code); sizes and
    memory figures refreshed. The heap figures from `status` are the place to
    read runtime heap once a board exists.
    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
2026-10-30 Rev B: one CR2450, 41.5 x 57.5 mm board
    Power path: one CR2450 in an SMT holder (MYOUNG BS-24-B4AA016) ->
    0R link -> AO3401A reverse-polarity FET -> one TPS63900 at 3.3 V
    (SEL = GND, RCFG3 16.2k; 100 mA input limit) -> VOUT -> 0R link ->
    +3V3. No output diode: the cell is the only source. Input buffer
    10 uF + 2 x 100 uF MLCC + 470 uF electrolytic. J1 shrinks to 1x6 pads
    without a supply pin; test pads VBAT, VIN, VOUT, 3V3, GND, EN.
    Board: 72 x 58 mm -> 41.5 x 57.5 mm, holder along the bottom edge,
    converter block rotated 180 degrees, SHT40 tongue cut free by one
    L-shaped slot. 0 unrouted, ERC/DRC/parity 0; the pours are refilled
    under the final project rules before the board is saved.
    Silks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
    [bom_jlc.csv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]
2026-10-30 Docs for Rev B: one CR2450, 41.5 x 57.5 mm board
    Power budget rewritten from the one-cell model: a fresh CR2450 at
    25 degC passes every profile; from about half capacity, or at <= 0 degC,
    boot and commissioning reset, so any reset after mid-life can leave the
    device down until the cell is replaced; reports fail at the late state;
    ~0.55-0.77 years at ~64 uA (ESTIMATE). The CR2450 pulse resistance is
    scaled from CR2032 data and is the largest open risk (T-35).
    Architecture, decisions (new D20), limitations, test plan (TP1-TP6,
    holder check T-08, electrolytic leakage T-39, corrected reverse-polarity
    current through the sense divider), commissioning (fresh cell at room
    temperature, bench supply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
2026-10-30 Firmware build report: fresh-clone builds of Rev B (359f772)
    battery, debug and battery + prod overlay build with exit 0 from a
    fresh clone; component hashes match dependencies.lock; 0 compiler
    warnings in project code; image ~270 B smaller than Rev A.
    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
2026-11-05 Remove USB series resistors R28/R29 (D+/D- straight to J1)
    At the user's request: USB D+/D- now run straight from the module to
    the unfitted J1 pads (8-11 mm, no vias). 41 fitted parts, BOM 28 lines.
    ERC/DRC/parity 0, 0 unrouted, pin map OK, regeneration byte-stable.
    Firmware unchanged apart from the board_pins.h comments (battery build
    identical in size).
    Dropping one of the two 100 uF rail capacitors was checked with the
    power model and rejected: fresh-cell commissioning at 10 degC goes
    from ok to reset. Recorded in docs/decisions.md D14.
    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
    [bom_jlc.csv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]
2026-11-06 TH-SENSOR-H2C Rev A: bare ESP32-H2 chip variant on a 4-layer board
    - design.py: TH_VARIANT=chip replaces the module with an ESP32-H2FH4S
    (QFN32), a 32 MHz crystal (L3 24 nH, C49/C50), HDG decoupling C40-C48,
    U0TXD 499R, a CLCCL RF match in 0201 (start values) and a TI DN007
    inverted-F PCB antenna drawn as its mirror image; J1 becomes 2x3
    - gen_pcb_chip.py: 4-layer layout (JLC04161H-7628): 50-ohm RF line on L1
    over L2, HDG stub on C51 with L2 cleared under it, 9 exposed-pad vias,
    +3V3 island on L3, no copper on any layer under the antenna;
    ERC 0, DRC 0, 0 unconnected, parity 0
    - router.py: optional zone-aware clusters, via size per net, no vias in
    SMD pads; defaults unchanged, R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
    [bom_jlc.csv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]
2026-11-06 TH-SENSOR-H2W Rev A: ESP32-H2-WROOM-02C variant on a square board
    New variant (TH_VARIANT=wroom, files in hardware/wroom/): ESP32-H2-WROOM-02C-H4S
    module, bought and hand-soldered by the user (not in the JLC BOM/CPL), on a
    4-layer board of 37.6 x 31.6 mm whose top edge is the module's antenna boundary,
    so board plus overhanging antenna fill a 37.6 x 37.6 mm square. The width is the
    CR2450 holder land pattern (37.0 mm) plus 0.3 mm copper-to-edge on each side; the
    holder moves to the back so that it overlaps the module.
    - design.py: wroom variant (U4 WROOM-02C, J1 2x3), same circuit as Rev B
    - gen_schematic.py: WROOM-02C symbol and footprint drawn from datasheet v1.2
    (table 2, figure 7), pl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
    [bom_jlc.csv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]
2026-11-07 H2W: side-push USER button at the left edge, no RST button, SMD debug pads
    As asked for the WROOM-02C board (shape unchanged):
    - SW1 (USER/BOOT, GPIO9) is now a Panasonic EVQP7A01P side-push switch (LCSC
    C79167, no locating bosses, KiCad footprint SW_SPST_EVQP7A, land pattern
    checked against the Panasonic drawing) in the middle of the left edge, knob
    0.5 mm over the edge
    - SW2 (RST) removed on this variant: reset by shorting TP6 (EN) to GND or by
    the USB-Serial/JTAG reset; R22/C25 stay
    - J1 becomes six 1.6 mm SMD pads in the 2x3 / 2.54 mm layout (new footprint
    TestPads_2x03_P2.54mm_SMD), no holes; test pads were already SMD
    - C5 moves to where SW2 was; UART lines routed before USB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
    [bom_jlc.csv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]
2026-11-08 H2W: tantalum C5 and SHT40 on the back of the sensor tongue
    Requested change for TH-SENSOR-H2W Rev A (option 1 of the three offered):
    - C5 470 uF 6.3 V is now a Kyocera AVX TAJD477K006RNJ tantalum (MnO2,
    case D 7343-31, 3.1 mm max, LCSC C7229) instead of the 7.7 mm aluminium
    can. It stays on the front, which is now no taller than the module:
    about 12.3 mm for the whole assembly instead of 16.8 mm (estimated from
    nominal heights).
    - SHT40 (U5) and C29 moved to the back of the tongue, sensor facing down.
    The four lanes cross the bridge on B.Cu and drop to four staggered vias
    right after it; R26/R27 swapped to match the via order. The tongue still
    has no vias and no pour.
    - Silksc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
    [bom_jlc.csv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]
2026-11-08 H2W: SHT40 back on the front; wall mount with the button edge down
    The user wants the sensor on the same side as the other parts, and both
    the sensor and the button at the bottom when the board is on a wall.
    They chose to keep the layout and mount the board with the left edge
    (SW1) towards the floor: SW1 is then pressed from below and the SHT40
    tongue is the lowest corner, under the module; the module's antenna
    points sideways (effect on range not tested, W-01).
    - SHT40 (U5) and C29 back on the front of the tongue with the routing of
    15f9b11 (R26/R27 back in place, no B.Cu lanes, tongue label on the
    back as before). The tantalum C5, its "+" mark and the 2026-11-08 date
    stay.
    - Product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
    [cpl_jlc.csv, th_sensor_h2w-B_Cu.gbl, th_sensor_h2w-B_Mask.gbs, th_sensor_h2w-B_Paste.gbp, th_sensor_h2w-B_Silkscreen.gbo, th_sensor_h2w-Edge_Cuts.gm1, th_sensor_h2w-F_Cu.gtl, th_sensor_h2w-F_Mask.gts]
2026-11-09 H2W: product name on the back silkscreen
    User's text on the back, in the band above the cell: "Matter temperature
    Sensor", "Villa Nest" (bold), "Made in Vietnam". It replaces the
    "TH-SENSOR" line; the cell warnings, "H2W Rev A", the date and the
    SHT40 label stay. Docs note that the product is not Matter certified.
    ERC 0, DRC 0, unconnected 0, parity 0; board regenerated byte-identical.
    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
    [th_sensor_h2w-B_Cu.gbl, th_sensor_h2w-B_Mask.gbs, th_sensor_h2w-B_Paste.gbp, th_sensor_h2w-B_Silkscreen.gbo, th_sensor_h2w-Edge_Cuts.gm1, th_sensor_h2w-F_Cu.gtl, th_sensor_h2w-F_Mask.gts, th_sensor_h2w-F_Paste.gtp]
2026-11-11 firmware: fix four review findings, add CR123A cell profile
    Power guard: the first early reset no longer starts the deep-sleep
    backoff (APP_GUARD_FREE_BOOTS); a new cell is recognised by a reading in
    the fresh range that has also risen (APP_GUARD_FRESH_CELL_MV and
    APP_GUARD_NEW_CELL_RISE_MV, replacing APP_GUARD_RECOVERY_MV); USB/JTAG
    resets count as requested restarts; a reading below the cell-present
    threshold is treated as a sense fault instead of an empty cell; the LED
    blinks three times before the guard sleeps.
    Commissioning: a triple press with no fabric left and BLE already
    released restarts the device so that it advertises over BLE again.
    Battery: each measurement takes two samples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
    [board.c, board.h]
2026-11-11 hardware: TH-SENSOR-H2W-123 Rev A, CR123A variant of the WROOM-02C board
    New variant TH_VARIANT=wroom123 (hardware/wroom123/): the H2W circuit
    powered by one CR123A in a through-hole holder (MYOUNG BH-123A-A1CJ002)
    that sits beside the electronics. 4-layer board 53.3 x 47.3 mm, square
    53.3 x 53.3 mm with the module's antenna overhang; electronics area
    34.5 mm wide as requested. Cell on the left, module in the top-right
    corner (16 mm from the holder), SHT40 tongue in the bottom-right corner,
    side-push button on the bottom edge, all parts on the top side.
    Compared with H2W: no 470 uF bulk capacitor (the model in
    hardware/analysis/cr123a_study.py shows the cell carrying every load
    profile with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
    [bom_jlc.csv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]
2026-11-11 hardware: H2W-123 reduced to the electronics only, cell beside the board
    Second request of the same day: lay out only the electronics part of the
    previous drawing, as small as possible, sensor and button still on the
    bottom edge. The board is now 24.8 x 37.3 mm (43.3 mm with the antenna
    overhang) instead of 53.3 x 47.3 mm; next to an 18.2 x 43.3 mm CR123A
    holder the whole device is about 43.3 mm square.
    - The cell is no longer on the board: BT1 is two plated wire holes on
    the left edge (square = +), not in the BOM. The fuse F1 follows the
    + hole.
    - SHT40 tongue in the bottom-left corner, side-push button on the bottom
    edge 7.4 mm from the right edge, module still in the top-right corn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
    [bom_jlc.csv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]
2026-11-11 hardware: H2W-123 as a 2-layer board
    The inner layers of the reduced CR123A board carried no tracks, only
    ground; on request the board is now 2-layer. Placement, the hand-laid
    back-side lines and the routing order are unchanged.
    - 0.6 / 0.3 mm vias (JLC 2-layer standard, the Rev B rules); the
    module's left escape vias move 0.25 mm inwards and the tongue ground
    via 0.35 mm up to keep hole and edge clearances.
    - gen_project.py applies the 4-layer via rules to the H2W board only;
    gen_production.py exports two copper layers for this board.
    - Ground pour on both sides; pockets of fill that hang on the rest by a
    neck narrower than 0.13 mm are closed automatically with small no-pour
    area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
    [th_sensor_h2w123-B_Cu.gbl, th_sensor_h2w123-B_Mask.gbs, th_sensor_h2w123-B_Paste.gbp, th_sensor_h2w123-B_Silkscreen.gbo, th_sensor_h2w123-Edge_Cuts.gm1, th_sensor_h2w123-F_Cu.gtl, th_sensor_h2w123-F_Mask.gts, th_sensor_h2w123-F_Paste.gtp]
